OAK-WJR/mooon-whiteboard-robot/hardware/top_board_v2/BATTERY_SELECTION.md

# Battery selection and power redesign — 2026-09-07

> **Superseded since 2026-10-28:** the current board `top_board_v2_logic` (EasyEDA) charges the 2S battery over USB-C on the board with an IP2326, and on 2026-10-29 the CH343G was removed in favor of the C6's native USB; see [hardware/README.md](../README.md). The external charging and "the top board does not charge" below are records from 2026-09.

**Latest requirement: the user has agreed to external charging; the current basis is the [low-cost top board simplification plan](jlc_budget_6v/KISS_SCOPE.md) and the [external charging kit](jlc_budget_6v/external_charging/README.md). The new top board drops on-board charging, balancing and the on-robot charging port. The ready-made module, R3, on-board USB charging and 12V compatibility content below are all historical records and are no longer current requirements.**

The user has chosen the **GAONENG GNB8502S80A: 2S 7.4V, 850mAh, 80C, XT30**, and asked to solve charging, purchase cost, Amazon availability and fixing the battery to the PCB. The new circuit is designed around this battery; it has not passed whole-robot release, and has not been ordered.

Manufacturer specs: 60 × 30 × 16 mm, 56 ± 2 g, nominal energy 6.29 Wh, XT30 discharge connector. The manufacturer's current page is for a multi-pack, so its price must not be mistaken for a single-battery price. [Manufacturer product page](https://www.gaoneng.shop/products/gaoneng-gnb-2s-7.4v-850mah-80c-xt30-lipo-battery).

During this round's cost re-check, the manufacturer's page for the same model clearly lists a charge rate of **1C–5C**. This updates the earlier information where the rate was unconfirmed, but it is not the current this board can provide: the existing R3 only has a low-current USB input draft, the charge enable R503 is not fitted, and per-cell protection and interlocks are still not done. The charge setting was not raised and actual charging was not authorized on this basis; the temperature range, maximum per-cell voltage, low-voltage recovery and actual battery state still need to be confirmed separately.

The original candidate was the four separate 1S 3.7V, 2000mAh, 1C, PH2.0 protected batteries in the listing title the user provided. Using the title's 1C discharge marking, each is about 2A and nominally 7.4Wh. No manufacturer datasheet was obtained for this battery; the continuous/pulse definitions, protection cutoff current, wire gauge and polarity were not confirmed. Assuming 85% boost efficiency, one cell at 3.7V and 2A can only provide about 6.29W: about 1.05A at 6V and about 0.52A at 12V, before subtracting the logic supply; this is not a measured result. [C-rate definition](https://learn.sparkfun.com/tutorials/what-is-a-battery/all?print=1).

The 2S 850mAh has about 85% of the original candidate's energy; it does not have only 43% of the run time just because 850 is less than 2000. Motor load, conversion efficiency and cutoff voltage are not yet known, so no specific run time in minutes can be promised. 80C is the manufacturer's rating; the 68A it works out to must not be taken as a current the connector, protection or PCB can carry continuously.

Selection direction: a small 2S power battery with the standard 4.2V/cell, avoiding an overly long battery chosen only for capacity. The current selection is for three 6V GA12-N20 encoder motors; the earlier MECCANIXITY 12V model is kept only as a historical reference. For the exact links and the limits of reusing the base board, see [base board and motor review](bottom_board_review/README.md). The exact stall current and encoder harness definition are still to be confirmed; generic N20 current parameters are not borrowed.

Circuit changes that must be made:

- The new battery input and protection are designed for the 2S working voltage; use a matching XT30 connector and check the connector view and polarity. The current R2's BAT 1S, TP4056 and ME6217 power path **cannot be connected directly to this 2S battery**.
- A fixed 6V is produced by a ready-made buck module, and the battery voltage is not connected directly to the 6V motors; module choice, default shutdown, current limiting and regeneration handling still need to be finalized.
- USB charging must change to a 2S charging solution, with per-cell voltage sensing, balancing and protection; this power battery's built-in BMS/protection is not confirmed by the manufacturer's page, so the original candidate's "integrated protection" description cannot be reused.
- The main logic supply needs USB/battery power switching and power-off isolation; a separate USB recovery bridge has been integrated into the R3 schematic review draft, and its electrical margins and real-board timing have not been verified.
- The same USB-C port handles data and charging. Computer USB, enumeration not finished, suspend, and different Type-C current advertisements must each be handled; not all USB power is treated as 3A.
- The cost count includes the battery, on-board charging and protection, USB recovery, battery and balance connectors, wires, and straps/brackets; mark pack quantities, and separate component reference prices from whole-board assembly cost.
- The current top board's outline bounding box is 62.411 × 54.229 mm, and the shape is a truncated triangle. A 60 × 30 mm battery cannot be claimed to fit fully inside the board outline from the bounding box size alone; mounting position, thickness, wire bending space and antenna distance are to be verified.
- The fixing method should have an insulating support surface and controlled clamping force, so straps do not press on components, solder joints or the corners of the pouch battery; slots must be checked against copper layers, board edge margins, mating connectors and the antenna area.

Options not chosen: the Gens ace 2S 2200mAh 60C hard-case model is 92.8 mm long and about 107g, too long; the Tattu 3S 850mAh 75C is 60 × 30 × 23 mm and about 80g, thicker and heavier; the Tattu 2S 650mAh 75C is 57 × 31 × 12 mm and about 43g, and can serve as a thinner backup with less energy. The manufacturer pages are [Gens ace](https://www.genstattu.com/gens-ace-2200mah-2s-60c-7-4v-hardcase-g-tech-lipo-battery-pack-with-xt60-plug/), [Tattu 3S](https://genstattu.com/tattu-850mah-11-1v-75c-3s1p-lipo-battery-pack-with-xt30-plug.html), [Tattu 2S](https://www.tattuworld.com/products/tattu-classic-650mah-2s1p-7-4v-75c-fpv-lipo-battery.html).

This choice does not change the R2 files or their not-released-for-manufacturing status. The final battery/protection/power stage match will be made after the stall current and mounting space of the exact motor version above are confirmed.

Follow-up check results:

- [Procurement record](procurement/SOURCING.md): the GNB official site shows a four-pack at $34.40, or $8.60 each; Amazon stock of the exact model was not verified. A standard Tattu 2S Amazon catalog candidate is kept; the battery was not swapped without permission.
- [Cost update](procurement/R3_COST_UPDATE.md): the 16 priced core chips and two inductors total $37.92; adding the planned protection chip at $5.63 and one battery's share at $8.60 gives a reference subtotal of $52.15. The full parts list, motor power, PCB, assembly, fixings, shipping and tax are still missing; this is not a whole-board quote.
- [Mounting study](mounting/MOUNTING_REVIEW.md): a nominal 60×30 mm battery cannot fit fully inside the existing triangular board outline at any in-plane rotation angle. The chosen direction is a raised insulating bracket; in the current projection example the max overhang is about 9.62 mm; the actual enclosure space and height are to be confirmed.
- A separate [R3 mechanical layout draft](kicad/r3_mechanical/README.md) has been generated, with four bracket holes and four-layer keep-out areas, keeping the original board outline and 19 mating pins. It is not routed yet and is not a finished, modified circuit.
- The current charging implementation direction is BQ25798 + separate per-cell protection/balancing, and power and protection still need full integration; the [initial charging research](charging_research/CHARGING_DECISION.md) keeps the BQ25883 comparison and protection limits. Plugging in USB stops the motors by default, but an explicitly authorized, time-limited USB motor bench test is allowed; during the test, power comes from the protected battery, and charging is actively inhibited.
