OAK-WJR/mooon-whiteboard-robot/hardware/top_board_v2/jlc_budget_6v/controller_core/logic/ADC_POWER_OFF_REVIEW.md

# Power-off check of the top voltage sensing

The current two 120kΩ/10kΩ dividers and 100nF filters still connect directly to C6 GPIO4/5. **No power-off isolation has been added yet, and there is no actual injection current test.** This check quantifies the conditions still to be solved; the analog switch was not added directly to the board BOM.

Done later: [a specific candidate with 20kΩ on each side of the switch, and its simulation](adc_isolation_review/README.md): the nominal ratio stays 13, a bleed is added on the MCU side, and the 100nF stays before the switch. 32 analytic combinations and 6 ngspice condition models found gaps with a fast supply drop and with the filter capacitor position, so the candidate has not been added to the main drawing yet. These are generic models; the chip manufacturer's full transient model was not used, and no real-board power-off pass conclusion was obtained.

Under the calculation condition that the MCU pin does not load the divider, and counting the resistors' initial ±1%, an 8.4V input gives at most about 0.6582V at the sense point; at VMOT=6.2188V it is about 0.4873V. Losing the controller supply does not make these external inputs go away by itself.

If, only for sensitivity analysis, the pin is assumed to be clamped at 0.3V by some path, the dividers could still supply about 38.48µA and 20.12µA respectively. **0.3V is an assumption of this example; it is neither a measured clamp characteristic nor an injection current the manufacturer allows.** The 50nA input current and VDD+0.3V conditions in C6 table 5-4 are listed in the DC characteristics at 3.3V and 25°C, and cannot be extrapolated to an allowed injection current at VDD=0 or to absolute maximum ratings. The manual gives no power-off Ioff guarantee in these tables that could be used for this design. [Espressif C6 v1.5 §5.1, §5.4](https://www.espressif.com/sites/default/files/documentation/esp32-c6_datasheet_en.pdf).

As one specific solution direction, the TI TMUX1511 was checked; it has not been chosen for the design. It allows 0–3.6V on the signal pins when VDD<1.5V; with VDD=0, source 0–3.6V and drain 0V, the max absolute power-off leakage is 2µA. The max 4µs power-off time in the manual has explicit conditions of a 1µs supply drop, 200Ω load and 15pF capacitance, and cannot be applied directly to the top board's power-off waveform. [TI TMUX1511 Rev.B §5.3, §5.5, §5.7](https://www.ti.com/lit/ds/symlink/tmux1511.pdf).

The later circuit must solve all of these together: the bleed path on the MCU side after isolation and the change in divider load, the charge the 100nF capacitor keeps at the moment of power-off, the actual supply drop of the controller and the switch, and the cost of the new part. Only putting an analog switch in series in the current drawing is not enough to prove the whole power-off process passes. This part is not currently chosen, and no extended part fees were added. The [ADC read-only firmware](ADC_READOUT.md) is implemented, but it cannot confirm the power-off electrical behavior.

[The matching values, conditions and source file hashes](verification/adc_power_off_review.json). This check is circuit analysis, not a transient simulation of the switch chip, real fault injection, or a board stability pass result.

After the ADC comment update, the original numeric report is kept; the evidence that the electrical parameters did not change is in the [revision link](verification/adc_revision_evidence.json).
