OAK-WJR/mooon-whiteboard-robot/docs/design-history/v1-schematic.jpg

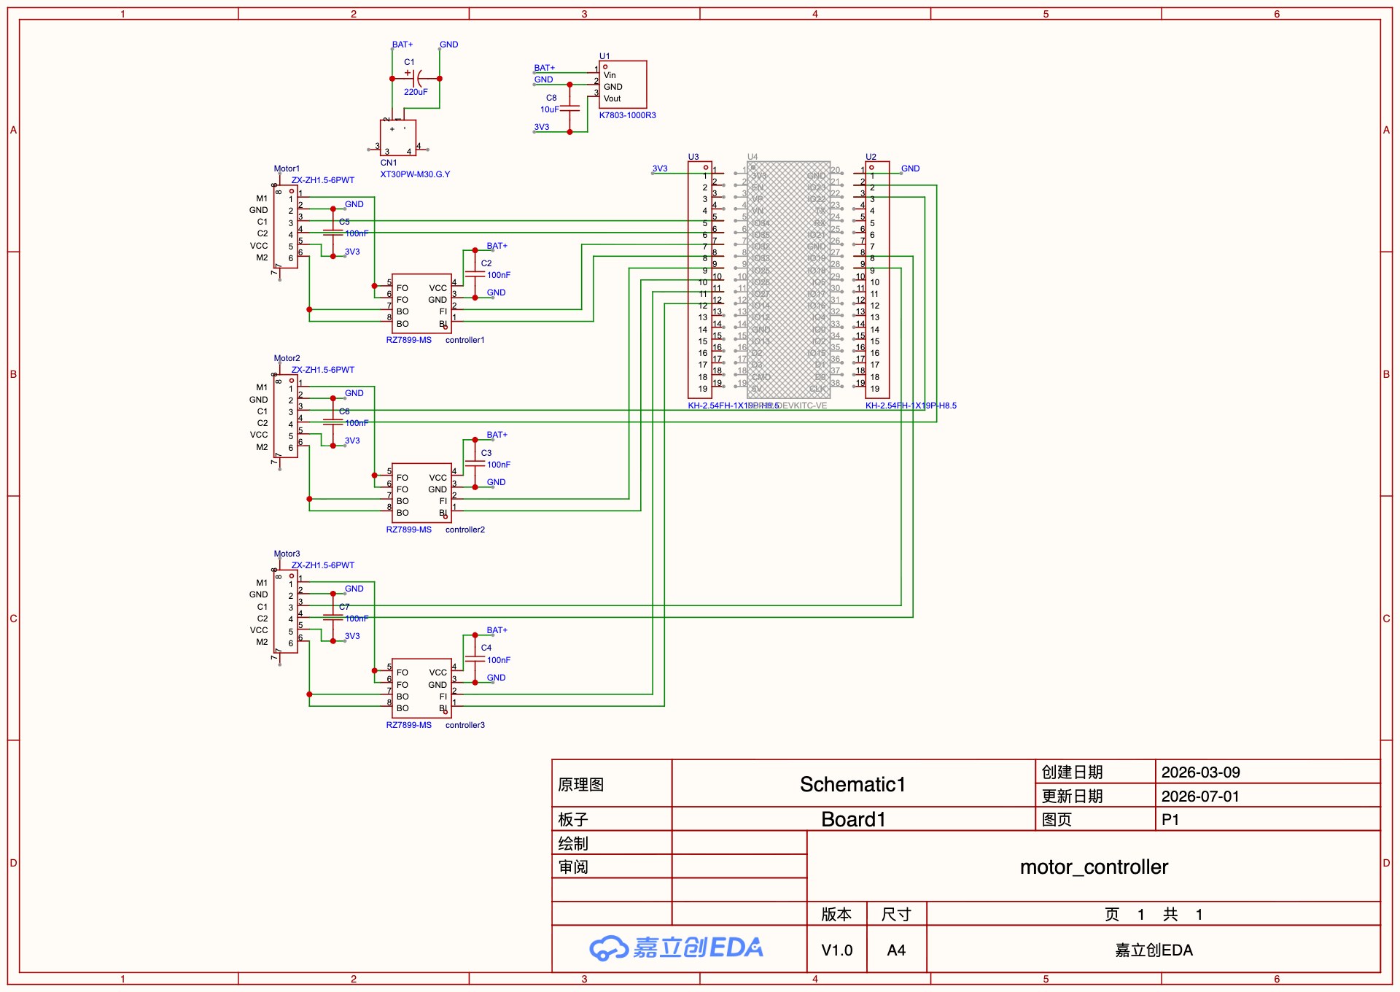
docs/design-history/v1-schematic.jpg
