OAK-WJR/mooon-whiteboard-robot/docs/media/coverage-run-final.jpg

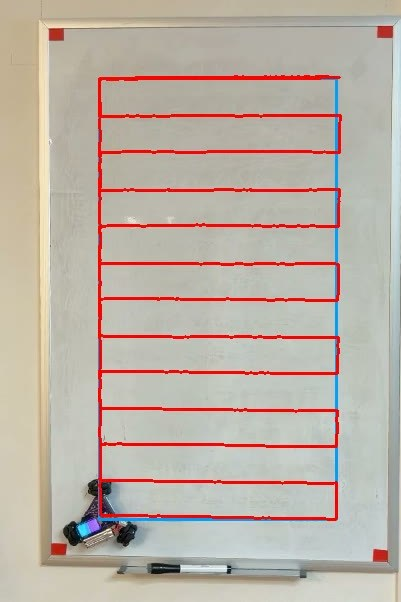
docs/media/coverage-run-final.jpg
