OAK-WJR/mooon-whiteboard-robot/hardware/top_board_v2/bottom_board_review/bottom_schematic.webp

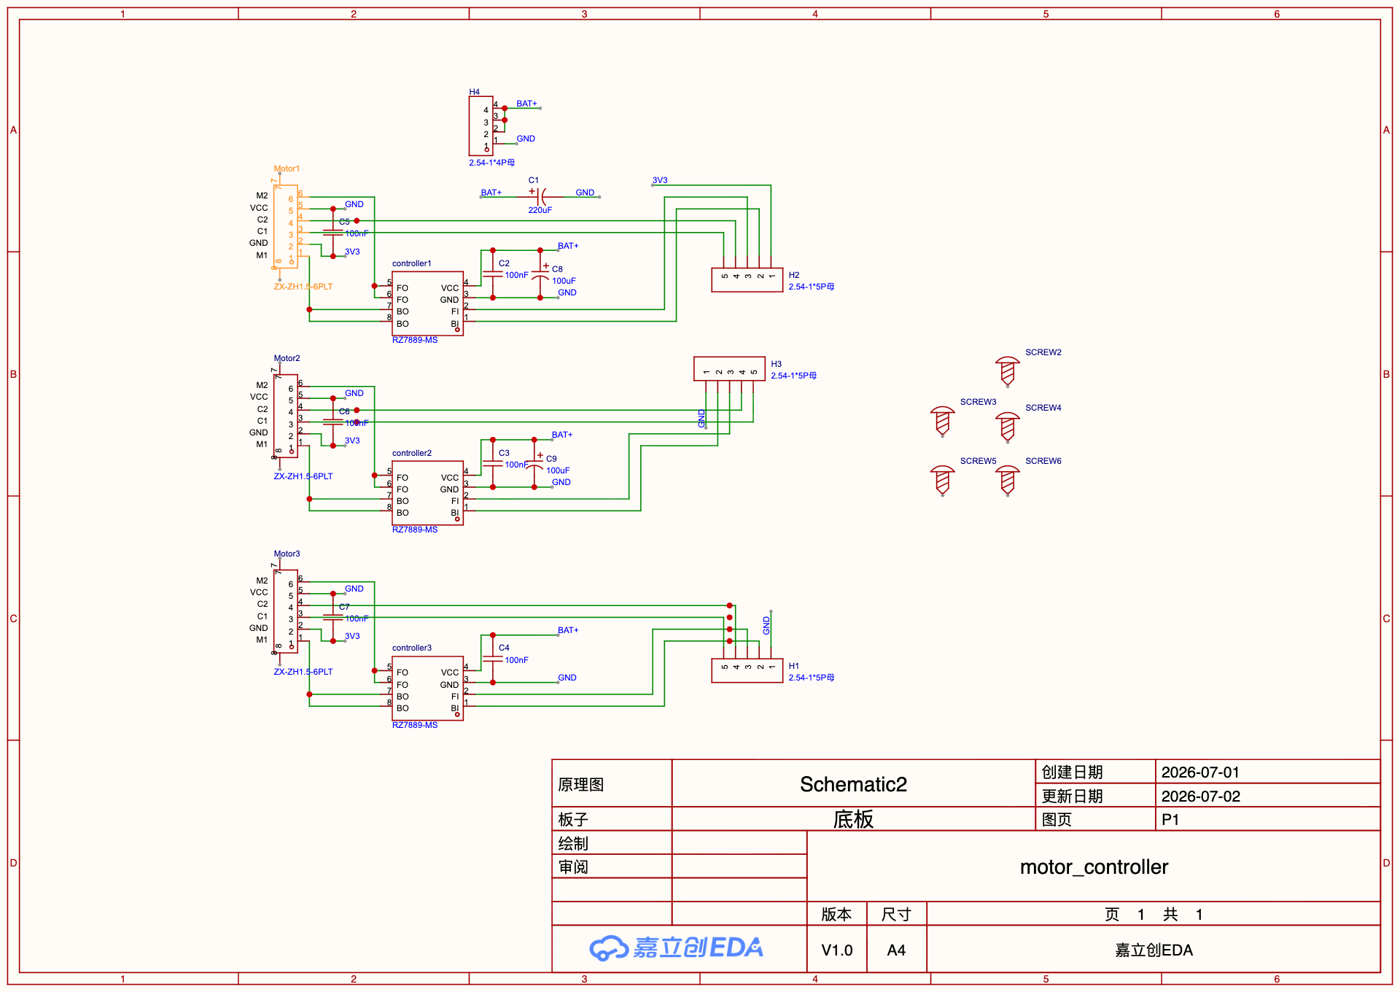
hardware/top_board_v2/bottom_board_review/bottom_schematic.webp
