OAK-WJR/mooon-whiteboard-robot/hardware/top_board_v2/jlc_budget_6v/controller_core/logic/preview/placement.png

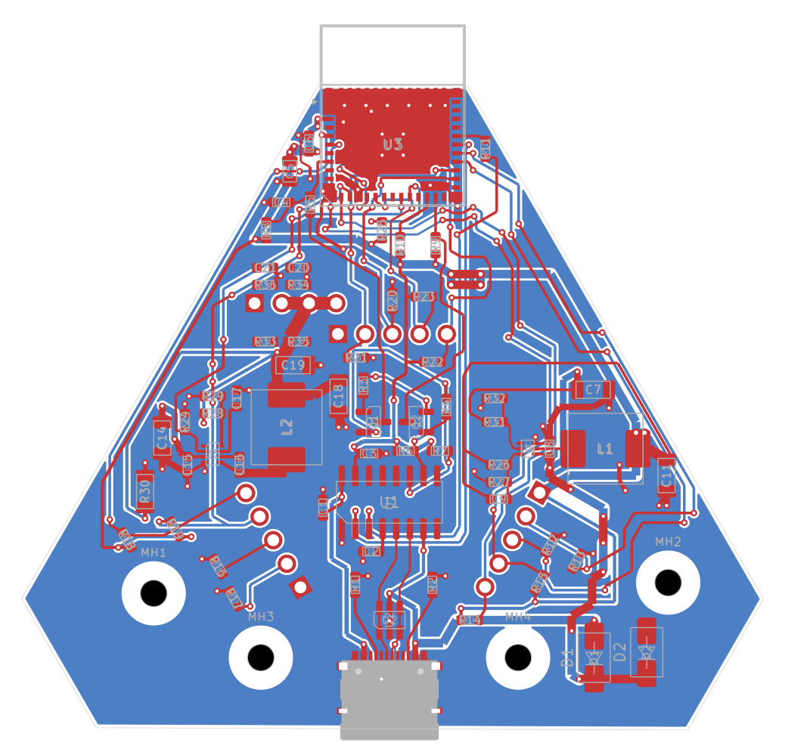
hardware/top_board_v2/jlc_budget_6v/controller_core/logic/preview/placement.png
