OAK-WJR/mooon-whiteboard-robot/hardware/top_board_v2/kiss_6v/electrical_layout/carrier_preview.png

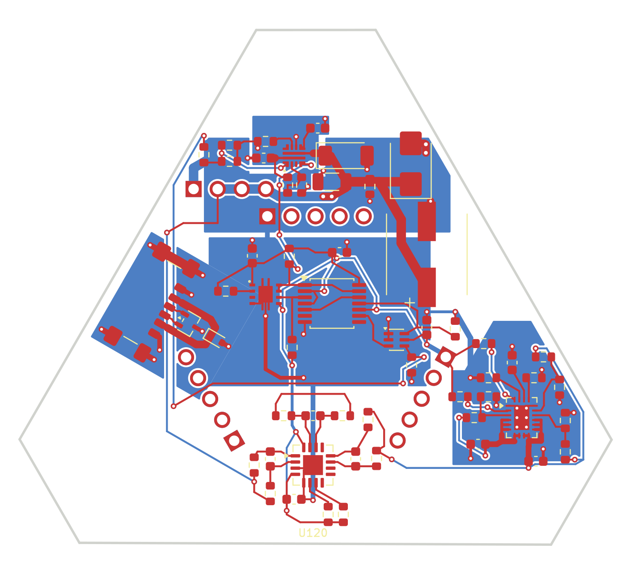
hardware/top_board_v2/kiss_6v/electrical_layout/carrier_preview.png
