OAK-WJR/mooon-whiteboard-robot/hardware/top_board_v2/kiss_6v/module_fit.png

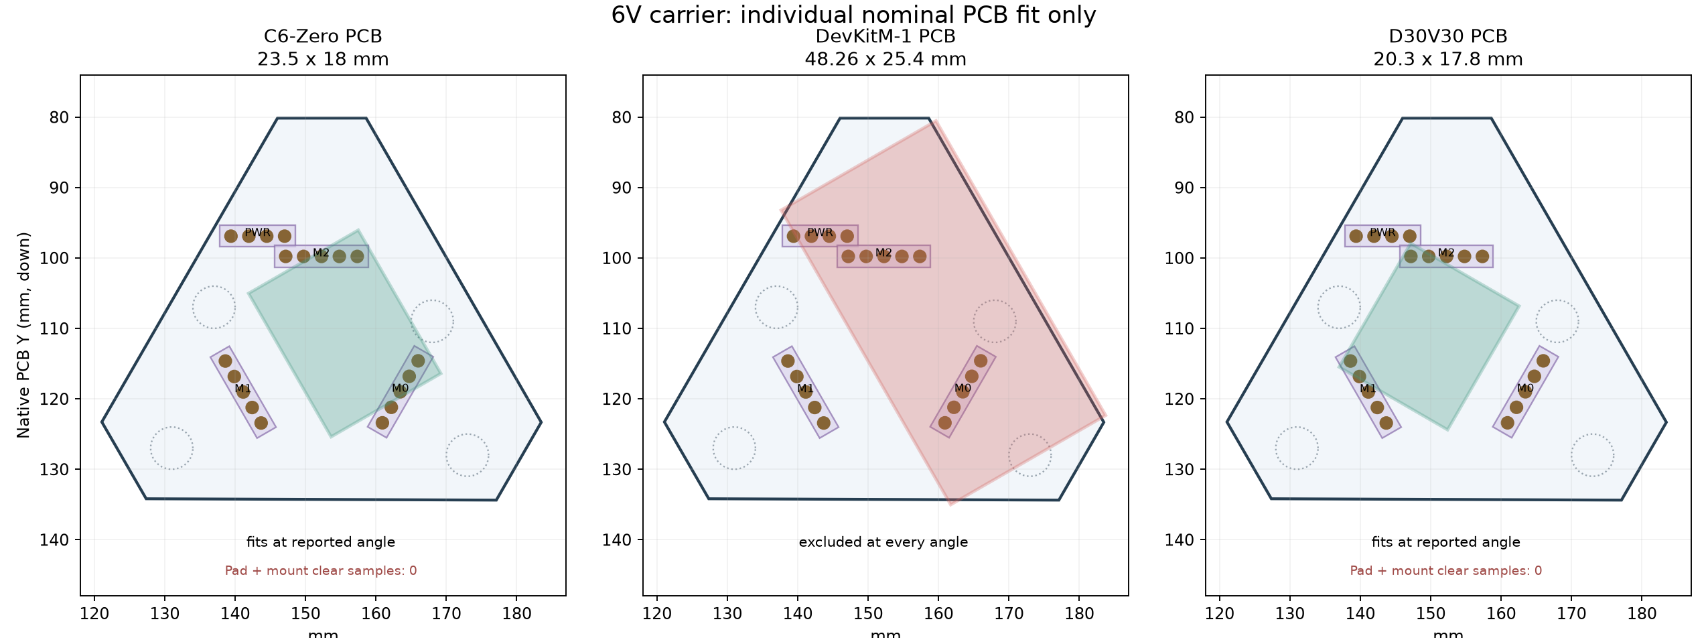
hardware/top_board_v2/kiss_6v/module_fit.png
