OAK-WJR/mooon-whiteboard-robot/hardware/top_board_v2/versions/20261027-curved-eda-canvas.png

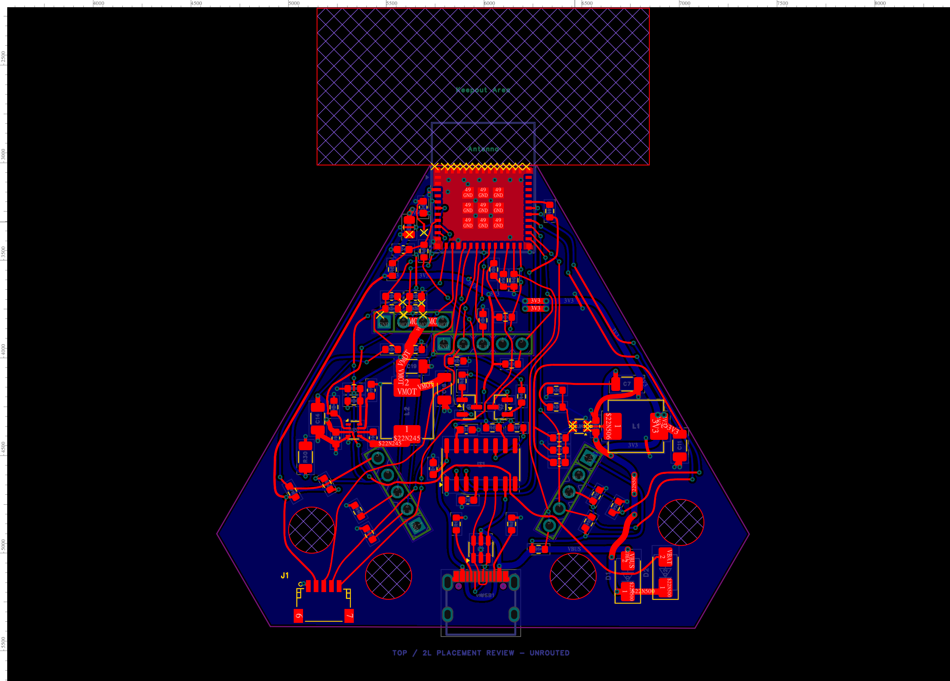
hardware/top_board_v2/versions/20261027-curved-eda-canvas.png
