OAK-WJR/mooon-whiteboard-robot/hardware/top_board_v2/versions/schematic_a3_v2.1.png

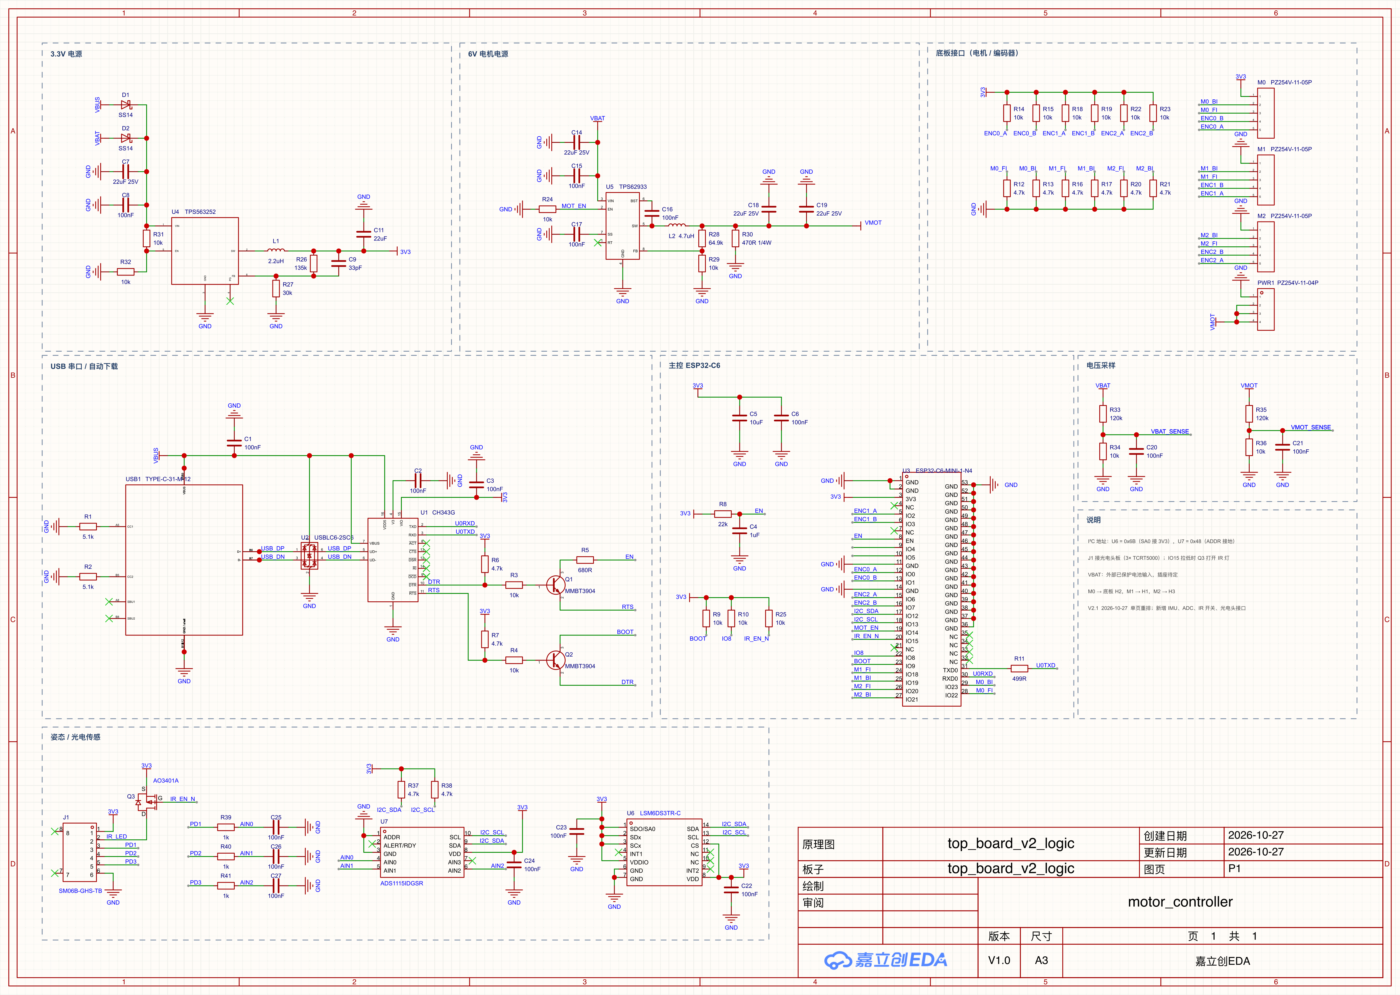
hardware/top_board_v2/versions/schematic_a3_v2.1.png
