OAK-WJR/mooon-whiteboard-robot/c6_wall/results/sysid-erase-1028-214624-erase.jpg

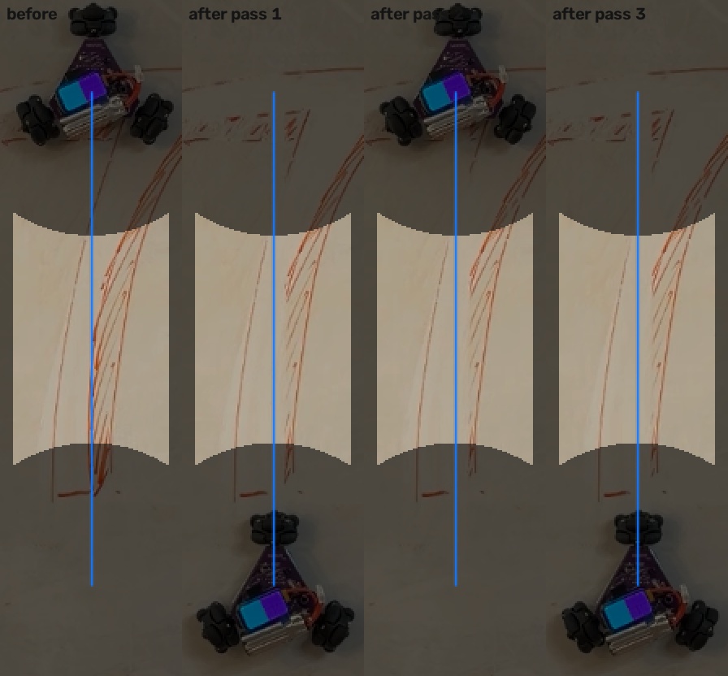
c6_wall/results/sysid-erase-1028-214624-erase.jpg
