OAK-WJR/mooon-whiteboard-robot/hardware/top_board_v2/validation/kicad_top.png

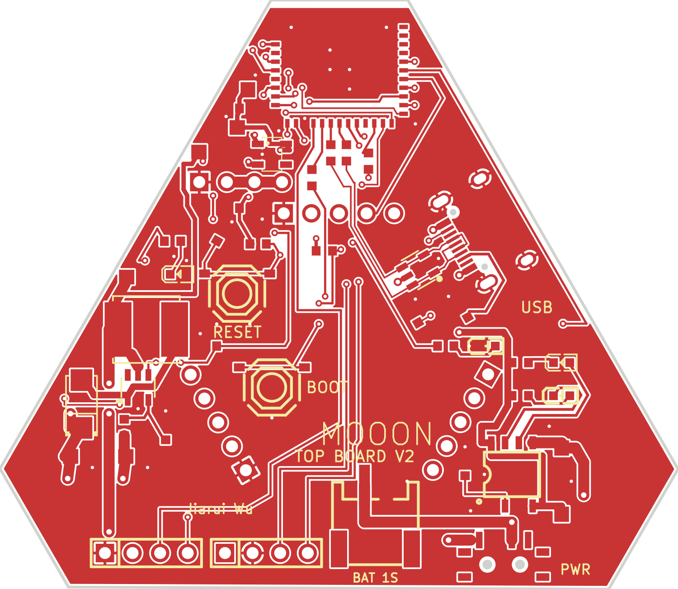
hardware/top_board_v2/validation/kicad_top.png
