OAK-WJR/mooon-whiteboard-robot/docs/design-history/README.md

# Design history

This page shows how the robot's mechanical design and circuit boards changed
over time, with evidence for each date.

## Where the images come from

- **EasyEDA previews.** EasyEDA Pro saves a preview of every schematic and PCB
  inside the project file each time the project is saved. Most images on this
  page are those previews, taken from
  [`hardware/top_board_v2/motor_controller.epro2`](../../hardware/top_board_v2/motor_controller.epro2).
  No image here was redrawn by hand.
- **Reproducible.** [`make_figures.py`](make_figures.py) rebuilds every figure
  directly from the git history of that file. It needs the full-history
  repository; this curated snapshot has only one version of the file:

  ```bash
  python3 docs/design-history/make_figures.py   # needs Pillow
  ```

- **Live capture.** `logic-pcb-live-2026-10-28.png` was captured from the
  running EasyEDA editor on 2026-10-28 through the EasyEDA API.

Dates come from three sources. Each caption says which one it uses:

1. **Schematic title blocks.** EasyEDA fills in the creation and update dates
   automatically.
2. **Commit timestamps** of the project file.
3. **The EasyEDA backup file names**, which carry the save time.

The October commits were added to git on 2026-10-28 from those timestamped
backups, in the full-history repository.

## Mechanical CAD (Onshape)

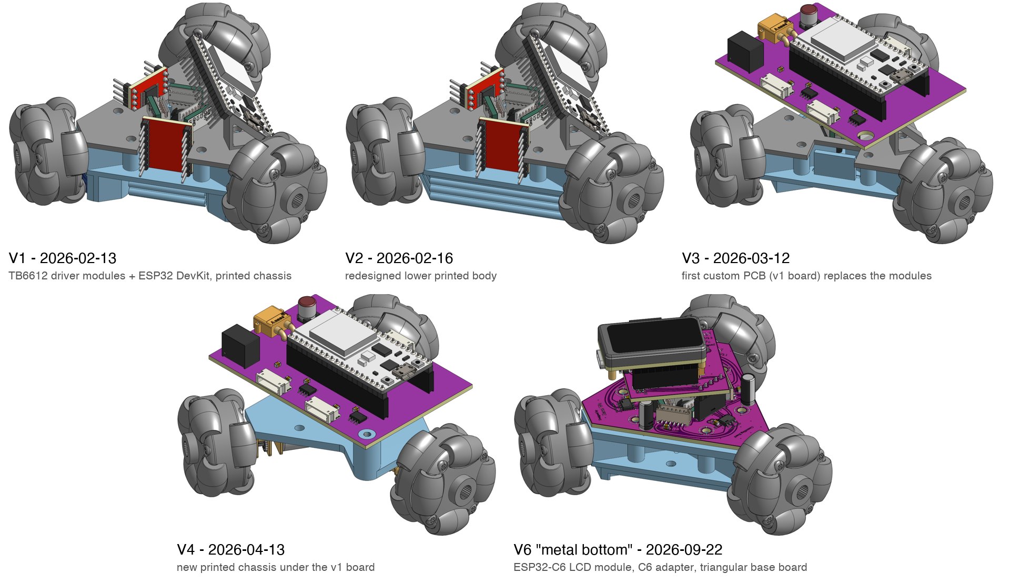
[picture p18: docs/design-history/cad-versions.jpg]
Onshape versions of the robot assembly


The robot is modelled in an Onshape document named "WhiteBoardBot", created on
2026-02-08. Onshape timestamps every named version on its own servers, so
these dates cannot be edited afterwards. Each render above is Onshape's shaded
view of the assembly "Assembly 1" at that version, fetched through the Onshape
API on 2026-10-28 with every part shown, including parts that were hidden
when the version was saved. Full-size renders are in [`cad/`](cad/).

| Version | Created (Onshape server time, UTC) | What changed |
|---|---|---|
| Start | 2026-02-08 19:05 | Empty document |
| V1 | 2026-02-13 21:26 | Off-the-shelf modules: two TB6612 driver boards and an ESP32 DevKit on a printed chassis, with 38 mm omni wheels and N20 motors |
| V2 | 2026-02-16 02:41 | Redesigned lower printed body |
| V3 | 2026-03-12 19:40 | The first custom PCB, imported as `3D_PCB1_2026-03-10.step` from EasyEDA, replaces the modules |
| V4 | 2026-04-13 19:39 | New printed chassis under the v1 board |
| V5 | 2026-07-03 21:44 | (same appearance as V4) |
| V6 "metal bottom" | 2026-09-22 03:08 | ESP32-C6 LCD module on the custom adapter board, on the triangular base board |
| V7 "fix the issue of gear stuck because of too tight top" | 2026-09-22 03:13 | Fixed the gears sticking because the top part was too tight |
| Workspace | last edit 2026-10-27 | Looks the same as V6 when every part is shown |

The CAD and the circuit-board dates agree:
- The first custom PCB was created in EasyEDA on 2026-03-09 (title block), and
  its 3D model is dated 2026-03-10.
- It appears in the CAD at V3, on 2026-03-12.

## Board generations

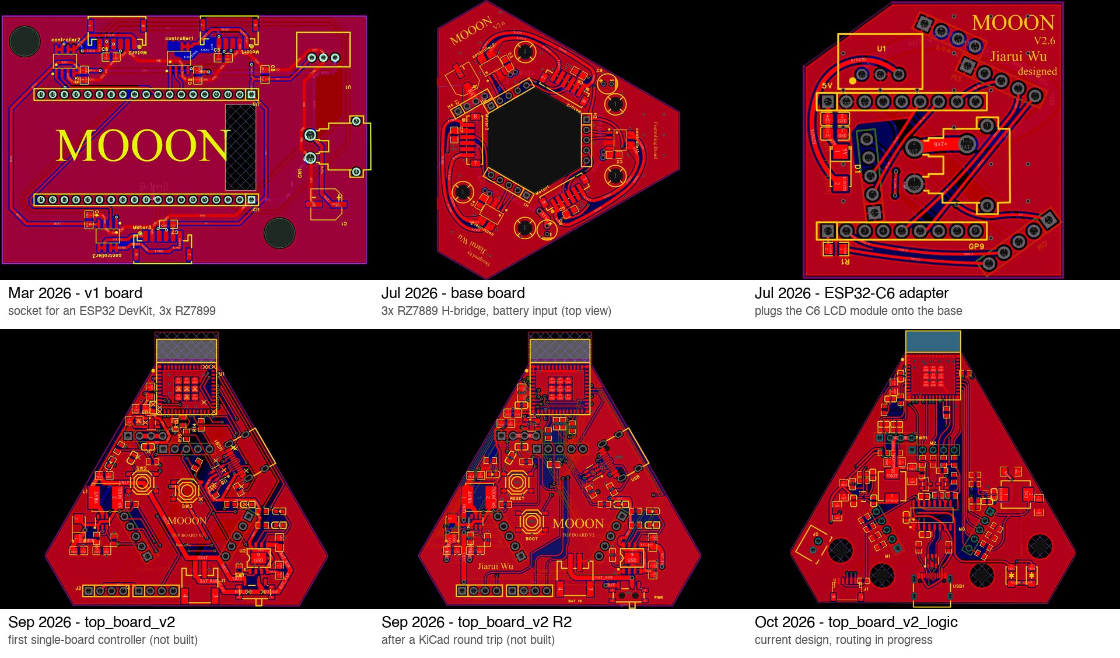
[picture p19: docs/design-history/board-generations.jpg]
Board generations


| Board | Dates (from the title block) | Notes |
|---|---|---|
| v1 board | created 2026-03-09 | Socket for a 38-pin ESP32 DevKit and three RZ7899 drivers. Its saved preview had inactive layers greyed out, so its contrast is stretched in the figure. Motor 1's encoder pins (GPIO36/39) picked up PWM noise, which led to the next generation. [Schematic](v1-schematic.jpg), [netlist](../../hardware/v1_base_board/). |
| base board (`bottom_board`) | created 2026-07-01 | Triangular base with three RZ7889 H-bridges and the battery input. Still in use. Its own preview is a bottom view, so the figure shows its top view from the fabrication panel (`combine`). |
| ESP32-C6 adapter (`top_board`) | created 2026-07-02, updated 2026-07-03 | Carries the Waveshare ESP32-C6-LCD module. The first fabricated adapter had the M1 header placed rotated 180°. The respin was brought up on 2026-09-17 and is in use now. |
| `top_board_v2`, R2 | September 2026 | First attempts at one integrated controller board. Never fabricated. |
| `top_board_v2_logic` | 2026-10-27 → | Current design: ESP32-C6-MINI-1 on native USB (CH343G removed 2026-10-29), 3.3 V and 6 V supplies, on-board 2S charging (IP2326) and INA180 motor-current sensing. |

The September directions that were explored in KiCad and dropped are covered
in [`hardware/README.md`](../../hardware/README.md#earlier-top-board-directions-not-fabricated):

| Direction | Image |
|---|---|
| R2, 4-layer | [image](../../hardware/top_board_v2/validation/kicad_top.png) |
| "KISS" 6V module carrier | [image](../../hardware/top_board_v2/kiss_6v/electrical_layout/carrier_preview.png) |
| Module-fit study | [image](../../hardware/top_board_v2/kiss_6v/module_fit.png) |
| Low-cost placement | [image](../../hardware/top_board_v2/jlc_budget_6v/controller_core/logic/preview/placement.png) |

## `top_board_v2_logic`, step by step (2026-10-27 → 2026-10-28)

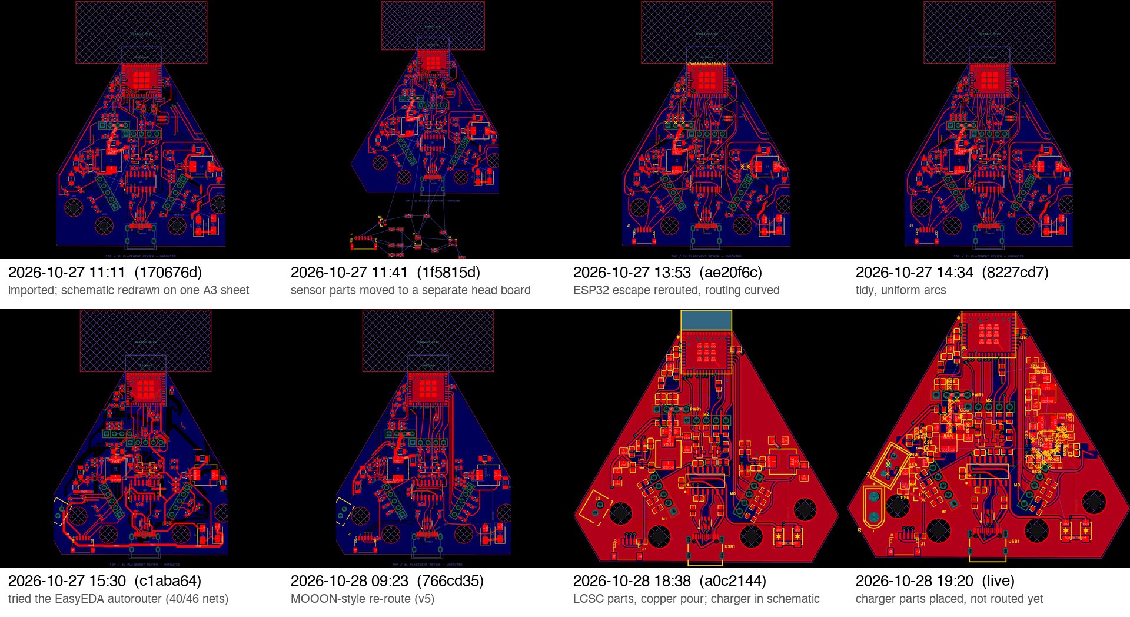
[picture p20: docs/design-history/logic-board-evolution.jpg]
Logic board evolution


Each frame is the PCB preview stored in the project file at that commit. The
last frame is the live editor. In the full-history repository, the full
message for any frame can be seen with:

```bash
git show <hash> --stat
```

Steps worth noting:

- **11:41, sensor head split off.** The IMU, ADC and IR emitter moved off the
  board, so their parts sit outside the outline, waiting for their own board.
- **13:53 → 14:34, curved routing.** All routing was converted to tangent
  arcs.
- **15:30, autorouter test.** EasyEDA's autorouter was tried; it completed 40
  of 46 nets and was not kept.
- **28 Oct, final steps.** A MOOON-style re-route, then a swap to LCSC-stocked
  parts with 3D models, then a copper pour. The 2S charger went into the
  schematic; it was placed and routed later (see
  [`hardware/README.md`](../../hardware/README.md)).

## Schematic: before and after

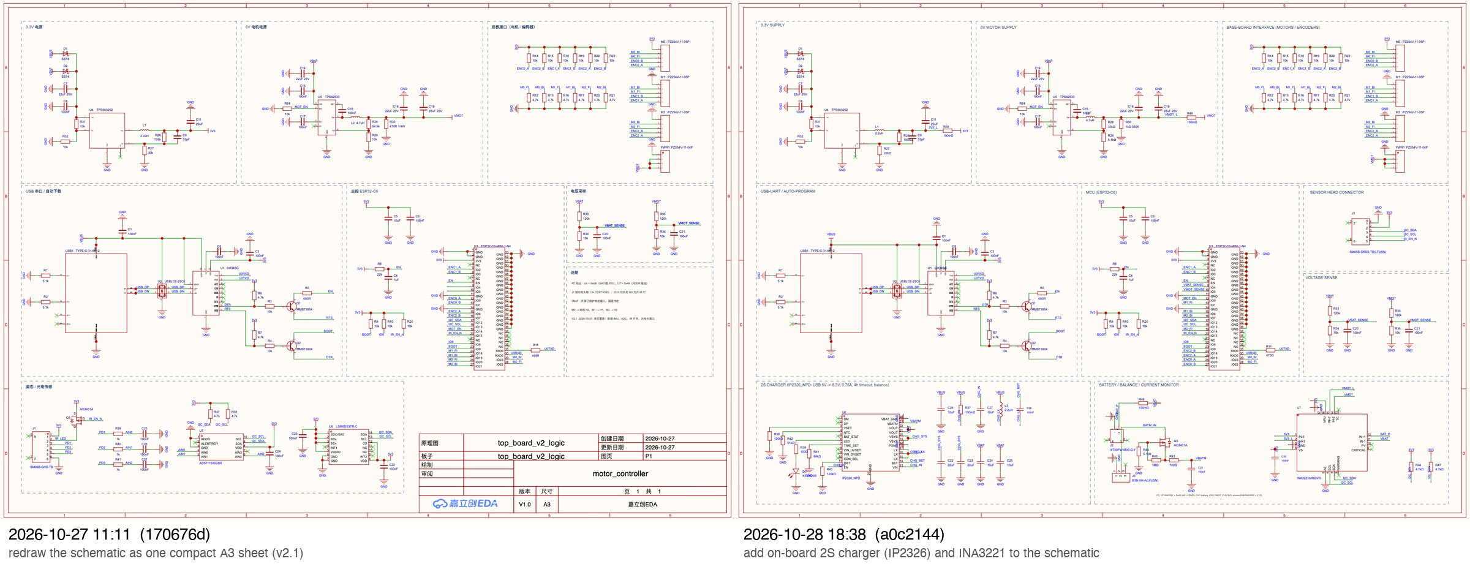
[picture p21: docs/design-history/logic-schematic-before-after.jpg]
Schematic before and after


**Left (2026-10-27):** the first compact A3 sheet. Notes are in Chinese and it
still includes the IMU/ADC sensor block.

**Right (2026-10-28):** notes translated to English. The sensor block is
replaced by:
- the 2S USB-C charger (IP2326_NPD, 8.3 V, 0.75 A, with balancing);
- the battery/balance tap;
- the INA3221 current monitor.
