OAK-WJR/mooon-whiteboard-robot/docs/design-history/cad/v1-2026-02-13.jpg

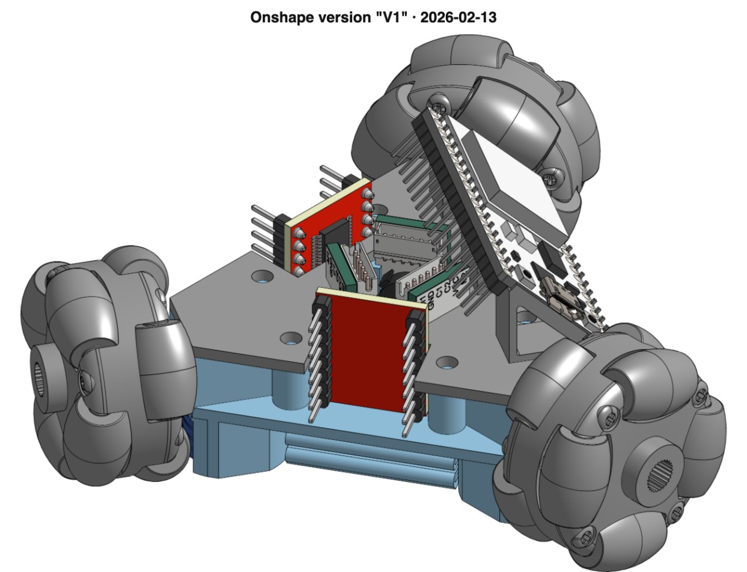
docs/design-history/cad/v1-2026-02-13.jpg
