OAK-WJR/mooon-whiteboard-robot/docs/design-history/cad/v3-2026-03-12.jpg

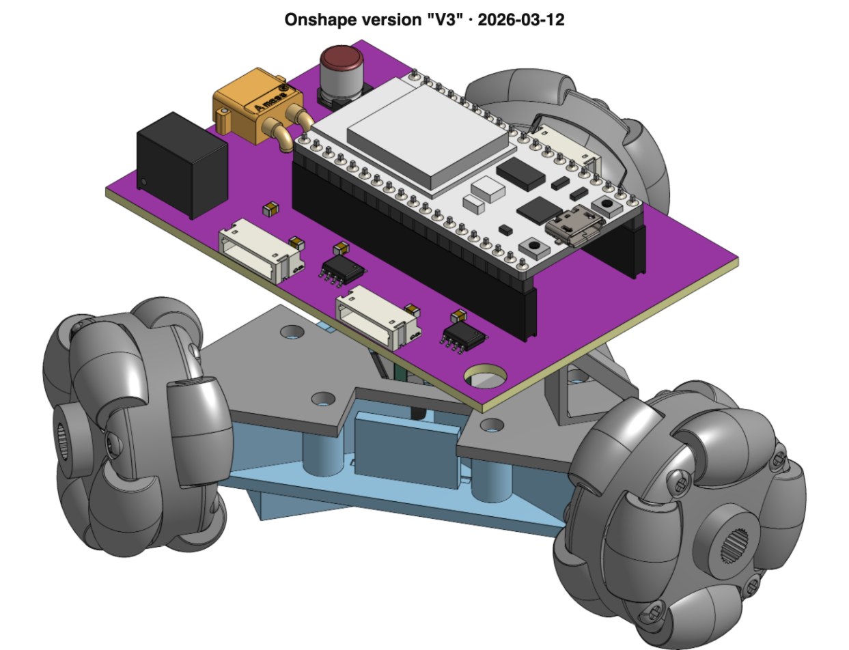
docs/design-history/cad/v3-2026-03-12.jpg
