OAK-WJR/mooon-whiteboard-robot/docs/design-history/cad/v4-2026-04-13.jpg

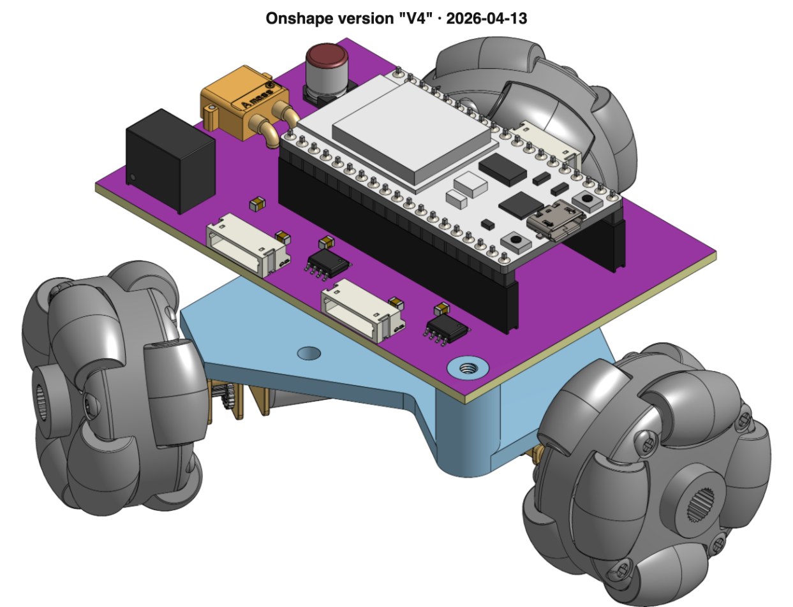
docs/design-history/cad/v4-2026-04-13.jpg
