OAK-WJR/mooon-whiteboard-robot/docs/design-history/cad/v6-2026-09-22.jpg

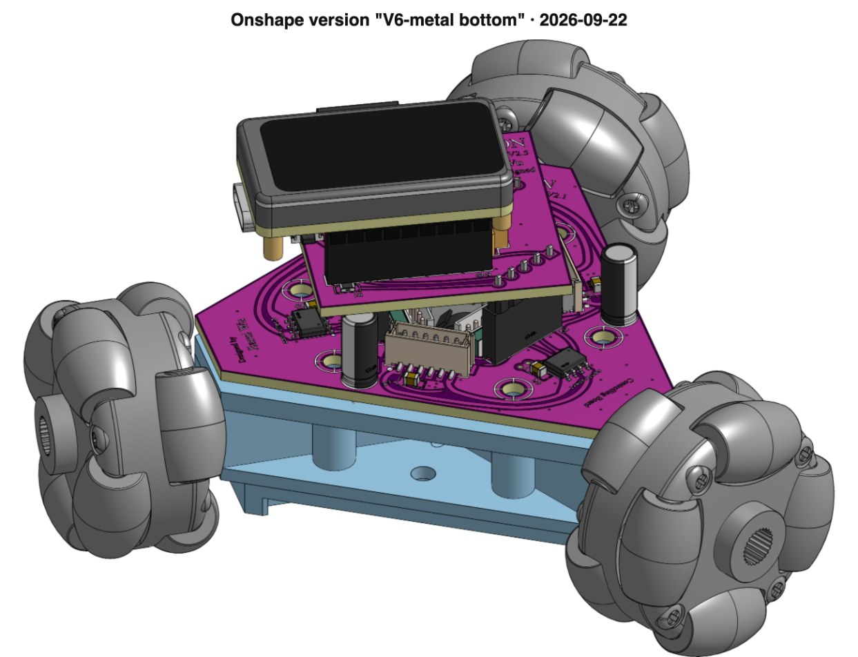
docs/design-history/cad/v6-2026-09-22.jpg
