OAK-WJR/mooon-whiteboard-robot/docs/design-history/logic-pcb-live-2026-10-28.png

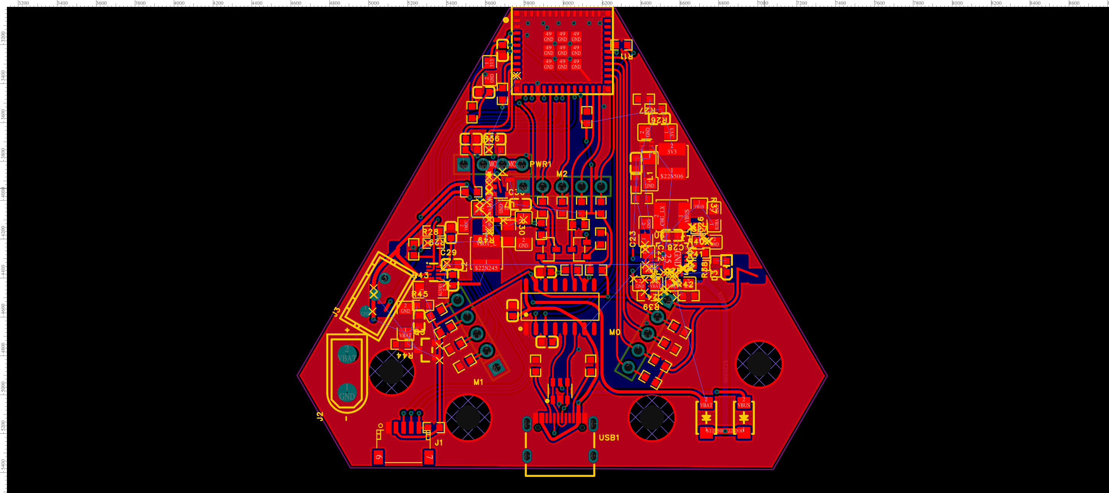
docs/design-history/logic-pcb-live-2026-10-28.png
