OAK-WJR/mooon-whiteboard-robot/(list of files, drawings)

Other design files:
hardware/top_board_v2/easyeda/logic_netlist.json
