OAK-WJR/mooon-whiteboard-robot/hardware/top_board_v2/jlc_budget_6v/controller_core/logic/top_board_v2_logic.kicad_pcb

## KiCad design hardware/top_board_v2/jlc_budget_6v/controller_core/logic/top_board_v2_logic.kicad_pcb (2026-11-02)

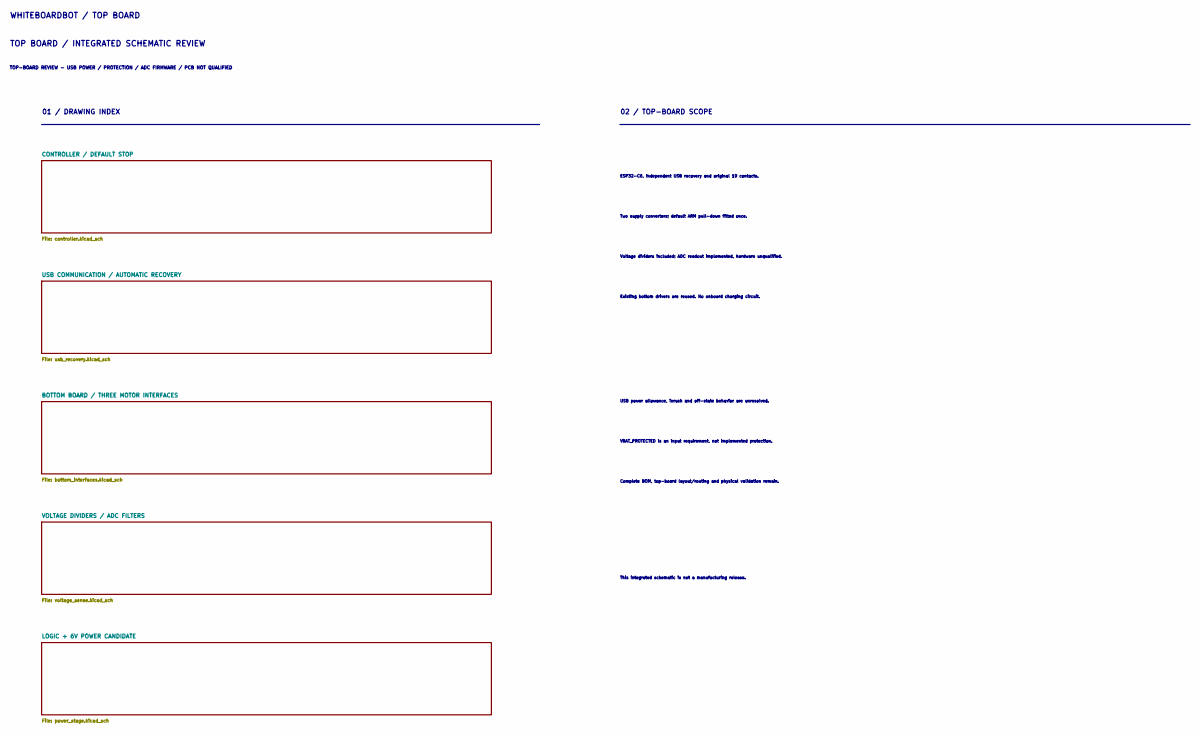
[picture p27: schematic top_board_v2_logic.kicad_sch, TOP BOARD / INTEGRATED SCHEMATIC REVIEW]

Notes on the sheet:
WHITEBOARDBOT / TOP BOARD
TOP BOARD / INTEGRATED SCHEMATIC REVIEW
TOP-BOARD REVIEW - USB POWER / PROTECTION / ADC FIRMWARE / PCB NOT QUALIFIED
01 / DRAWING INDEX
02 / TOP-BOARD SCOPE
ESP32-C6, independent USB recovery and original 19 contacts.
Two supply converters; default ARM pull-down fitted once.
Voltage dividers included; ADC readout implemented, hardware unqualified.
Existing bottom drivers are reused. No onboard charging circuit.
USB power allowance, inrush and off-state behavior are unresolved.
VBAT_PROTECTED is an input requirement, not implemented protection.
Complete BOM, top-board layout/routing and physical validation remain.
This integrated schematic is not a manufacturing release.

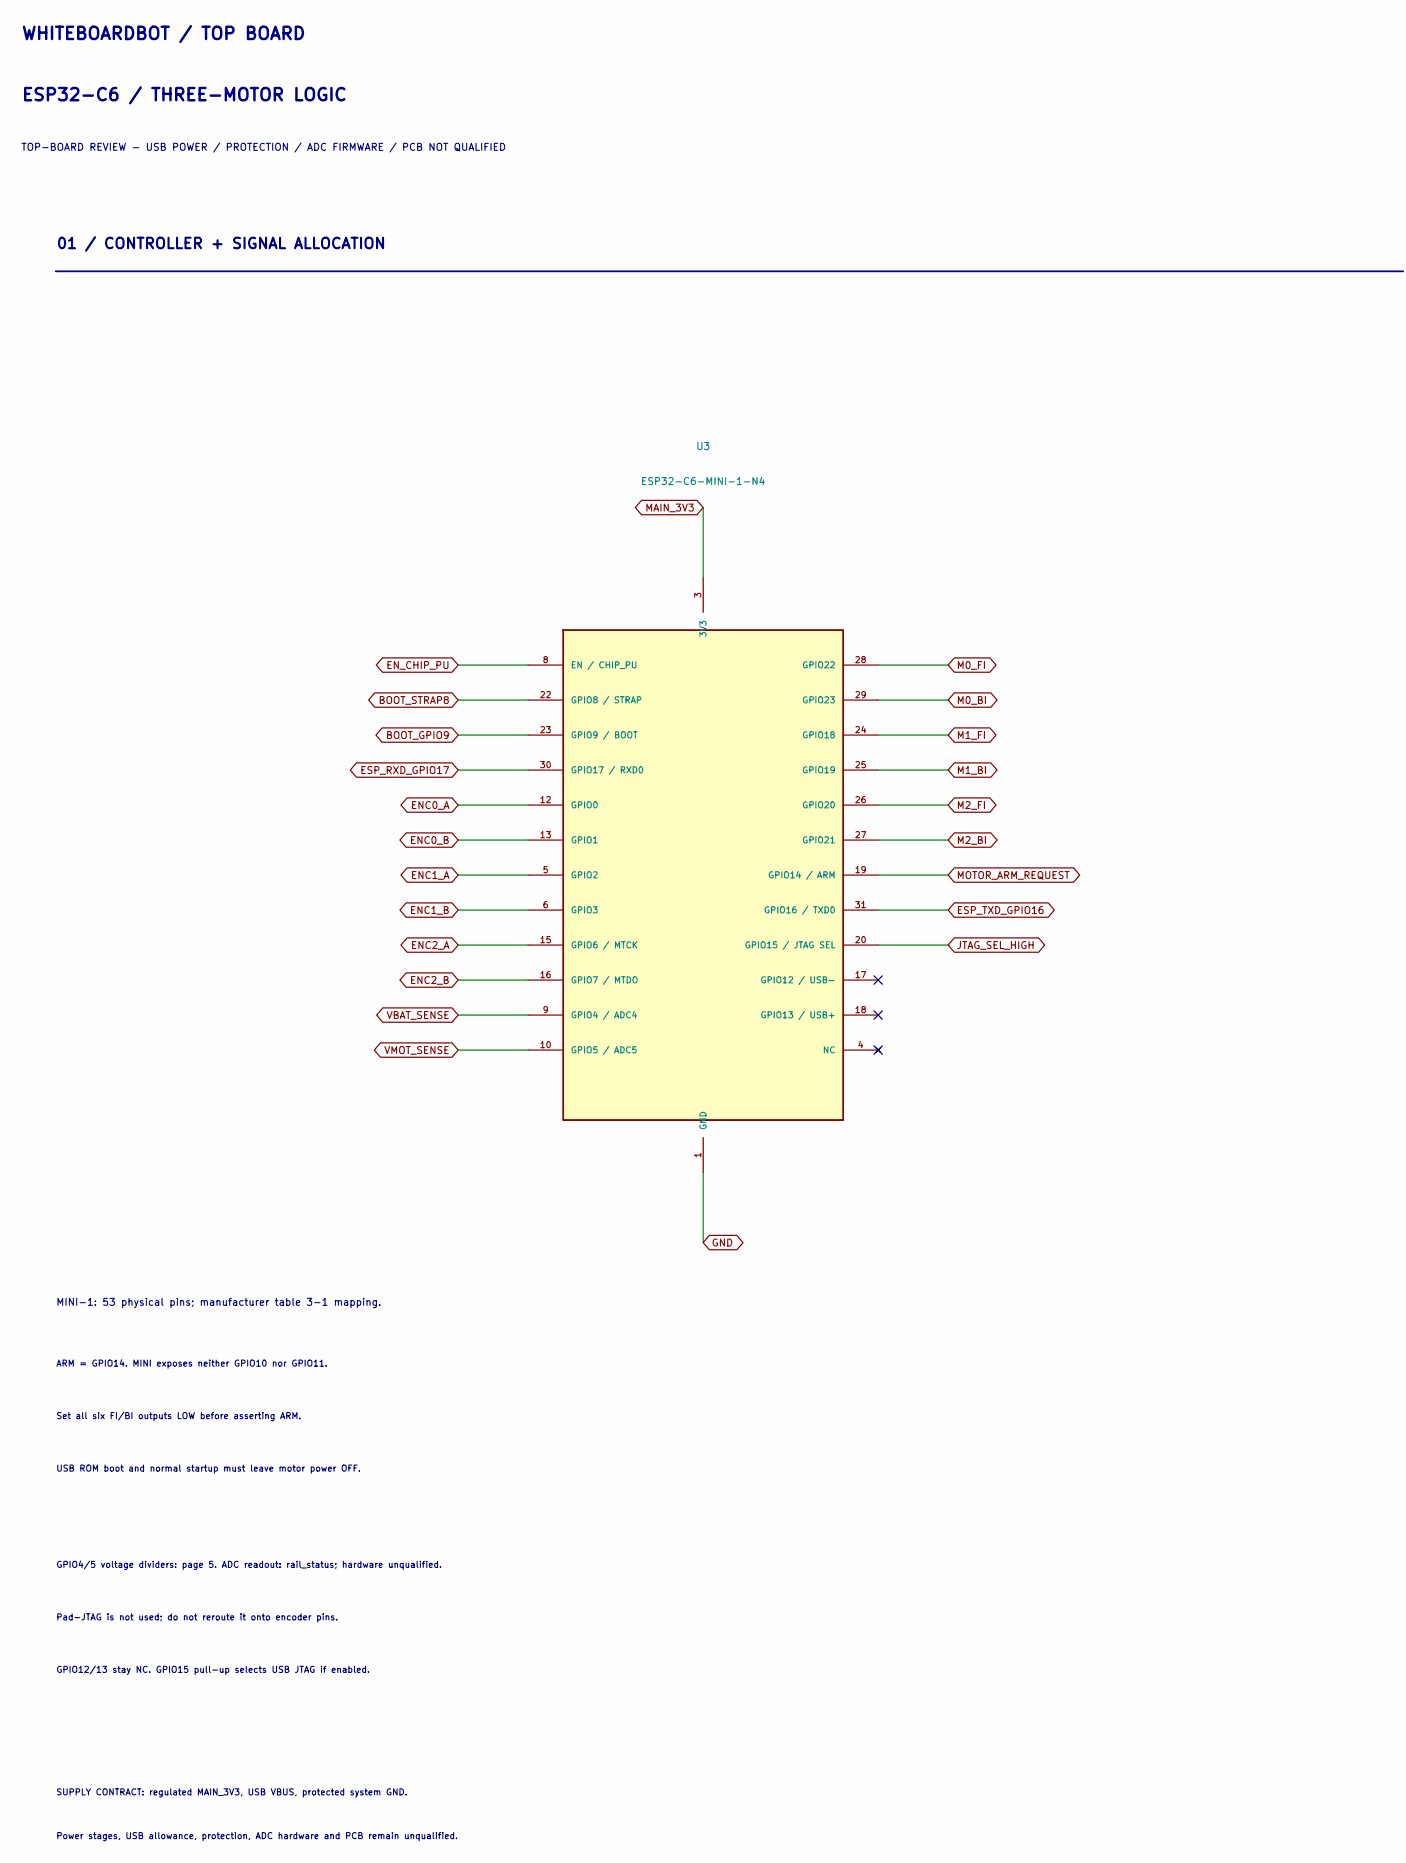
[picture p28: schematic controller.kicad_sch, ESP32-C6 / THREE-MOTOR LOGIC, part in row 1, column 1]

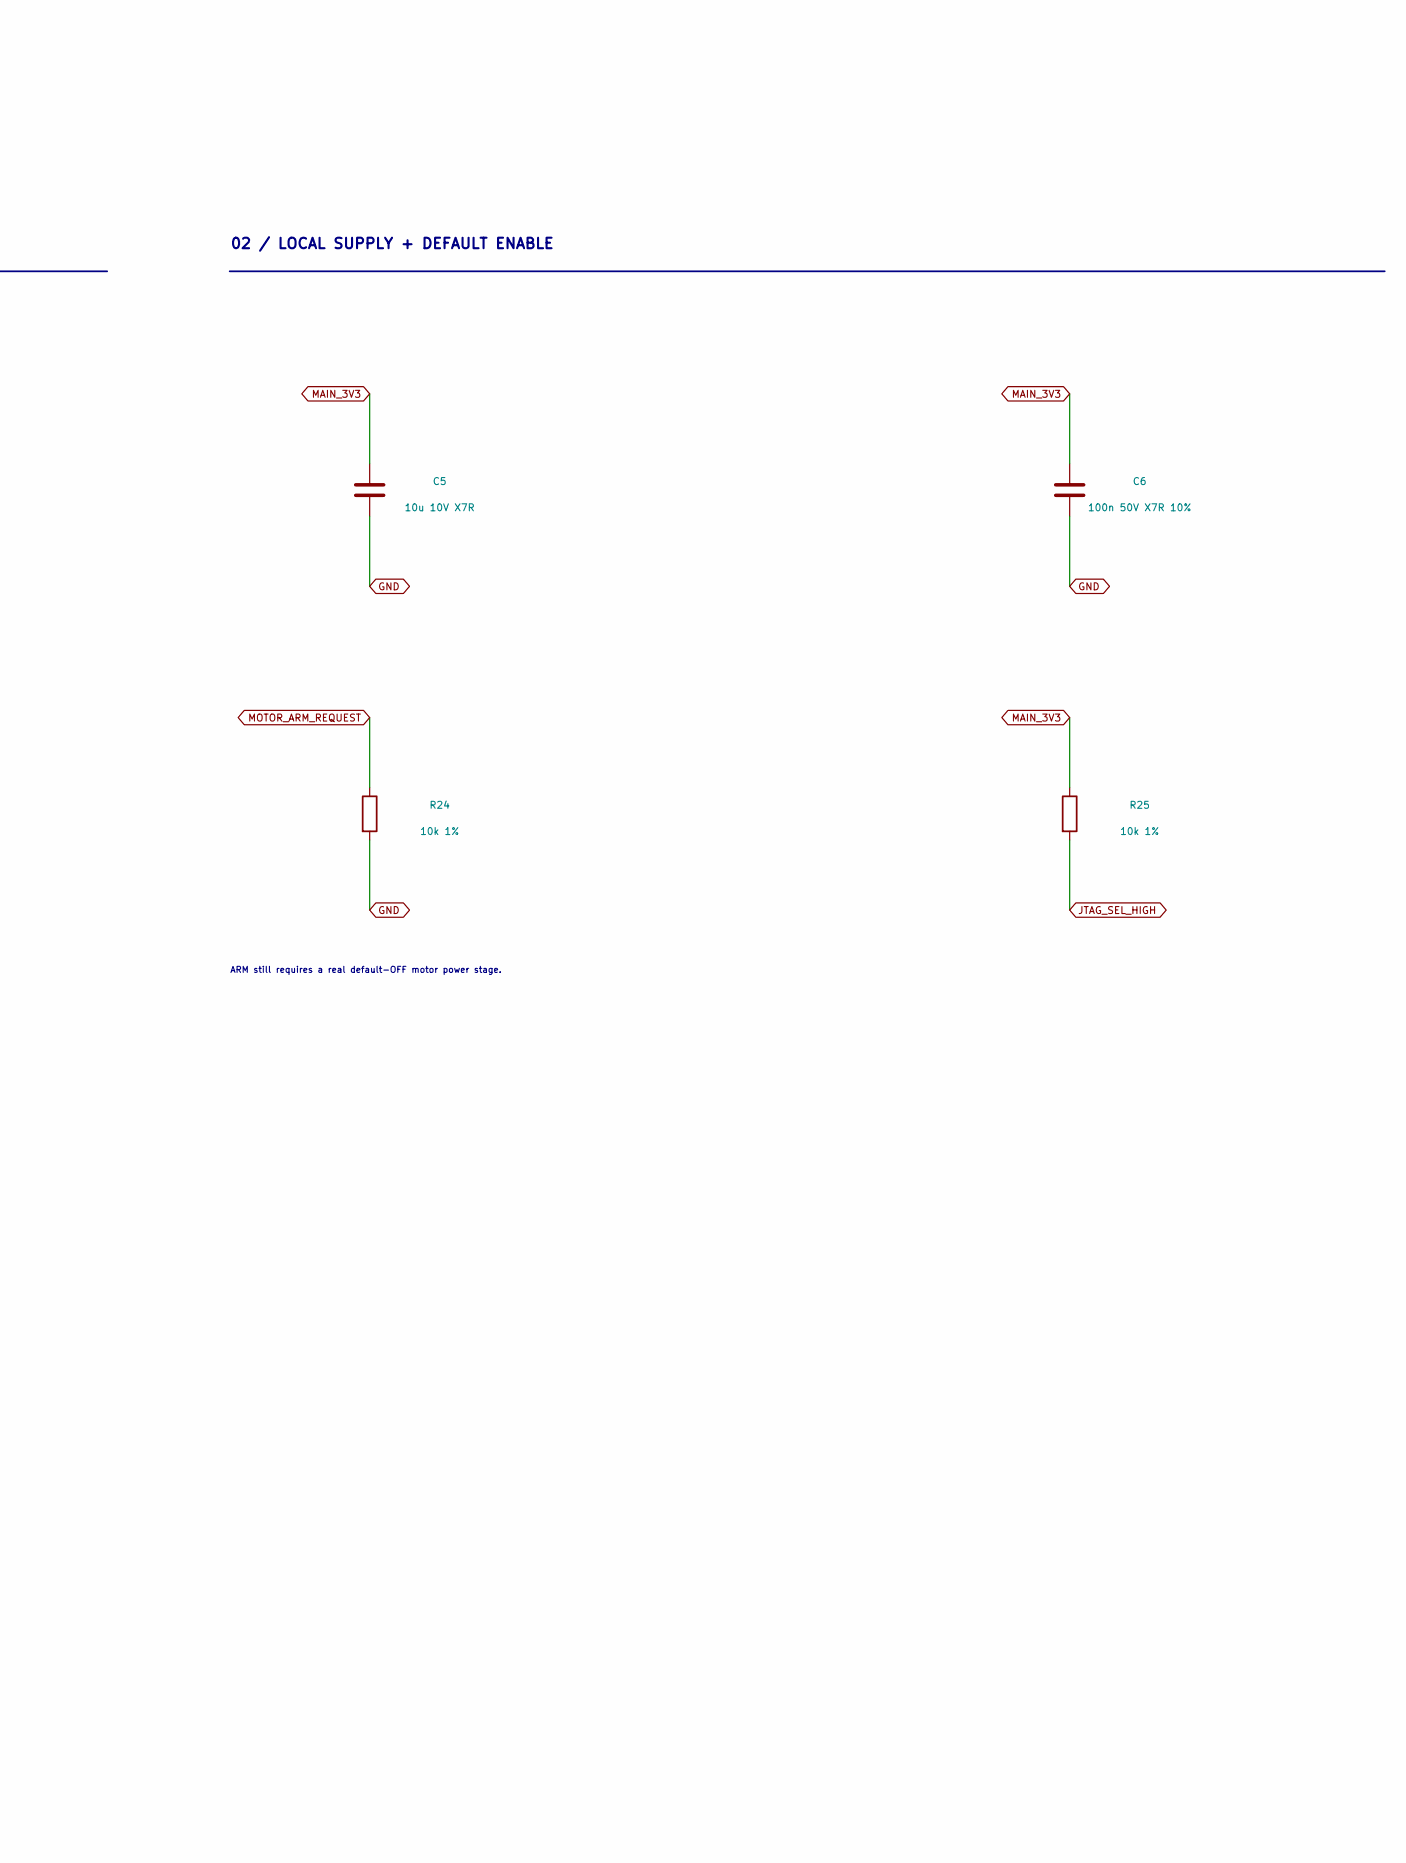
[picture p29: schematic controller.kicad_sch, ESP32-C6 / THREE-MOTOR LOGIC, part in row 1, column 2]

Parts:
C5: 10u 10V X7R; C_0805_2012Metric
C6: 100n 50V X7R 10%; C_0603_1608Metric; mpn CC0603KRX7R9BB104; LCSC C14663
R24, R25: 10k 1%; R_0603_1608Metric; mpn 0603WAF1002T5E; LCSC C25804
U3: ESP32-C6-MINI-1-N4; ESP32-C6-MINI-1; LCSC C5736265

Connections:
BOOT_GPIO9: U3.23 (GPIO9 / BOOT); also elsewhere on the board
BOOT_STRAP8: U3.22 (GPIO8 / STRAP); also elsewhere on the board
ENC0_A: U3.12 (GPIO0); also elsewhere on the board
ENC0_B: U3.13 (GPIO1); also elsewhere on the board
ENC1_A: U3.5 (GPIO2); also elsewhere on the board
ENC1_B: U3.6 (GPIO3); also elsewhere on the board
ENC2_A: U3.15 (GPIO6 / MTCK); also elsewhere on the board
ENC2_B: U3.16 (GPIO7 / MTDO); also elsewhere on the board
EN_CHIP_PU: U3.8 (EN / CHIP_PU); also elsewhere on the board
ESP_RXD_GPIO17: U3.30 (GPIO17 / RXD0); also elsewhere on the board
ESP_TXD_GPIO16: U3.31 (GPIO16 / TXD0); also elsewhere on the board
GND: C5.2, C6.2, R24.2, U3.1 (GND), U3.2 (GND), U3.11 (GND), U3.14 (GND), U3.36 (GND), U3.37 (GND), U3.38 (GND), U3.39 (GND), U3.40 (GND), U3.41 (GND), U3.42 (GND), U3.43 (GND), U3.44 (GND), U3.45 (GND), U3.46 (GND), U3.47 (GND), U3.48 (GND), U3.49 (GND), U3.50 (GND), U3.51 (GND), U3.52 (GND), U3.53 (GND); also elsewhere on the board
JTAG_SEL_HIGH: R25.2, U3.20 (GPIO15 / JTAG SEL)
M0_BI: U3.29 (GPIO23); also elsewhere on the board
M0_FI: U3.28 (GPIO22); also elsewhere on the board
M1_BI: U3.25 (GPIO19); also elsewhere on the board
M1_FI: U3.24 (GPIO18); also elsewhere on the board
M2_BI: U3.27 (GPIO21); also elsewhere on the board
M2_FI: U3.26 (GPIO20); also elsewhere on the board
MAIN_3V3: C5.1, C6.1, R25.1, U3.3 (3V3); also elsewhere on the board
MOTOR_ARM_REQUEST: R24.1, U3.19 (GPIO14 / ARM); also elsewhere on the board
VBAT_SENSE: U3.9 (GPIO4 / ADC4); also elsewhere on the board
VMOT_SENSE: U3.10 (GPIO5 / ADC5); also elsewhere on the board

Notes on the sheet:
WHITEBOARDBOT / TOP BOARD
ESP32-C6 / THREE-MOTOR LOGIC
TOP-BOARD REVIEW - USB POWER / PROTECTION / ADC FIRMWARE / PCB NOT QUALIFIED
01 / CONTROLLER + SIGNAL ALLOCATION
MINI-1: 53 physical pins; manufacturer table 3-1 mapping.
ARM = GPIO14. MINI exposes neither GPIO10 nor GPIO11.
Set all six FI/BI outputs LOW before asserting ARM.
USB ROM boot and normal startup must leave motor power OFF.
GPIO4/5 voltage dividers: page 5. ADC readout: rail_status; hardware unqualified.
Pad-JTAG is not used; do not reroute it onto encoder pins.
GPIO12/13 stay NC. GPIO15 pull-up selects USB JTAG if enabled.
02 / LOCAL SUPPLY + DEFAULT ENABLE
ARM still requires a real default-OFF motor power stage.
SUPPLY CONTRACT: regulated MAIN_3V3, USB VBUS, protected system GND.
Power stages, USB allowance, protection, ADC hardware and PCB remain unqualified.

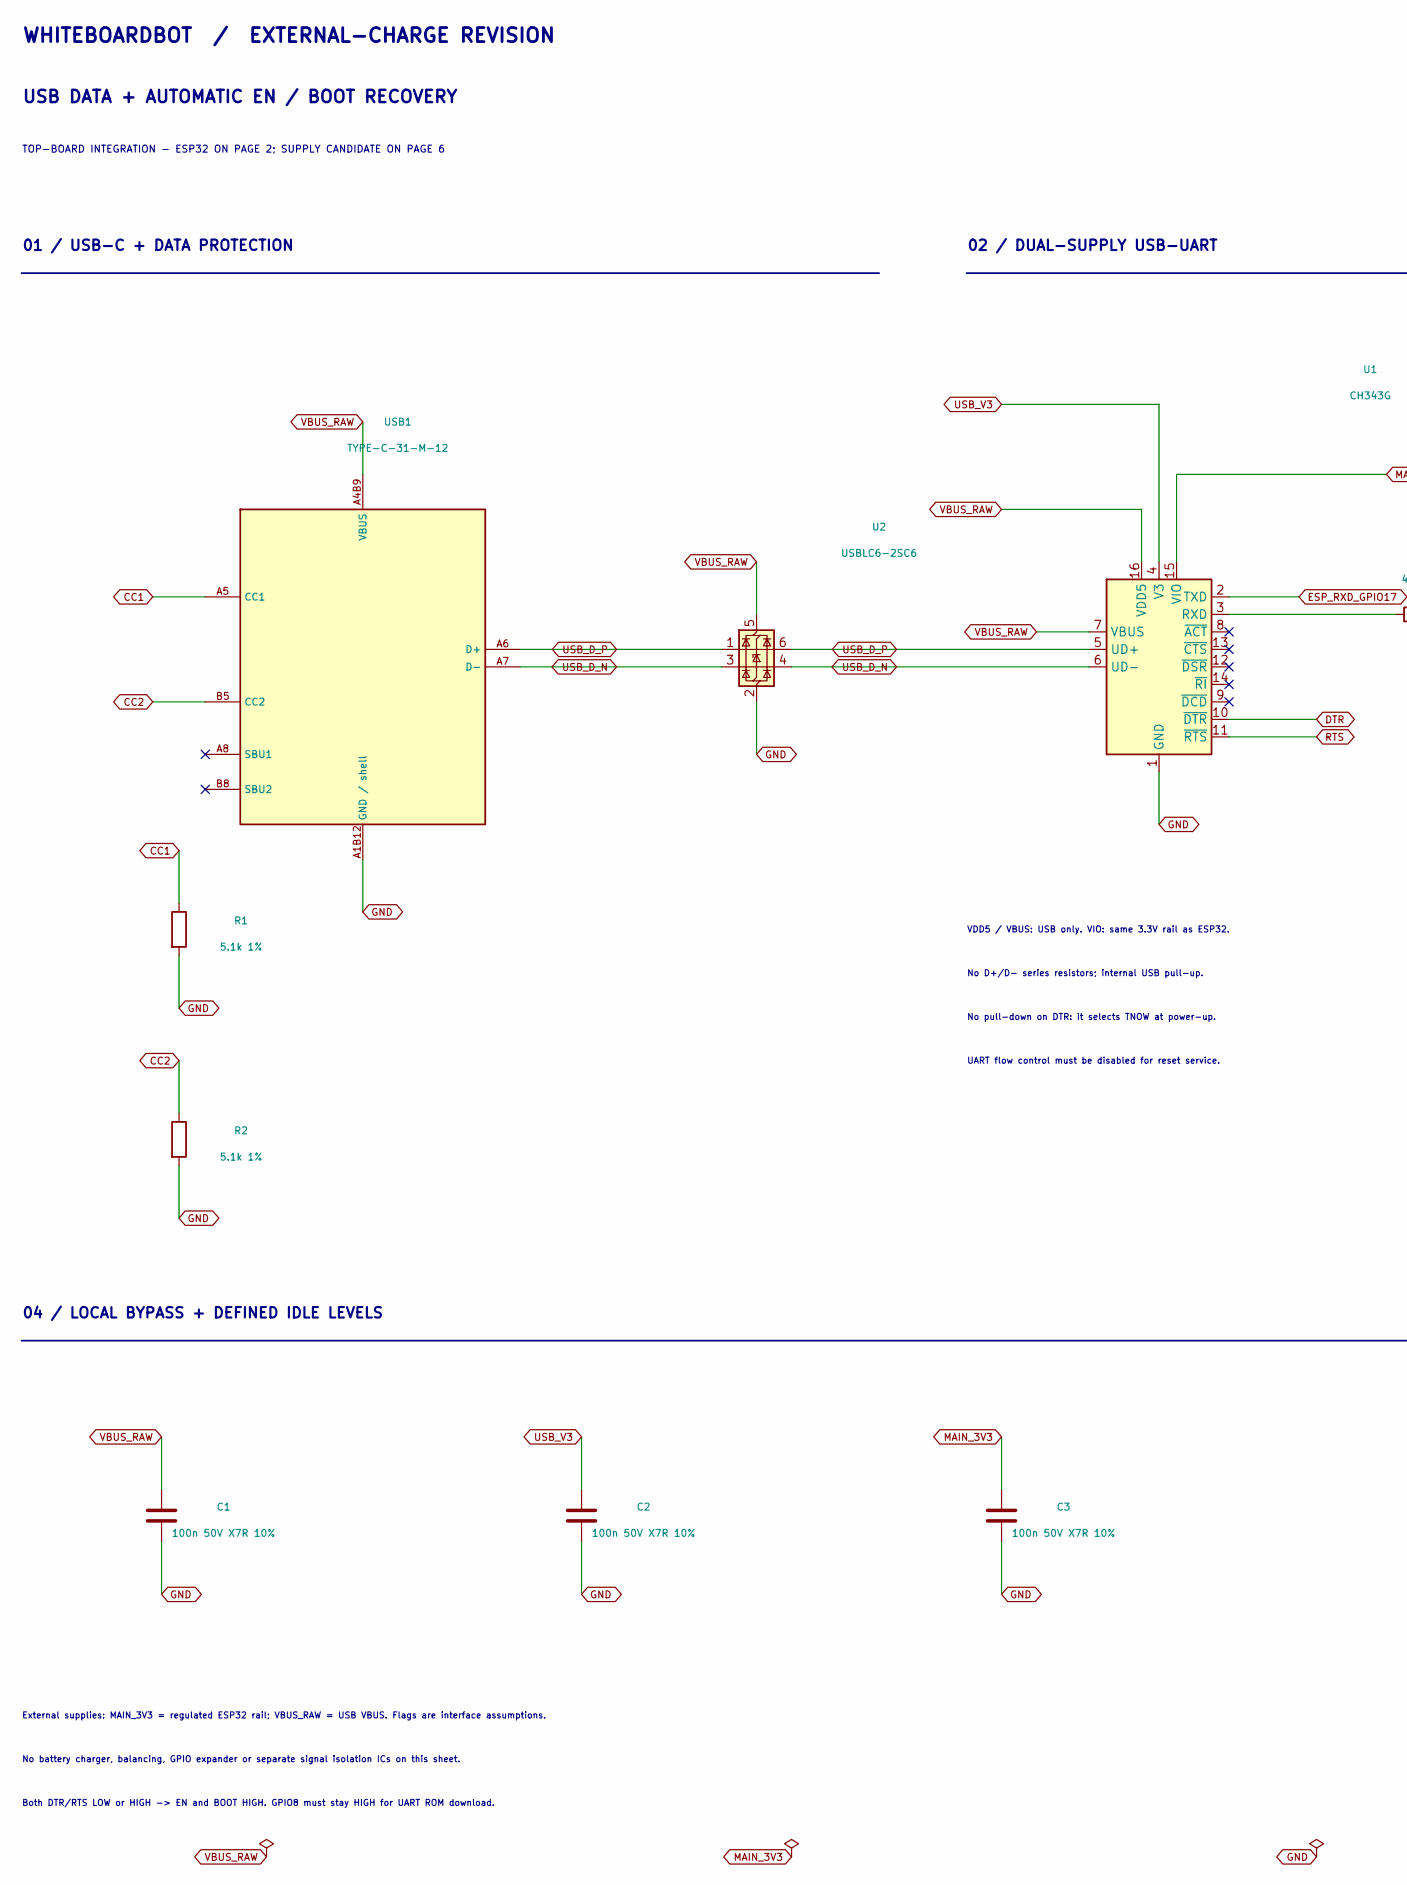
[picture p30: schematic usb_recovery.kicad_sch, External-charge top board: USB recovery circuit, part in row 1, column 1]

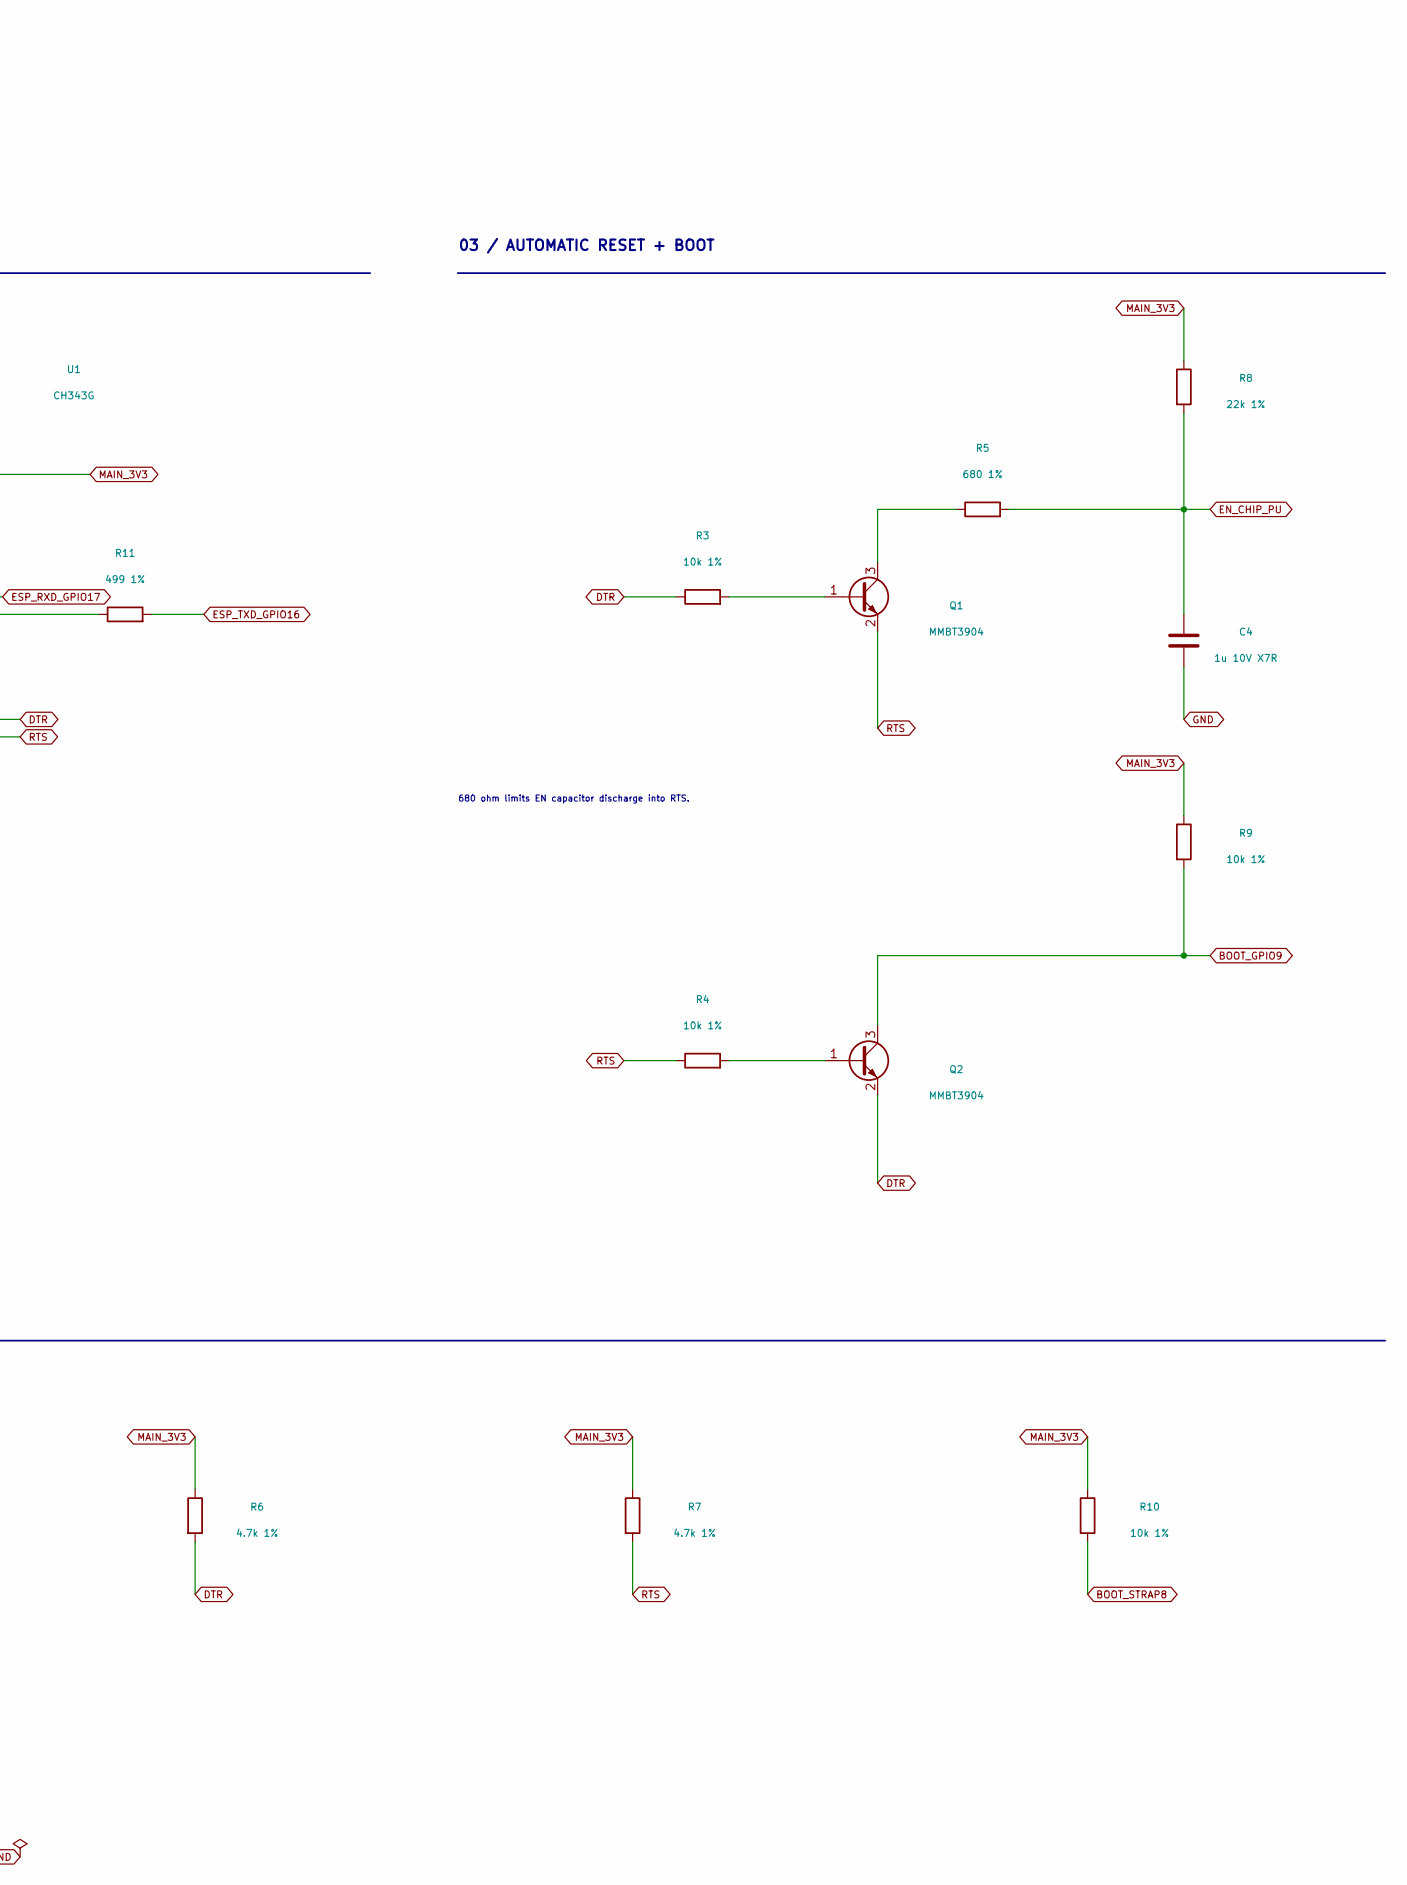
[picture p31: schematic usb_recovery.kicad_sch, External-charge top board: USB recovery circuit, part in row 1, column 2]

Parts:
C1, C2, C3: 100n 50V X7R 10%; C_0603_1608Metric; mpn CC0603KRX7R9BB104; LCSC C14663
C4: 1u 10V X7R; C_0603_1608Metric
Q1, Q2: MMBT3904; SOT-23
R1, R2: 5.1k 1%; R_0603_1608Metric; mpn 0603WAF5101T5E; LCSC C23186
R3, R4, R9, R10: 10k 1%; R_0603_1608Metric; mpn 0603WAF1002T5E; LCSC C25804
R5: 680 1%; R_0603_1608Metric; mpn 0603WAF6800T5E; LCSC C23228
R6, R7: 4.7k 1%; R_0603_1608Metric; mpn 0603WAF4701T5E; LCSC C23162
R8: 22k 1%; R_0603_1608Metric; mpn 0603WAF2202T5E; LCSC C31850
R11: 499 1%; R_0603_1608Metric
U1: CH343G; SOIC-16_3.9x9.9mm_P1.27mm; LCSC C2844153
U2: USBLC6-2SC6; SOT-23-6; mpn USBLC6-2SC6; LCSC C7519
USB1: TYPE-C-31-M-12; USB1_USB-C_SMD-TYPE-C-31-M-12_1; LCSC C165948

Connections:
BOOT_GPIO9: Q2.3 (C), R9.2; also elsewhere on the board
BOOT_STRAP8: R10.2; also elsewhere on the board
CC1: R1.1, USB1.A5 (CC1)
CC2: R2.1, USB1.B5 (CC2)
DTR: Q2.2 (E), R3.1, R6.2, U1.10 (~DTR)
EN_CHIP_PU: C4.1, R5.2, R8.2; also elsewhere on the board
ESP_RXD_GPIO17: U1.2 (TXD); also elsewhere on the board
ESP_TXD_GPIO16: R11.2; also elsewhere on the board
GND: C1.2, C2.2, C3.2, C4.2, R1.2, R2.2, U1.1 (GND), U2.2 (GND), USB1.1 (GND / shell), USB1.2 (GND / shell), USB1.3 (GND / shell), USB1.4 (GND / shell), USB1.A1B12 (GND / shell), USB1.B1A12 (GND / shell); also elsewhere on the board
MAIN_3V3: C3.1, R6.1, R7.1, R8.1, R9.1, R10.1, U1.15 (VIO); also elsewhere on the board
unnamed: Q1.1 (B), R3.2
unnamed: Q1.3 (C), R5.1
unnamed: Q2.1 (B), R4.2
unnamed: R11.1, U1.3 (RXD)
RTS: Q1.2 (E), R4.1, R7.2, U1.11 (~RTS)
USB_D_N: U1.6 (UD-), U2.3 (I/O2), U2.4 (I/O2), USB1.A7 (D-), USB1.B7 (D-)
USB_D_P: U1.5 (UD+), U2.1 (I/O1), U2.6 (I/O1), USB1.A6 (D+), USB1.B6 (D+)
USB_V3: C2.1, U1.4 (V3)
VBUS_RAW: C1.1, U1.7 (VBUS), U1.16 (VDD5), U2.5 (VBUS), USB1.A4B9 (VBUS), USB1.B4A9 (VBUS); also elsewhere on the board

Notes on the sheet:
WHITEBOARDBOT / EXTERNAL-CHARGE REVISION
USB DATA + AUTOMATIC EN / BOOT RECOVERY
TOP-BOARD INTEGRATION - ESP32 ON PAGE 2; SUPPLY CANDIDATE ON PAGE 6
01 / USB-C + DATA PROTECTION
02 / DUAL-SUPPLY USB-UART
03 / AUTOMATIC RESET + BOOT
VDD5 / VBUS: USB only. VIO: same 3.3V rail as ESP32.
No D+/D- series resistors; internal USB pull-up.
No pull-down on DTR: it selects TNOW at power-up.
UART flow control must be disabled for reset service.
680 ohm limits EN capacitor discharge into RTS.
04 / LOCAL BYPASS + DEFINED IDLE LEVELS
External supplies: MAIN_3V3 = regulated ESP32 rail; VBUS_RAW = USB VBUS. Flags are interface assumptions.
No battery charger, balancing, GPIO expander or separate signal isolation ICs on this sheet.
Both DTR/RTS LOW or HIGH -> EN and BOOT HIGH. GPIO8 must stay HIGH for UART ROM download.

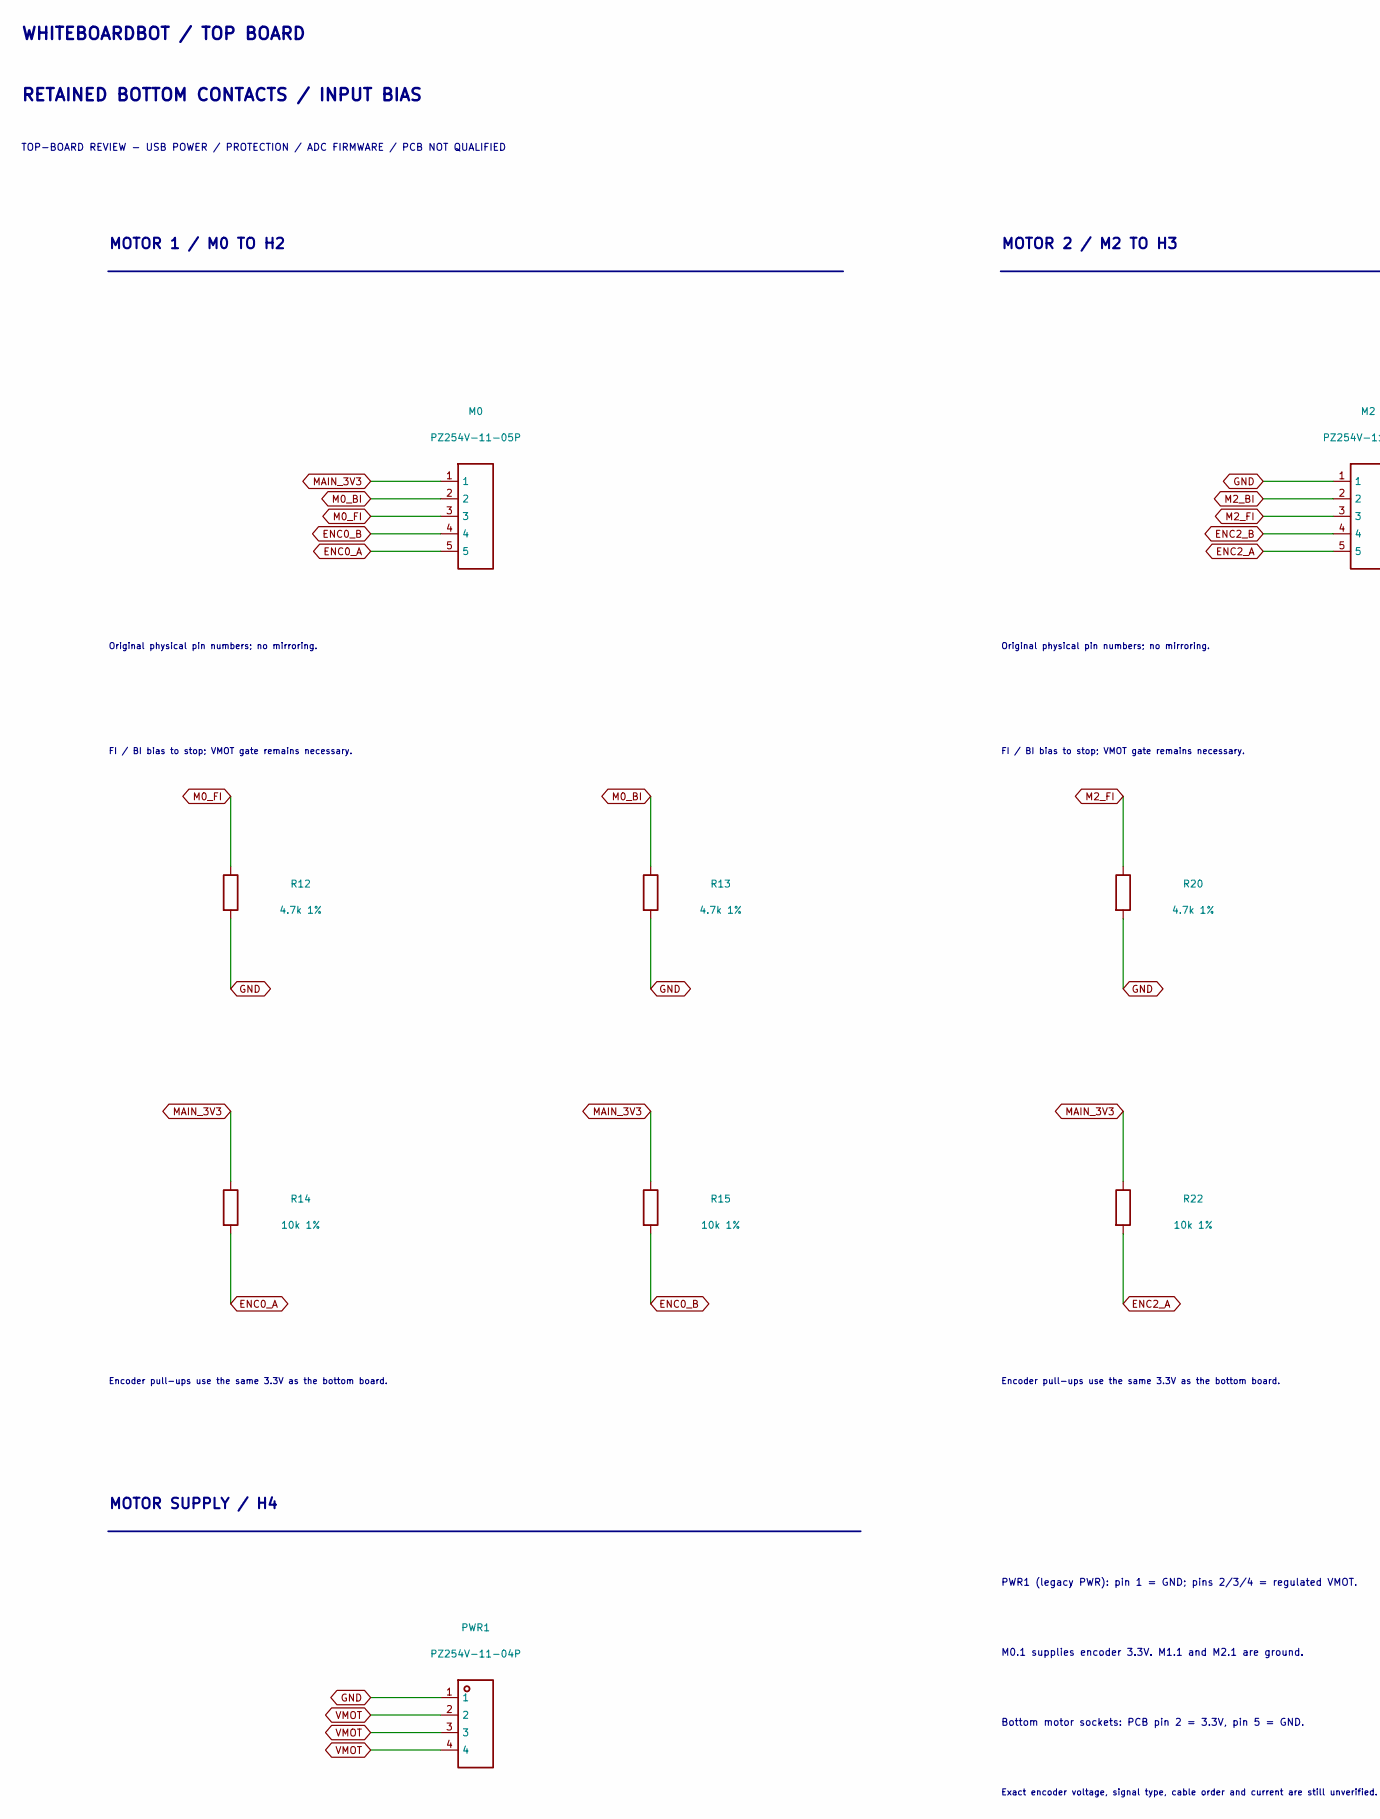
[picture p32: schematic bottom_interfaces.kicad_sch, RETAINED BOTTOM CONTACTS / INPUT BIAS, part in row 1, column 1]

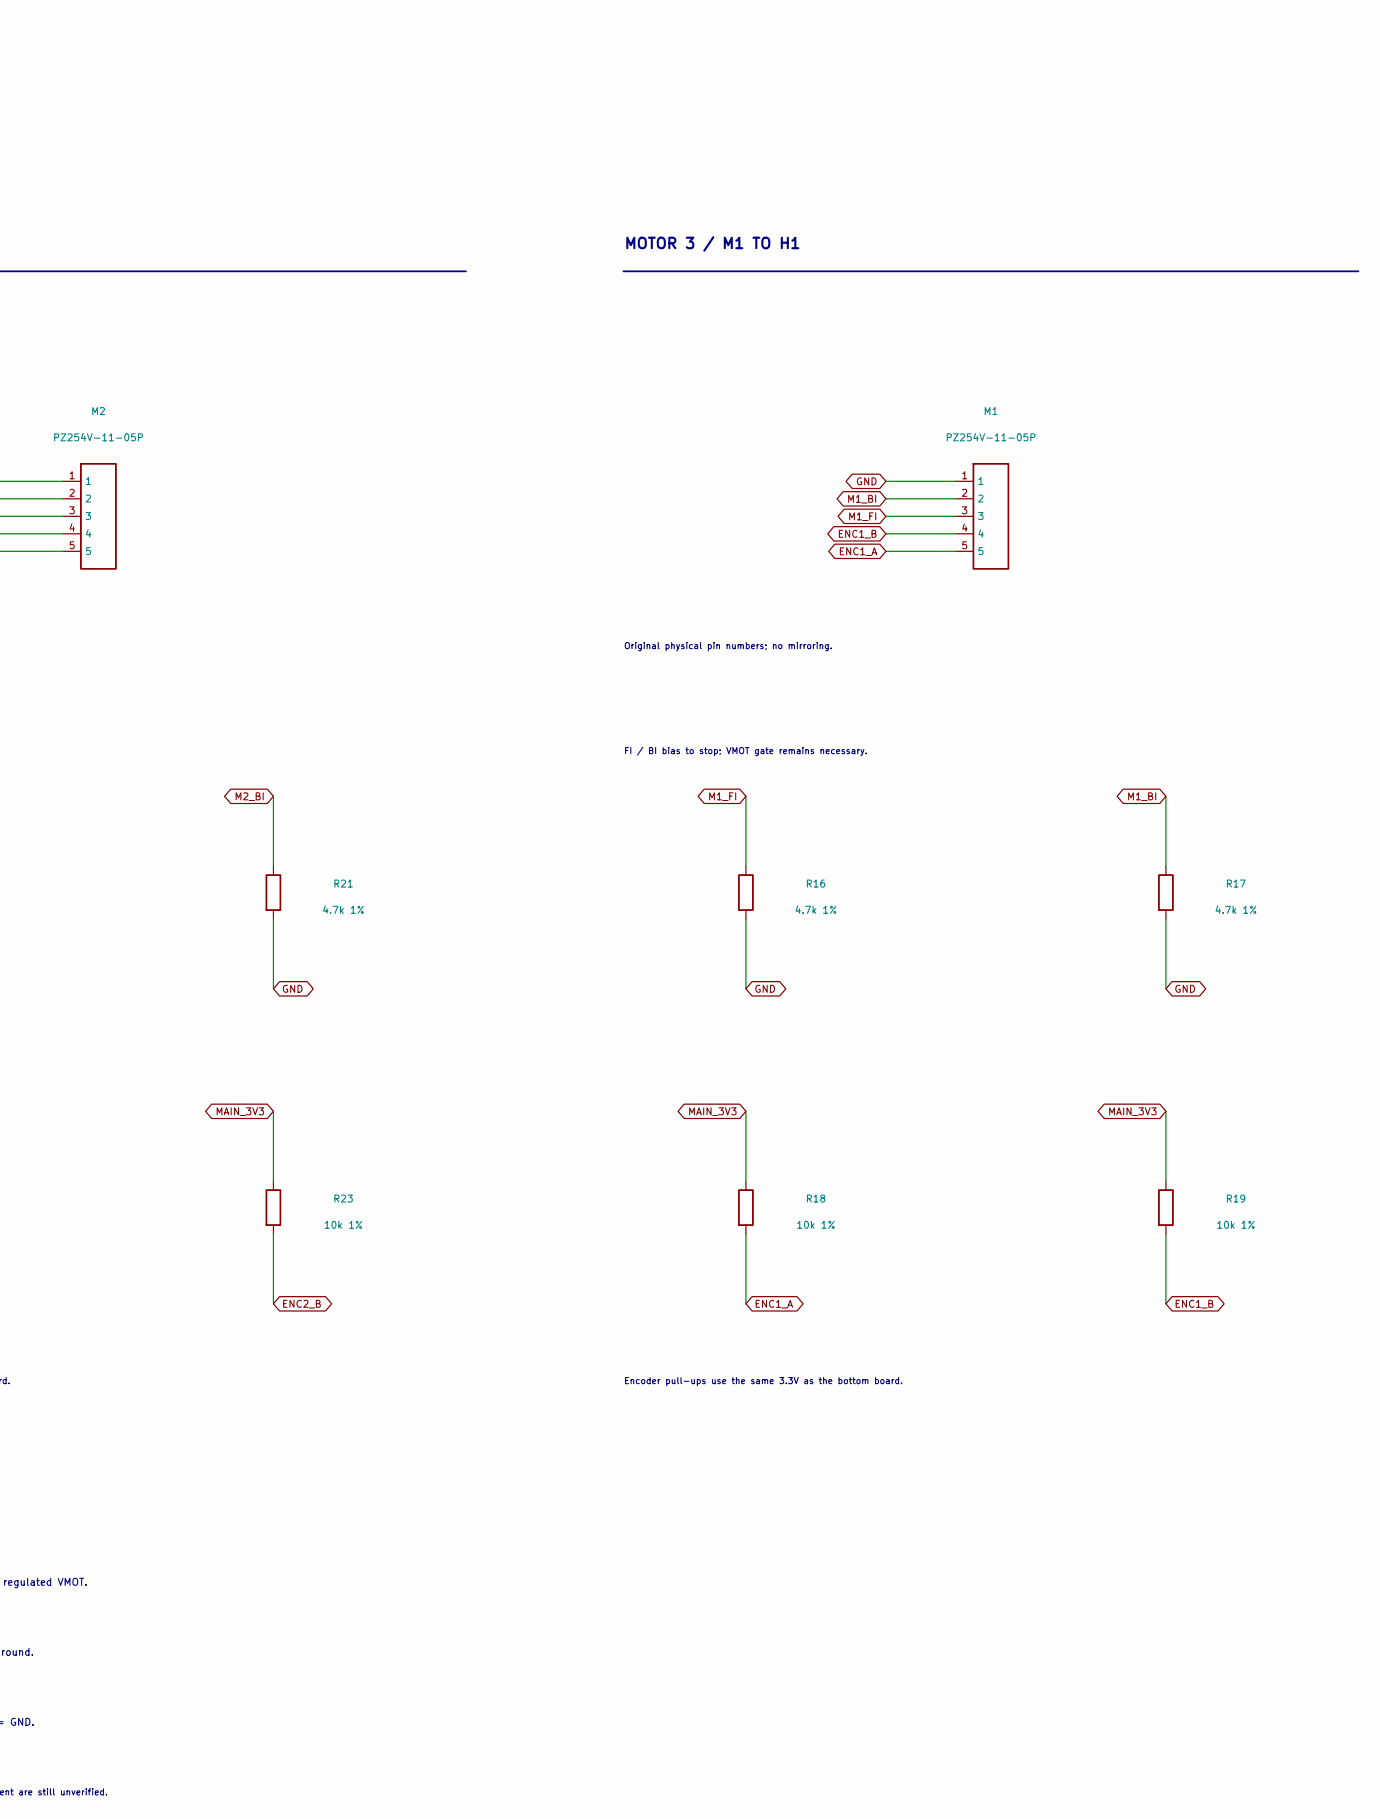
[picture p33: schematic bottom_interfaces.kicad_sch, RETAINED BOTTOM CONTACTS / INPUT BIAS, part in row 1, column 2]

Parts:
M0: PZ254V-11-05P; M0_HDR-TH_5P-P2.54-V-M; LCSC C492404
M1: PZ254V-11-05P; M1_HDR-TH_5P-P2.54-V-M; LCSC C492404
M2: PZ254V-11-05P; M2_HDR-TH_5P-P2.54-V-M; LCSC C492404
PWR1: PZ254V-11-04P; PWR_HDR-TH_4P-P2.54-V-M; LCSC C2691448
R12, R13, R16, R17, R20, R21: 4.7k 1%; R_0603_1608Metric; mpn 0603WAF4701T5E; LCSC C23162
R14, R15, R18, R19, R22, R23: 10k 1%; R_0603_1608Metric; mpn 0603WAF1002T5E; LCSC C25804

Connections:
ENC0_A: M0.5, R14.2; also elsewhere on the board
ENC0_B: M0.4, R15.2; also elsewhere on the board
ENC1_A: M1.5, R18.2; also elsewhere on the board
ENC1_B: M1.4, R19.2; also elsewhere on the board
ENC2_A: M2.5, R22.2; also elsewhere on the board
ENC2_B: M2.4, R23.2; also elsewhere on the board
GND: M1.1, M2.1, PWR1.1, R12.2, R13.2, R16.2, R17.2, R20.2, R21.2; also elsewhere on the board
M0_BI: M0.2, R13.1; also elsewhere on the board
M0_FI: M0.3, R12.1; also elsewhere on the board
M1_BI: M1.2, R17.1; also elsewhere on the board
M1_FI: M1.3, R16.1; also elsewhere on the board
M2_BI: M2.2, R21.1; also elsewhere on the board
M2_FI: M2.3, R20.1; also elsewhere on the board
MAIN_3V3: M0.1, R14.1, R15.1, R18.1, R19.1, R22.1, R23.1; also elsewhere on the board
VMOT: PWR1.2, PWR1.3, PWR1.4; also elsewhere on the board

Notes on the sheet:
WHITEBOARDBOT / TOP BOARD
RETAINED BOTTOM CONTACTS / INPUT BIAS
TOP-BOARD REVIEW - USB POWER / PROTECTION / ADC FIRMWARE / PCB NOT QUALIFIED
MOTOR 1 / M0 TO H2
Original physical pin numbers; no mirroring.
FI / BI bias to stop; VMOT gate remains necessary.
Encoder pull-ups use the same 3.3V as the bottom board.
MOTOR 2 / M2 TO H3
MOTOR 3 / M1 TO H1
MOTOR SUPPLY / H4
PWR1 (legacy PWR): pin 1 = GND; pins 2/3/4 = regulated VMOT.
M0.1 supplies encoder 3.3V. M1.1 and M2.1 are ground.
Bottom motor sockets: PCB pin 2 = 3.3V, pin 5 = GND.
Exact encoder voltage, signal type, cable order and current are still unverified.
