OAK-WJR/mooon-whiteboard-robot/hardware/top_board_v2/jlc_budget_6v/controller_core/logic/top_board_v2_logic.kicad_pcb

## KiCad design hardware/top_board_v2/jlc_budget_6v/controller_core/logic/top_board_v2_logic.kicad_pcb (continued)

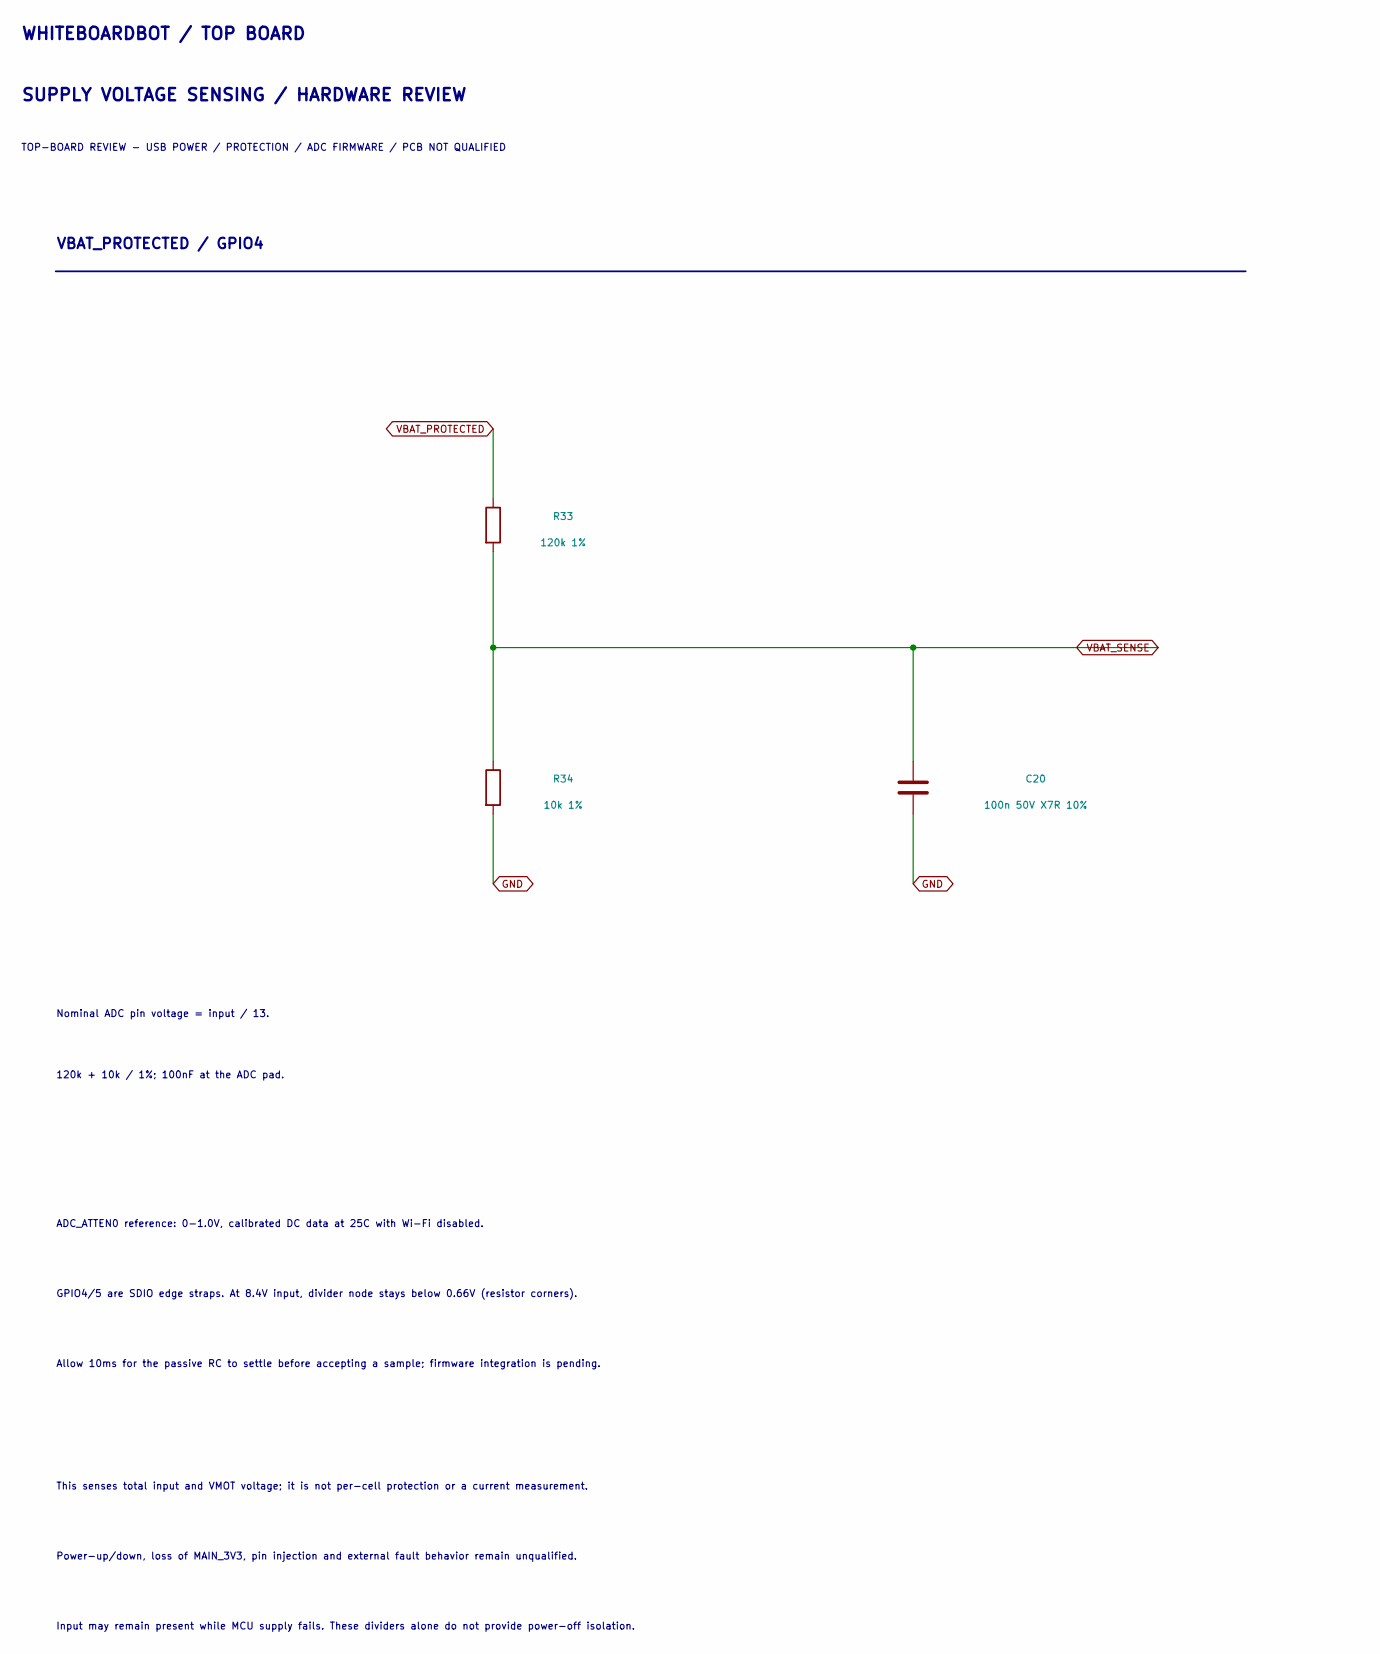
[picture p34: schematic voltage_sense.kicad_sch, SUPPLY VOLTAGE SENSING / HARDWARE REVIEW, part in row 1, column 1]

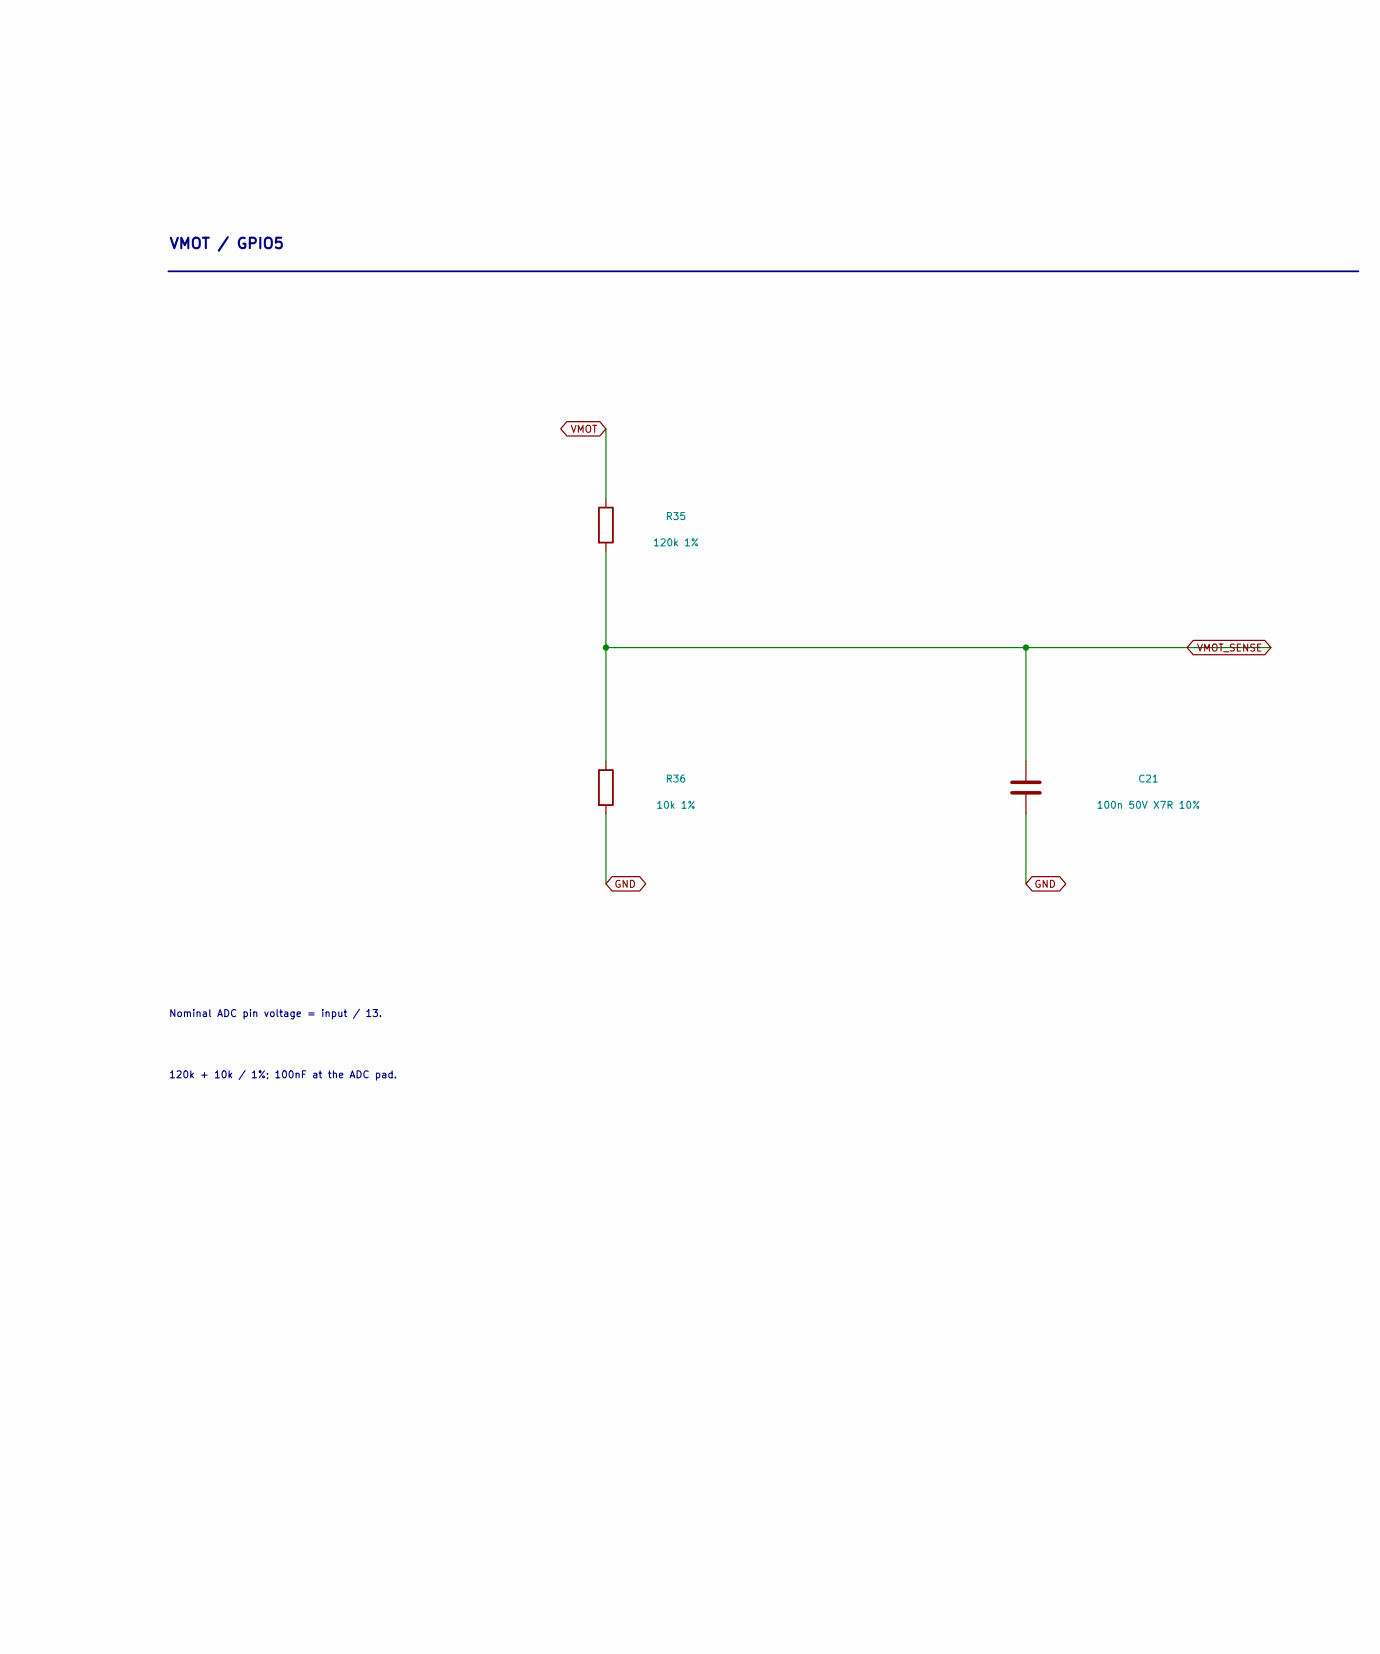
[picture p35: schematic voltage_sense.kicad_sch, SUPPLY VOLTAGE SENSING / HARDWARE REVIEW, part in row 1, column 2]

Parts:
C20, C21: 100n 50V X7R 10%; C_0603_1608Metric; mpn CC0603KRX7R9BB104; LCSC C14663
R33, R35: 120k 1%; R_0603_1608Metric; mpn 0603WAF1203T5E; LCSC C25808
R34, R36: 10k 1%; R_0603_1608Metric; mpn 0603WAF1002T5E; LCSC C25804

Connections:
GND: C20.2, C21.2, R34.2, R36.2; also elsewhere on the board
VBAT_PROTECTED: R33.1; also elsewhere on the board
VBAT_SENSE: C20.1, R33.2, R34.1; also elsewhere on the board
VMOT: R35.1; also elsewhere on the board
VMOT_SENSE: C21.1, R35.2, R36.1; also elsewhere on the board

Notes on the sheet:
WHITEBOARDBOT / TOP BOARD
SUPPLY VOLTAGE SENSING / HARDWARE REVIEW
TOP-BOARD REVIEW - USB POWER / PROTECTION / ADC FIRMWARE / PCB NOT QUALIFIED
VBAT_PROTECTED / GPIO4
Nominal ADC pin voltage = input / 13.
120k + 10k / 1%; 100nF at the ADC pad.
VMOT / GPIO5
ADC_ATTEN0 reference: 0-1.0V, calibrated DC data at 25C with Wi-Fi disabled.
GPIO4/5 are SDIO edge straps. At 8.4V input, divider node stays below 0.66V (resistor corners).
Allow 10ms for the passive RC to settle before accepting a sample; firmware integration is pending.
This senses total input and VMOT voltage; it is not per-cell protection or a current measurement.
Power-up/down, loss of MAIN_3V3, pin injection and external fault behavior remain unqualified.
Input may remain present while MCU supply fails. These dividers alone do not provide power-off isolation.

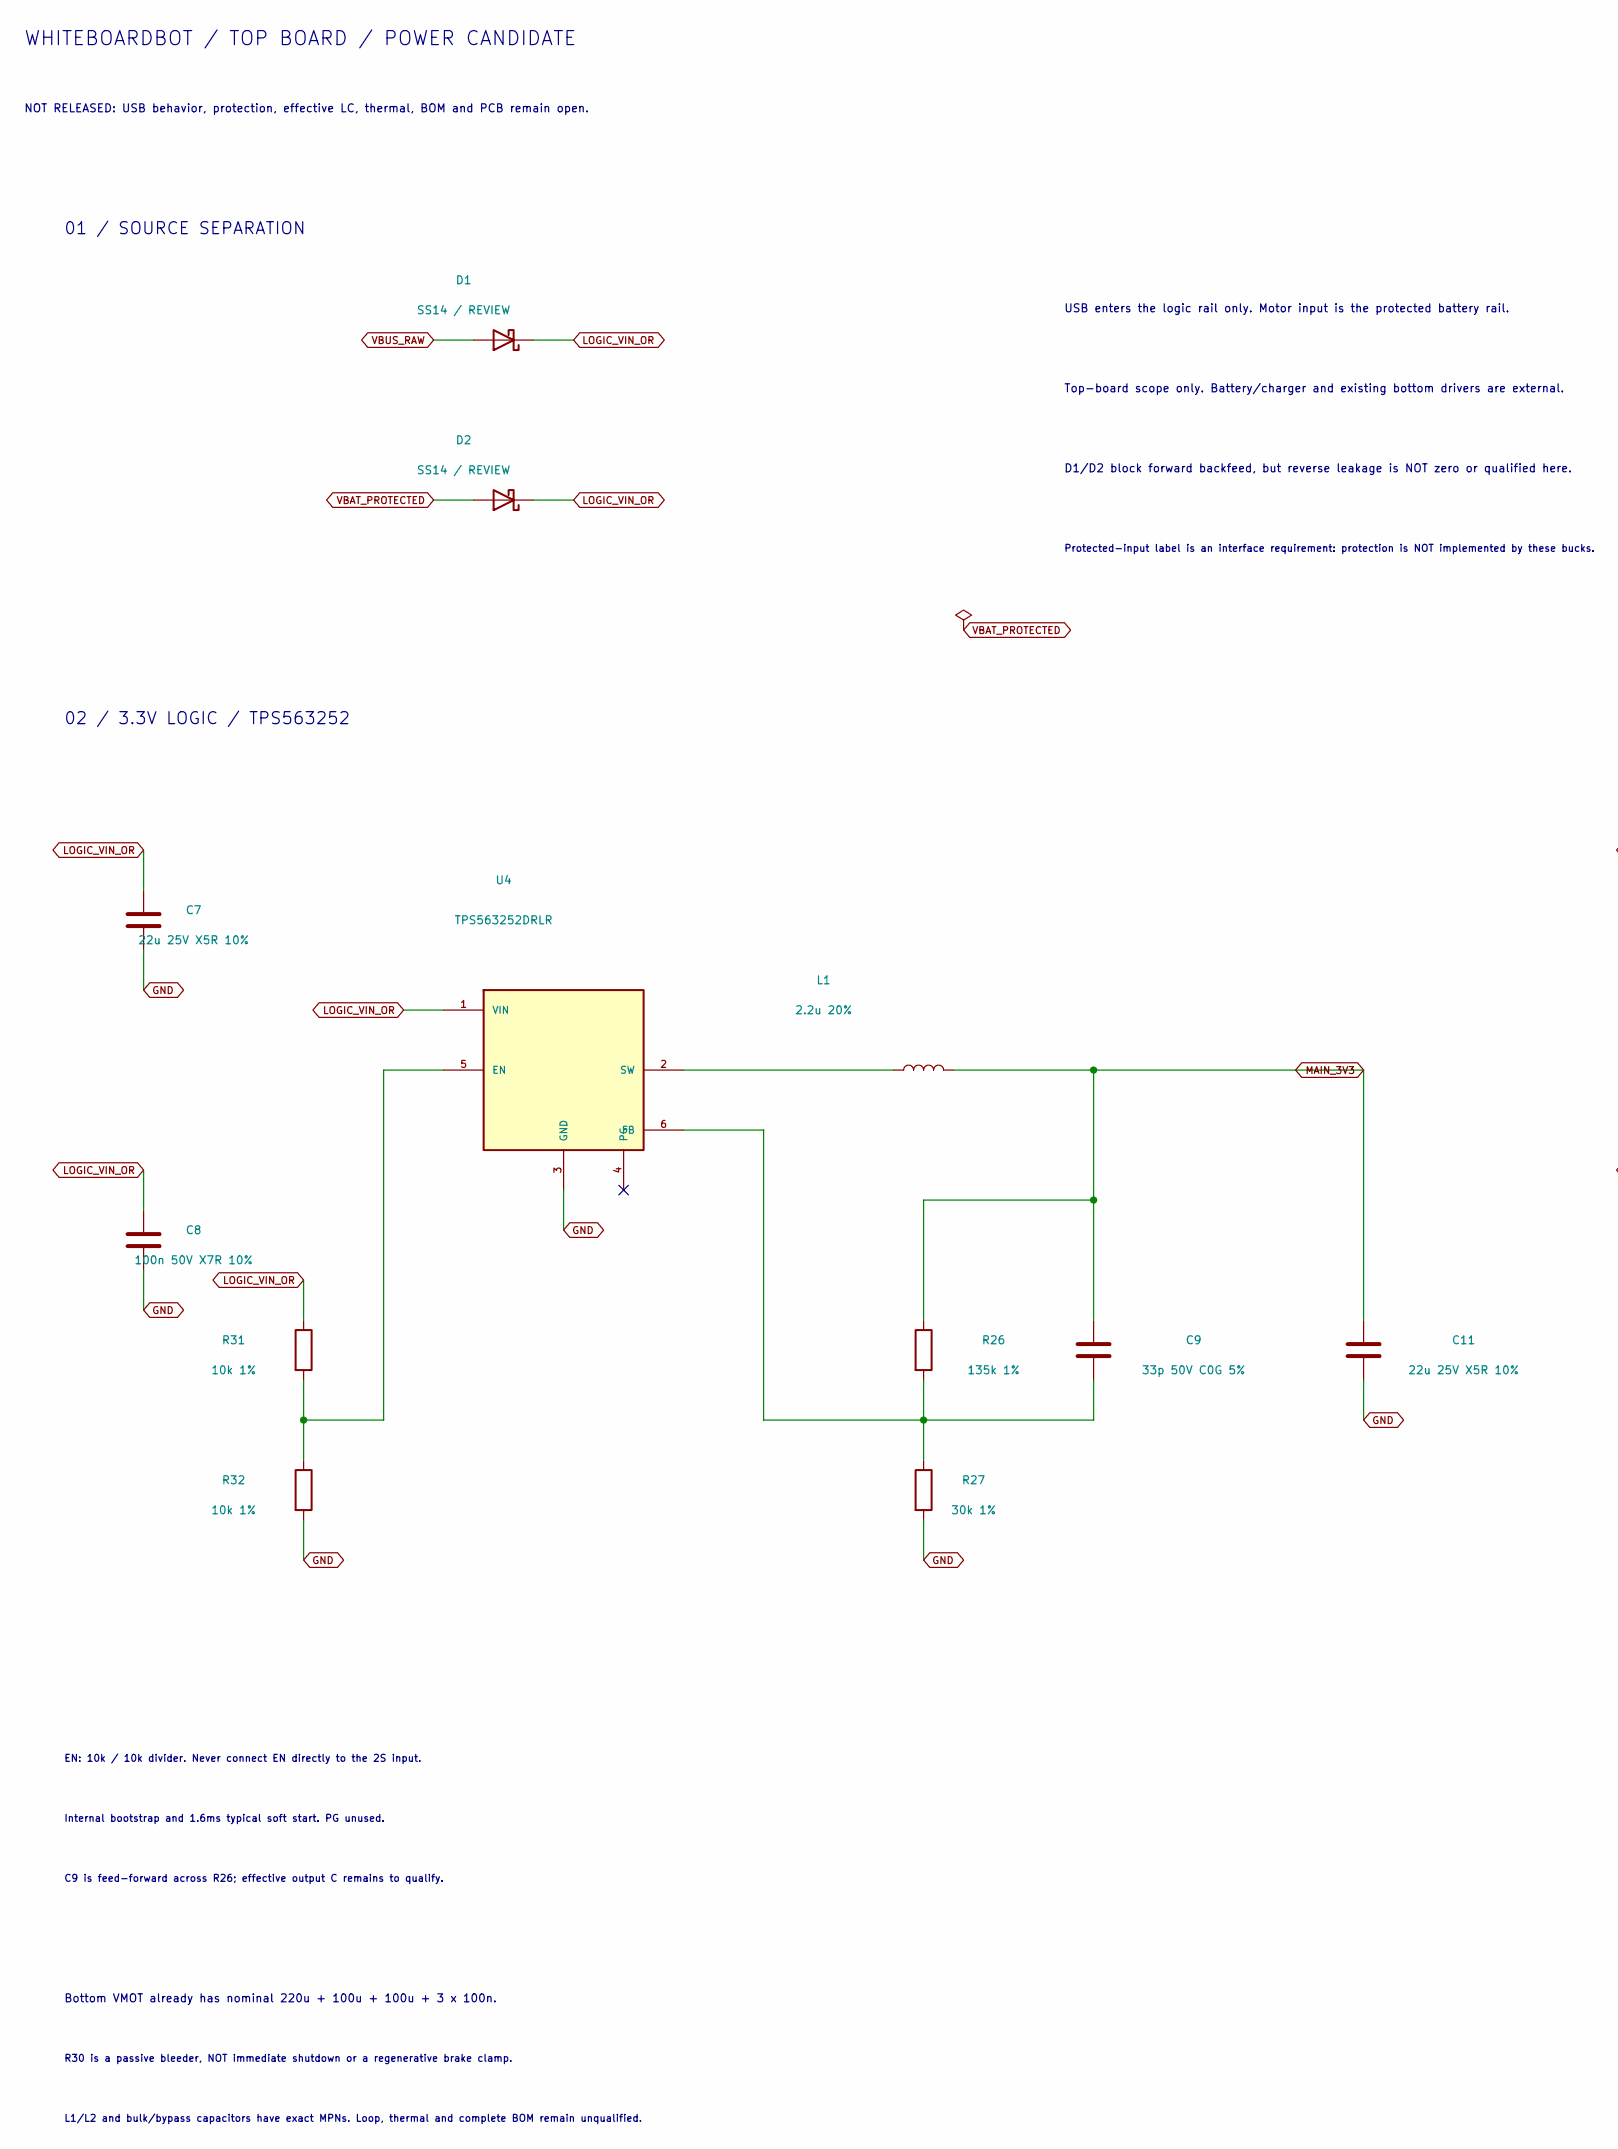
[picture p36: schematic power_stage.kicad_sch, Top-board power candidate / not released, part in row 1, column 1]

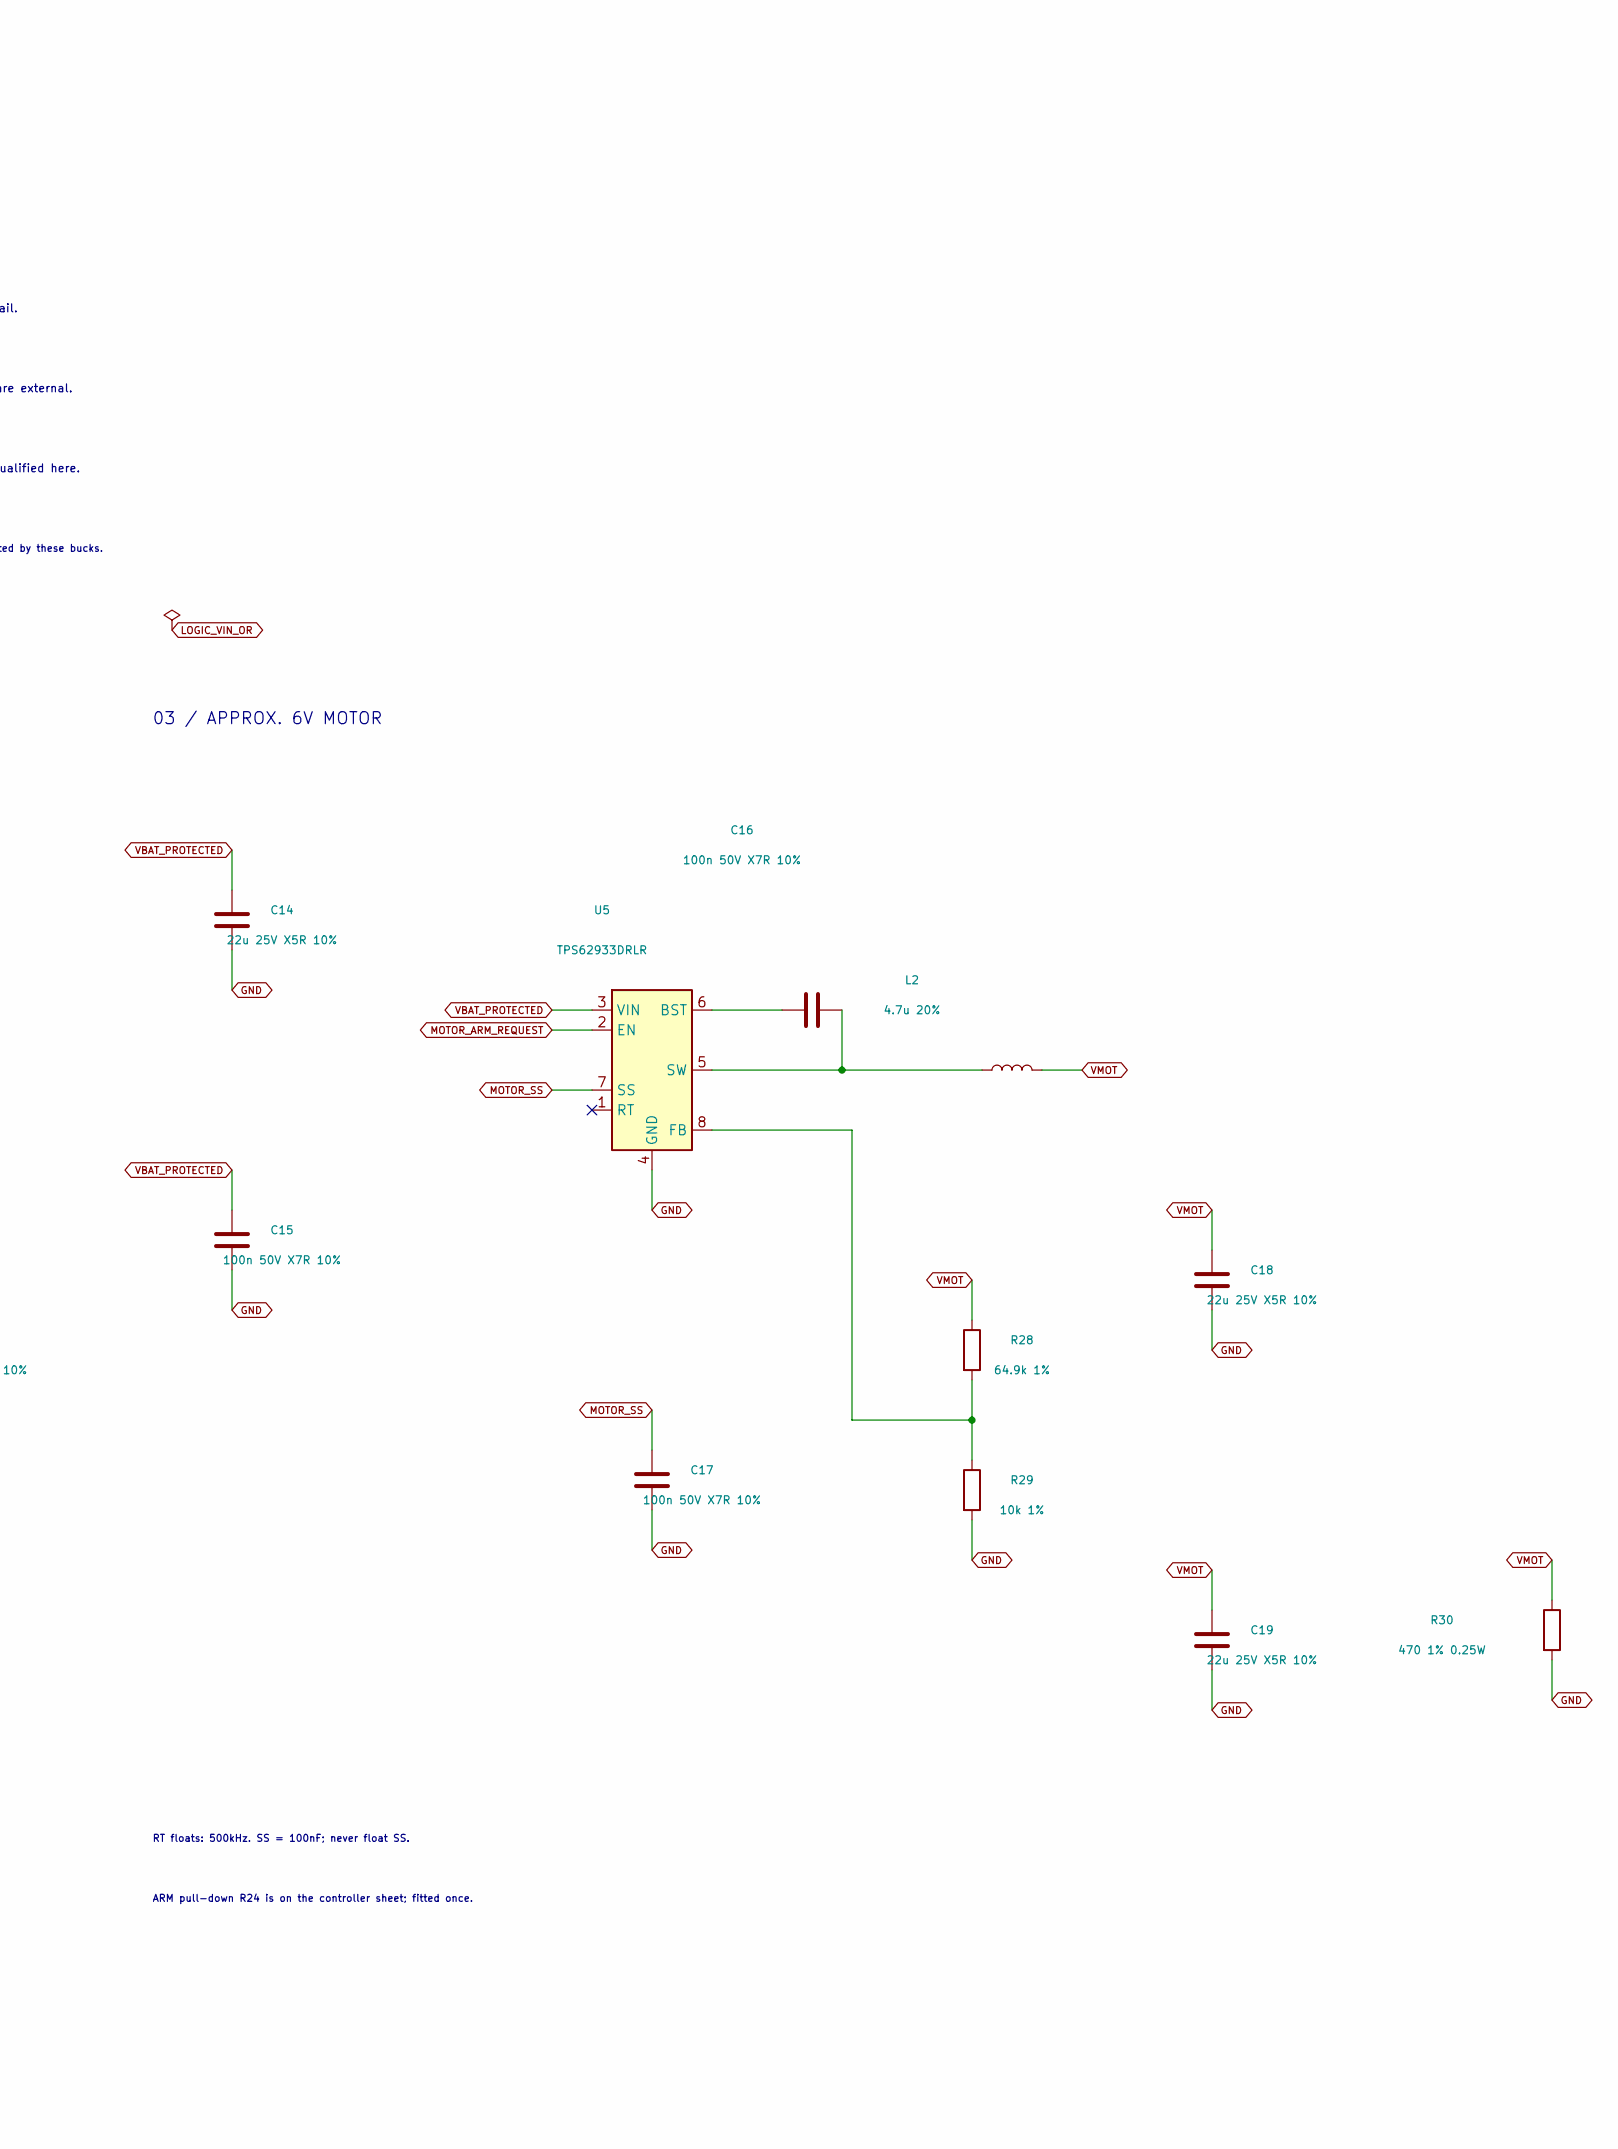
[picture p37: schematic power_stage.kicad_sch, Top-board power candidate / not released, part in row 1, column 2]

Parts:
C7, C11, C14, C18, C19: 22u 25V X5R 10%; C_1206_3216Metric; mpn CL31A226KAHNNNE; LCSC C12891
C8, C15, C16, C17: 100n 50V X7R 10%; C_0603_1608Metric; mpn CC0603KRX7R9BB104; LCSC C14663
C9: 33p 50V C0G 5%; C_0603_1608Metric; mpn CL10C330JB8NNNC; LCSC C1663
D1, D2: SS14 / REVIEW; D_SMA; LCSC C2480
L1: 2.2u 20%; L_Sunlord_MWSA0603S; mpn MWSA0603S-2R2MT; LCSC C408445
L2: 4.7u 20%; L_Sunlord_MWSA0603S; mpn MWSA0603S-4R7MT; LCSC C408447
R26: 135k 1%; R_0603_1608Metric
R27: 30k 1%; R_0603_1608Metric; mpn 0603WAF3002T5E; LCSC C22984
R28: 64.9k 1%; R_0603_1608Metric; mpn 0603WAF6492T5E; LCSC C14891
R29, R31, R32: 10k 1%; R_0603_1608Metric; mpn 0603WAF1002T5E; LCSC C25804
R30: 470 1% 0.25W; R_1206_3216Metric
U4: TPS563252DRLR; SOT-563; LCSC C19188399
U5: TPS62933DRLR; SOT-583-8; LCSC C3200405

Connections:
GND: C7.2, C8.2, C11.2, C14.2, C15.2, C17.2, C18.2, C19.2, R27.2, R29.2, R30.2, R32.2, U4.3 (GND), U5.4 (GND); also elsewhere on the board
LOGIC_VIN_OR: C7.1, C8.1, D1.1 (K), D2.1 (K), R31.1, U4.1 (VIN)
MAIN_3V3: C9.1, C11.1, L1.2, R26.1; also elsewhere on the board
MOTOR_ARM_REQUEST: U5.2 (EN); also elsewhere on the board
MOTOR_SS: C17.1, U5.7 (SS)
unnamed: R31.2, R32.1, U4.5 (EN)
unnamed: C9.2, R26.2, R27.1, U4.6 (FB)
unnamed: L1.1, U4.2 (SW)
unnamed: C16.1, U5.6 (BST)
unnamed: R28.2, R29.1, U5.8 (FB)
unnamed: C16.2, L2.1, U5.5 (SW)
VBAT_PROTECTED: C14.1, C15.1, D2.2 (A), U5.3 (VIN); also elsewhere on the board
VBUS_RAW: D1.2 (A); also elsewhere on the board
VMOT: C18.1, C19.1, L2.2, R28.1, R30.1; also elsewhere on the board

Notes on the sheet:
WHITEBOARDBOT / TOP BOARD / POWER CANDIDATE
NOT RELEASED: USB behavior, protection, effective LC, thermal, BOM and PCB remain open.
01 / SOURCE SEPARATION
USB enters the logic rail only. Motor input is the protected battery rail.
Top-board scope only. Battery/charger and existing bottom drivers are external.
D1/D2 block forward backfeed, but reverse leakage is NOT zero or qualified here.
Protected-input label is an interface requirement: protection is NOT implemented by these bucks.
02 / 3.3V LOGIC / TPS563252
EN: 10k / 10k divider. Never connect EN directly to the 2S input.
Internal bootstrap and 1.6ms typical soft start. PG unused.
C9 is feed-forward across R26; effective output C remains to qualify.
03 / APPROX. 6V MOTOR
RT floats: 500kHz. SS = 100nF; never float SS.
ARM pull-down R24 is on the controller sheet; fitted once.
Bottom VMOT already has nominal 220u + 100u + 100u + 3 x 100n.
R30 is a passive bleeder, NOT immediate shutdown or a regenerative brake clamp.
L1/L2 and bulk/bypass capacitors have exact MPNs. Loop, thermal and complete BOM remain unqualified.

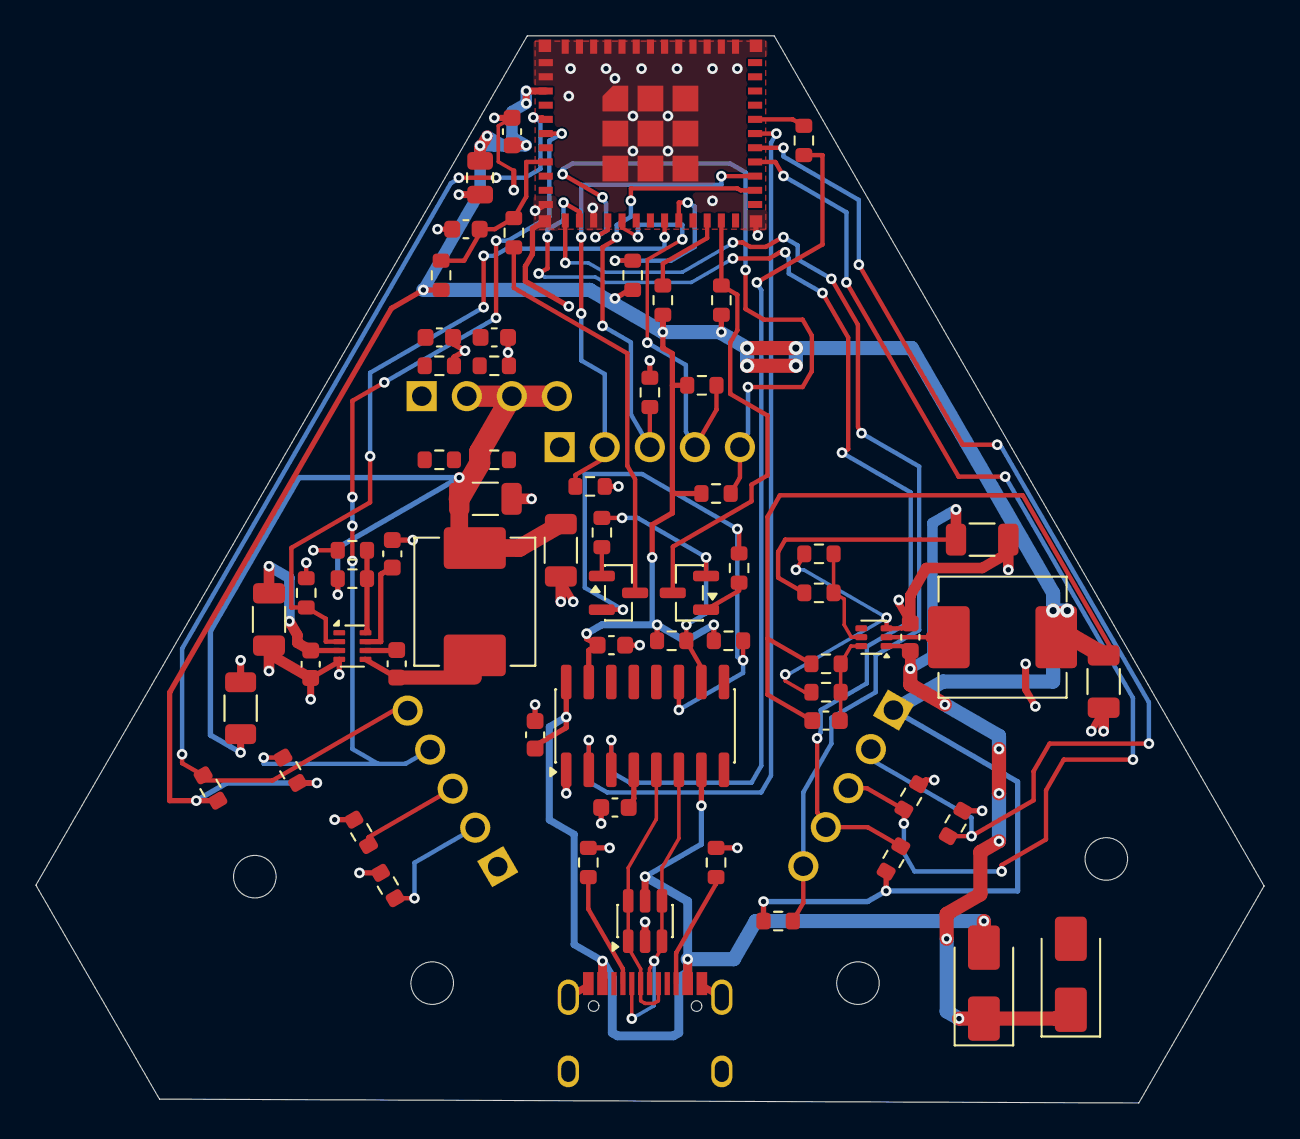
[picture p38: board top_board_v2_logic.kicad_pcb from above]

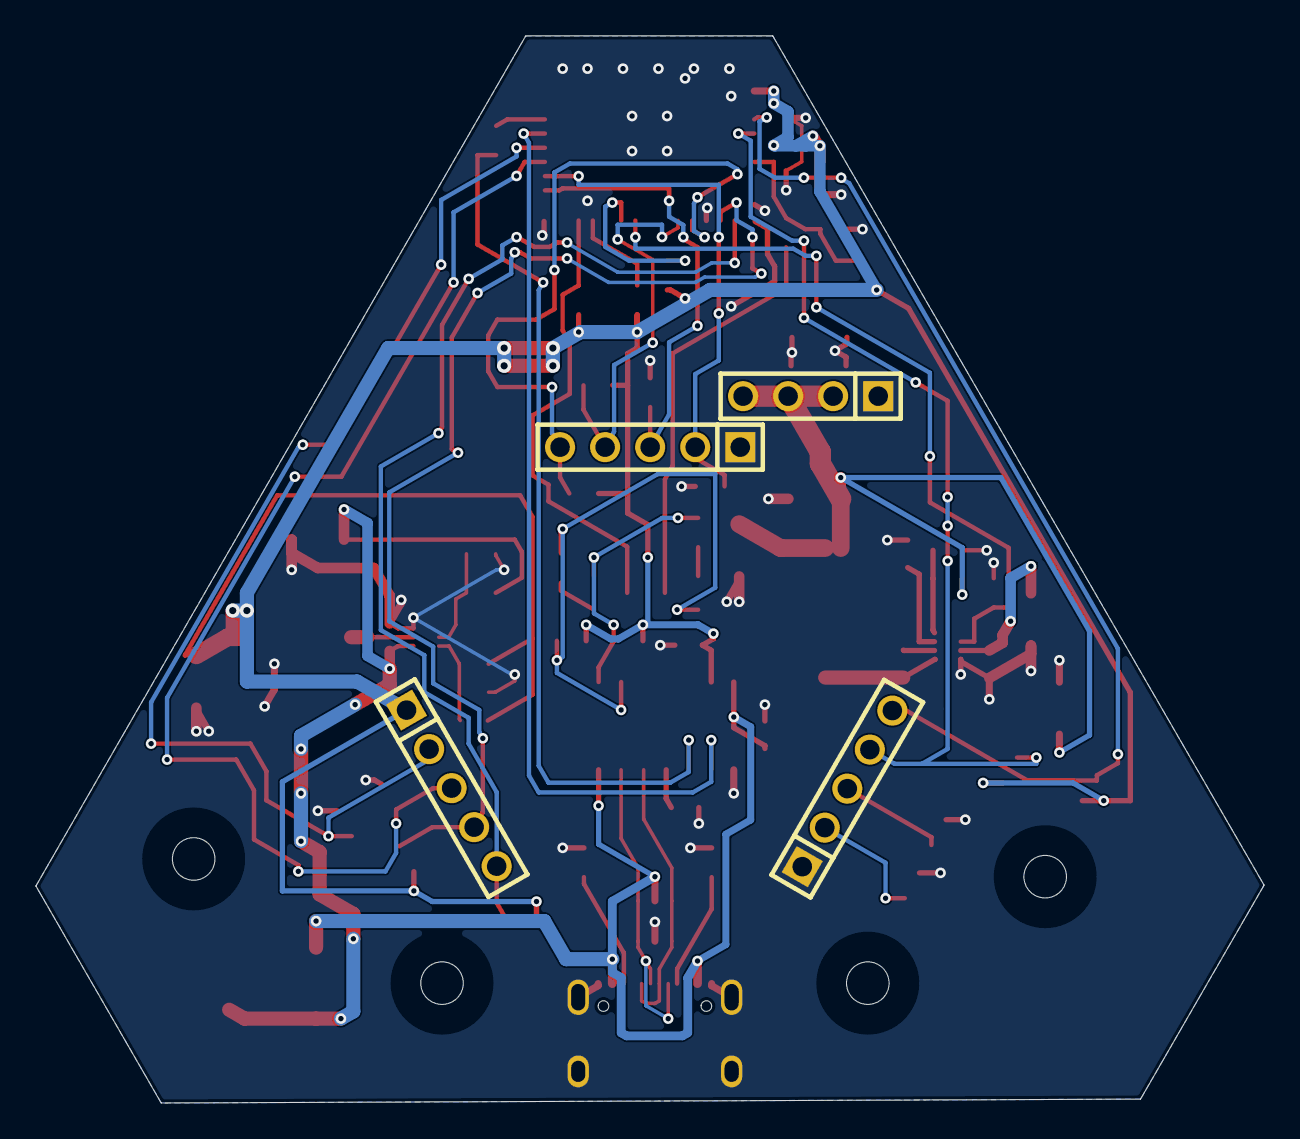
[picture p39: board top_board_v2_logic.kicad_pcb from below]

Board: 2 copper layers, 69.2 x 60.2 mm, 74 parts (4 on the bottom side), 45 nets.

Other parts of the board:
MH1, MH2, MH3, MH4: M2 carrier reserve: NPTH 2.4 / boss 6.0; Carrier_M2_NPTH_2.4mm_Reserve_6mm
