OAK-WJR/mooon-whiteboard-robot/c6_selftest/src/main.cpp

// WhiteBoardBot interactive hardware diagnostics (ESP32-C6 + adapter board + driver base board)
// Check point by point with serial commands, without reflashing again and again.
//
// Pins (pairing measured 2026-07):
//   M0 header -> base H2 -> physical motor 1 | M1 header -> base H1 -> physical motor 3 | M2 header -> base H3 -> physical motor 2
#include <Arduino.h>
#include "soc/gpio_reg.h"

#ifdef WBB_TOP_BOARD_R3
#include <esp_system.h>
#include "board_profile_r3.h"
#include "r3_gpio_safe.h"
static r3::MotorArmSafeLow motorArmLow;
static r3::DiagnosticMotorSafeLow motorOutputsLow;

// R3 is a read-only diagnostic, not the legacy motor bench below. No LEDC,
// charger/I2C, motor supply selection, or encoder-output test is initialized.
static char input[64];
static size_t inputLength = 0;
static bool discardLine = false, rebootPending = false;
static uint32_t rebootAt = 0, session = 0, txDropped = 0;
static const char* lastError = "";
static bool encodersInitialized = false;

static const char* gpioFault() {
    if (motorArmLow.error() != ESP_OK) return "GPIO21_SAFE_LOW_FAILED";
    if (motorOutputsLow.error() != ESP_OK) return "MOTOR_GPIO_SAFE_LOW_FAILED";
    return nullptr;
}

static bool allLow() {
    if (!motorArmLow.holdLow()) { lastError = "GPIO21_SAFE_LOW_FAILED"; return false; }
    if (!motorOutputsLow.holdLow()) { lastError = "MOTOR_GPIO_SAFE_LOW_FAILED"; return false; }
    return true;
}
static void status() {
    const char* fault = gpioFault();
    const bool encoderAvailable = encodersInitialized && !fault;
    char out[1400];
    int n = snprintf(out, sizeof(out),
        "{\"firmware\":\"wbb-r3-review-diag\",\"profile\":\"%s\","
        "\"session\":%lu,\"uptime_ms\":%lu,\"reset_reason\":%d,"
        "\"reason\":\"%s\",\"last_error\":\"%s\","
        "\"gpio_fault_latched\":%s,\"arm_gpio_error\":%d,\"arm_gpio_release_error\":%d,"
        "\"motor_gpio_error\":%d,\"motor_gpio_release_error\":%d,\"encoder_inputs_available\":%s,"
        "\"motion_enabled\":false,\"charge_enabled\":false,\"power_disconnect\":false,"
        "\"motor_voltage_mv\":null,\"motor_current_ma\":null,\"rail_3v3_mv\":null,"
        "\"serial_link\":\"cp2102n_uart0\",\"usb_disconnect_detect\":false,"
        "\"reboot_pending\":%s,\"tx_dropped\":%lu,\"motors\":[",
        r3::profile, (unsigned long)session, (unsigned long)millis(), int(esp_reset_reason()),
        fault ? fault : "BOARD_POWER_UNREVIEWED", lastError, fault ? "true" : "false",
        int(motorArmLow.error()), int(motorArmLow.releaseError()),
        int(motorOutputsLow.error()), int(motorOutputsLow.releaseError()), encoderAvailable ? "true" : "false",
        rebootPending ? "true" : "false", (unsigned long)txDropped);
    for (unsigned i = 0; i < 3 && n > 0 && n < int(sizeof(out)); ++i) {
        const auto& p = r3::headers[i];
        n += snprintf(out + n, sizeof(out) - n,
            "%s{\"header\":\"%s\",\"physical\":%u,\"fi\":%u,\"bi\":%u,"
            "\"enc_a\":%u,\"enc_b\":%u,\"a\":%s,\"b\":%s}",
            i ? "," : "", p.header, p.physical, p.fi, p.bi, p.encA, p.encB,
            encoderAvailable ? (digitalRead(p.encA) ? "1" : "0") : "null",
            encoderAvailable ? (digitalRead(p.encB) ? "1" : "0") : "null");
    }
    if (n <= 0 || n + 4 > int(sizeof(out))) { ++txDropped; return; }
    memcpy(out + n, "]}\n", 4); n += 3;
    // UART writes have no CDC timeout. Do not wait for a host or flush().
    if (!Serial || Serial.availableForWrite() < n ||
        Serial.write(reinterpret_cast<const uint8_t*>(out), n) != size_t(n)) ++txDropped;
}
static void command(const char* op) {
    allLow();
    lastError = gpioFault() ? gpioFault() : "";
    if (!strcmp(op, "hello") || !strcmp(op, "status") || !strcmp(op, "p") ||
        !strcmp(op, "s") || !strcmp(op, "stop") || !strcmp(op, "x") ||
        !strcmp(op, "h") || !strcmp(op, "?")) {
        status(); return;
    }
    if (rebootPending) lastError = "REBOOT_PENDING";
    else if (!strcmp(op, "reboot")) { rebootAt = millis(); rebootPending = true; }
    else lastError = gpioFault() ? gpioFault() : "BOARD_POWER_UNREVIEWED"; // Includes all legacy motor commands.
    status();
}
void setup() {
    // Default-low precedes serial initialization and any possible allocation.
    if (motorArmLow.begin() && motorOutputsLow.begin()) {
        for (const auto& p : r3::headers) {
            pinMode(p.encA, INPUT_PULLUP); pinMode(p.encB, INPUT_PULLUP);
        }
        encodersInitialized = true;
    }
    Serial.setTxBufferSize(4096); Serial.setRxBufferSize(512);
    Serial.begin(115200, SERIAL_8N1, r3::uartRx, r3::uartTx);
    session = esp_random(); inputLength = 0; discardLine = rebootPending = false;
    lastError = gpioFault() ? gpioFault() : ""; status();
}
void loop() {
    allLow(); // Failure remains latched; UART status/reboot stays available.
    if (rebootPending && uint32_t(millis() - rebootAt) >= 100) { esp_restart(); return; }
    for (int budget = 0; budget < 64 && Serial.available(); ++budget) {
        int c = Serial.read();
        if (c == '\n' || c == '\r') {
            if (discardLine) { lastError = "RX_OVERFLOW"; status(); }
            else if (inputLength) { input[inputLength] = 0; command(input); }
            inputLength = 0; discardLine = false;
        } else if (c < 32 || c > 126 || inputLength >= sizeof(input) - 1) {
            discardLine = true;
        } else if (!discardLine) input[inputLength++] = char(c);
    }
    delay(1);
}

#else // Preserve the adapter self-test and its existing bench commands.

struct MotorPins { const char* label; uint8_t fi, bi, encA, encB; };
static const MotorPins MOT[3] = {
    {"M0 -> base H2 -> physical motor 1", 0, 1, 16, 17},
    {"M1 -> base H1 -> physical motor 3", 2, 3, 18, 19},
    {"M2 -> base H3 -> physical motor 2", 4, 5, 20, 23},
};

static const int PWM_FREQ = 20000, PWM_RES = 8;
volatile long encCount[3] = {0, 0, 0};          // A/B quadrature x4 count with direction
volatile unsigned long encEdges[3] = {0, 0, 0}; // all edges
volatile unsigned long encBad[3] = {0, 0, 0};   // invalid transitions (A and B change together)
volatile uint8_t encPrev[3] = {0, 0, 0};
static bool pwmMode = true;          // true=LEDC PWM, false=pure DC digitalWrite
static int  duty = 64;               // start at a low duty cycle and test step by step with a current-limited supply

// Index = (prev<<2)|now, bit order A<<1|B.
static const int8_t QT[16] = {0, 1, -1, 0,  -1, 0, 0, 1,  1, 0, 0, -1,  0, -1, 1, 0};
static inline __attribute__((always_inline)) uint8_t readAB(int i) {
    uint32_t v = REG_READ(GPIO_IN_REG);
    return (uint8_t)((((v >> MOT[i].encA) & 1u) << 1) | ((v >> MOT[i].encB) & 1u));
}
static void IRAM_ATTR encIsr(void* arg) {
    int i = (int)(intptr_t)arg;
    uint8_t now = readAB(i), pv = encPrev[i];
    if (now == pv) return;
    int8_t d = QT[(pv << 2) | now];
    if (d) encCount[i] += d; else encBad[i]++;
    encEdges[i]++; encPrev[i] = now;
}
static void encZero() { for (int i = 0; i < 3; i++) { encCount[i] = 0; encEdges[i] = 0; encBad[i] = 0; } }
static void stopAll();

// Floating check: only switches internal pull-up/pull-down and reads back; the pin always stays an input.
//   pull-down reads 0 and pull-up reads 1 -> floating (encoder not powered or not connected)
//   both 1 -> driven high externally      both 0 -> pulled low externally
static void floatTest() {
    stopAll();
    Serial.println("\n--- Encoder wire floating check (input only, switching internal pull-up/down) ---");
    for (int i = 0; i < 3; i++) {
        Serial.printf("  %s\n", MOT[i].label);
        const uint8_t pins[2] = {MOT[i].encA, MOT[i].encB};
        for (int k = 0; k < 2; k++) {
            pinMode(pins[k], INPUT_PULLDOWN); delay(3); int rd = digitalRead(pins[k]);
            pinMode(pins[k], INPUT_PULLUP);   delay(3); int ru = digitalRead(pins[k]);
            const char* v = (rd == 0 && ru == 1) ? "floating (no power/not connected)" : (rd == 1 && ru == 1) ? "driven high externally" : (rd == 0 && ru == 0) ? "pulled low externally" : "?";
            Serial.printf("     ENC_%c=GPIO%-2d  pull-down->%d pull-up->%d  %s\n", k ? 'B' : 'A', pins[k], rd, ru, v);
        }
        encPrev[i] = readAB(i);
    }
}

static void useLedc(int i) {
    ledcAttach(MOT[i].fi, PWM_FREQ, PWM_RES);
    ledcAttach(MOT[i].bi, PWM_FREQ, PWM_RES);
}
static void useGpio(int i) {
    ledcDetach(MOT[i].fi); ledcDetach(MOT[i].bi);
    pinMode(MOT[i].fi, OUTPUT); pinMode(MOT[i].bi, OUTPUT);
    digitalWrite(MOT[i].fi, LOW); digitalWrite(MOT[i].bi, LOW);
}

static void drive(int i, int dir) {          // dir: +1 forward / -1 reverse / 0 stop
    if (pwmMode) {
        ledcWrite(MOT[i].fi, dir > 0 ? duty : 0);
        ledcWrite(MOT[i].bi, dir < 0 ? duty : 0);
    } else {
        digitalWrite(MOT[i].fi, dir > 0 ? HIGH : LOW);
        digitalWrite(MOT[i].bi, dir < 0 ? HIGH : LOW);
    }
}
static void stopAll() { for (int i = 0; i < 3; i++) drive(i, 0); }

static void printPins() {
    Serial.println("\n--- Live pin levels ---");
    Serial.printf("Mode: %s   Duty: %d/255\n", pwmMode ? "PWM 20kHz" : "pure DC (digitalWrite)", duty);
    for (int i = 0; i < 3; i++) {
        Serial.printf("  %s\n", MOT[i].label);
        Serial.printf("     FI=GPIO%-2d  BI=GPIO%-2d  |  ENC_A=GPIO%-2d(%d)  ENC_B=GPIO%-2d(%d)  count=%ld edges=%lu invalid=%lu\n",
                      MOT[i].fi, MOT[i].bi, MOT[i].encA, digitalRead(MOT[i].encA),
                      MOT[i].encB, digitalRead(MOT[i].encB), encCount[i], encEdges[i], encBad[i]);
    }
    Serial.println("(Encoder pins have internal pull-up on: floating/no power=1, pulled low by Hall=0)");
}

// Read-only sampling: a still Hall output being low is normal and does not mean a short.
// Never switch a GPIO connected to an encoder output to push-pull output.
static void shortTest() {
    stopAll();
    Serial.println("\n--- Encoder read-only check (cannot decide a short by itself) ---");
    printPins();
    Serial.println("With the motors stopped, turn each wheel by hand and watch the A/B levels and counts change.");
    Serial.println("If nothing ever changes, power off and test continuity, and tell apart power, harness, sensor and GPIO faults.");
}

static void help() {
    Serial.println("\n======== Commands ========");
    Serial.println("  0f 0r 0s   motor 0 (physical 1) forward/reverse/stop     1f 1r 1s / 2f 2r 2s likewise");
    Serial.println("  x          stop all");
    Serial.println("  a          auto test the 3 motors in turn (2 s each direction)");
    Serial.println("  p          print pin levels + encoder counts");
    Serial.println("  e          zero encoder counts");
    Serial.println("  w          switch PWM / pure DC drive mode");
    Serial.println("  d <0-255>  set duty cycle (e.g. d 200)");
    Serial.println("  s          encoder read-only check (low level does not mean a short)");
    Serial.println("  f          encoder wire floating check (switch internal pull-up/down, input only)");
    Serial.println("  h          help");
    Serial.println("======================");
}

static void autoTest() {
    Serial.printf("\n### Auto test: each motor forward 2 s -> stop -> reverse 2 s (duty=%d) ###\n", duty);
    for (int i = 0; i < 3; i++) {
        Serial.printf("\n[%d] %s  (FI=GPIO%d BI=GPIO%d)\n", i, MOT[i].label, MOT[i].fi, MOT[i].bi);
        for (int dir = 1; dir >= -1; dir -= 2) {
            encCount[i] = 0; encEdges[i] = 0; encBad[i] = 0;
            drive(i, dir);
            Serial.printf("    %s driving", dir > 0 ? "forward" : "reverse");
            for (int t = 0; t < 4; t++) { delay(500); Serial.print("."); }
            drive(i, 0);
            delay(300);
            Serial.printf(" count=%ld edges=%lu invalid=%lu %s\n", encCount[i], encEdges[i], encBad[i],
                          encEdges[i] > 10 ? "<-- turned!" : "<-- did not move");
        }
    }
    Serial.println("\n### Done ###");
    printPins();
}

void setup() {
    Serial.begin(115200);
    delay(2000);
    Serial.println("\n\n==========================================");
    Serial.println("  WhiteBoardBot interactive diagnostics (ESP32-C6)");
    Serial.println("==========================================");
    Serial.printf("Chip %s / Flash %luMB\n", ESP.getChipModel(),
                  (unsigned long)(ESP.getFlashChipSize() / 1048576));

    for (int i = 0; i < 3; i++) {
        useLedc(i); drive(i, 0);
        pinMode(MOT[i].encA, INPUT_PULLUP);
        pinMode(MOT[i].encB, INPUT_PULLUP);
    }
    delay(5);
    for (int i = 0; i < 3; i++) {
        encPrev[i] = readAB(i);
        attachInterruptArg(digitalPinToInterrupt(MOT[i].encA), encIsr, (void*)(intptr_t)i, CHANGE);
        attachInterruptArg(digitalPinToInterrupt(MOT[i].encB), encIsr, (void*)(intptr_t)i, CHANGE);
    }

    printPins();
    help();
    Serial.println("\nTip: if none of the three motors move, first check that the XT30 battery is plugged in and charged -");
    Serial.println("      encoders run on 3V3 (powered by USB), motors run on BAT+ (battery required).");
    Serial.print("\n> ");
}

void loop() {
    static char buf[32]; static int len = 0;
    while (Serial.available()) {
        char c = Serial.read();
        if (c == '\n' || c == '\r') {
            if (len == 0) { Serial.print("> "); continue; }
            buf[len] = 0;
            String cmd = String(buf); cmd.trim(); len = 0;

            if (cmd == "x") { stopAll(); Serial.println("All stopped"); }
            else if (cmd == "p") printPins();
            else if (cmd == "h" || cmd == "?") help();
            else if (cmd == "a") autoTest();
            else if (cmd == "s") shortTest();
            else if (cmd == "f") floatTest();
            else if (cmd == "e") { encZero(); Serial.println("Encoders zeroed"); }
            else if (cmd == "w") {
                stopAll(); pwmMode = !pwmMode;
                for (int i = 0; i < 3; i++) pwmMode ? useLedc(i) : useGpio(i);
                Serial.printf("Drive mode -> %s\n", pwmMode ? "PWM 20kHz" : "pure DC");
            }
            else if (cmd.startsWith("d")) {
                int v = cmd.substring(1).toInt();
                if (v >= 0 && v <= 255) { duty = v; Serial.printf("Duty = %d/255\n", duty); }
            }
            else if (cmd.length() == 2 && cmd[0] >= '0' && cmd[0] <= '2') {
                int i = cmd[0] - '0';
                char d = cmd[1];
                encCount[i] = 0; encEdges[i] = 0; encBad[i] = 0;
                drive(i, d == 'f' ? 1 : (d == 'r' ? -1 : 0));
                Serial.printf("Motor %d %s (FI=GPIO%d BI=GPIO%d, %s duty=%d)\n", i,
                              d == 'f' ? "forward" : (d == 'r' ? "reverse" : "stop"),
                              MOT[i].fi, MOT[i].bi, pwmMode ? "PWM" : "DC", duty);
            }
            else Serial.printf("Unknown command '%s' (h=help)\n", cmd.c_str());
            Serial.print("> ");
        } else if (len < 30) buf[len++] = c;
    }
}
#endif
