OAK-WJR/mooon-whiteboard-robot/test/test_all.cpp

/**
 * WhiteBoardBot full simulation test suite
 *
 * Runs on the desktop (native), no ESP32 hardware needed:
 *   pio test -e native
 *
 * Test modules:
 *   1. Kinematics — forward/inverse consistency / symmetry / extreme values / direction sweep
 *   2. PID    — step / limits / anti-windup / direction change / disturbance / different motor models
 *   3. Odometry — straight / strafe / rotation / arc / long-run drift / reverse
 *   4. Full chain — closed-loop tracking / accel-decel / emergency stop / circular motion / saturation recovery / three-phase motion
 */

#include <cstdio>
#include <cmath>
#include <cstdlib>
#include <cfloat>

// ---- Project modules (pure math, no Arduino dependency) ----
#include "config.h"
#include "kinematics.h"
#include "pid_controller.h"

// Include the implementation files directly (avoids link problems; these are pure math with no Arduino dependency)
#include "kinematics.cpp"
#include "pid_controller.cpp"

// Pose2D is defined in odometry.h, but that header depends on Arduino
struct Pose2D {
    float x     = 0.0f;
    float y     = 0.0f;
    float theta = 0.0f;
};

// ============================================================
// Simple test framework
// ============================================================
static int tests_run    = 0;
static int tests_passed = 0;
static int tests_failed = 0;
static int section_run  = 0;
static int section_fail = 0;

#define ASSERT_NEAR(actual, expected, tol, msg) do { \
    tests_run++; section_run++; \
    float _a = (actual), _e = (expected), _t = (tol); \
    if (fabsf(_a - _e) <= _t) { tests_passed++; } \
    else { tests_failed++; section_fail++; \
        printf("  FAIL: %s\n    actual=%.6f  expected=%.6f  tol=%.6f\n", \
               msg, (double)_a, (double)_e, (double)_t); } \
} while(0)

#define ASSERT_TRUE(cond, msg) do { \
    tests_run++; section_run++; \
    if (cond) { tests_passed++; } \
    else { tests_failed++; section_fail++; printf("  FAIL: %s\n", msg); } \
} while(0)

#define SECTION_BEGIN(name) do { \
    section_run = 0; section_fail = 0; \
    printf("\n=== %s ===\n", name); \
} while(0)

#define SECTION_END(name) do { \
    printf("  [%s] %d/%d passed\n", name, section_run - section_fail, section_run); \
} while(0)

// ============================================================
// Simulated odometry (does not use Arduino encoder interrupts)
// ============================================================
class SimOdometry {
public:
    SimOdometry(const Kinematics& kin, int encoder_cpr)
        : kin_(kin), encoder_cpr_(encoder_cpr) {}

    void reset() {
        pose_ = {0, 0, 0};
        velocity_ = {0, 0, 0};
        for (int i = 0; i < 3; i++) {
            simulated_counts_[i] = 0;
            prev_counts_[i] = 0;
            fractional_counts_[i] = 0;
        }
    }

    void simulateWheelVelocities(const float wheel_v[3], float dt) {
        float cpr4 = (float)(encoder_cpr_ * 4);
        float wheel_circumference = 2.0f * M_PI * kin_.getWheelRadius();
        for (int i = 0; i < 3; i++) {
            float revolutions = wheel_v[i] * dt / wheel_circumference;
            fractional_counts_[i] += revolutions * cpr4;
            simulated_counts_[i] = (long)fractional_counts_[i];
        }
    }

    void update(float dt) {
        if (dt <= 0.0f) return;
        float cpr4 = (float)(encoder_cpr_ * 4);
        float wheel_circumference = 2.0f * M_PI * kin_.getWheelRadius();
        WheelVelocity wv;
        for (int i = 0; i < 3; i++) {
            long delta = simulated_counts_[i] - prev_counts_[i];
            prev_counts_[i] = simulated_counts_[i];
            float revolutions = (float)delta / cpr4;
            wv.v[i] = (revolutions * wheel_circumference) / dt;
        }
        velocity_ = kin_.forward(wv);
        float half_dtheta = velocity_.omega * dt * 0.5f;
        float cos_th = cosf(pose_.theta + half_dtheta);
        float sin_th = sinf(pose_.theta + half_dtheta);
        pose_.x     += (velocity_.vx * cos_th - velocity_.vy * sin_th) * dt;
        pose_.y     += (velocity_.vx * sin_th + velocity_.vy * cos_th) * dt;
        pose_.theta += velocity_.omega * dt;
        while (pose_.theta >  M_PI) pose_.theta -= 2.0f * M_PI;
        while (pose_.theta < -M_PI) pose_.theta += 2.0f * M_PI;
    }

    const Pose2D& getPose() const { return pose_; }
    const BodyVelocity& getVelocity() const { return velocity_; }

private:
    const Kinematics& kin_;
    int encoder_cpr_;
    Pose2D pose_;
    BodyVelocity velocity_;
    long simulated_counts_[3] = {0, 0, 0};
    long prev_counts_[3] = {0, 0, 0};
    double fractional_counts_[3] = {0, 0, 0};
};
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
