OAK-WJR/mooon-whiteboard-robot/control_tests/test_r3_motor_gpio.cpp

// Actual driver with Arduino 3.3.9 GPIO/peripheral ownership semantics.
// Shared mocks stay untouched; only this translation unit replaces their APIs.
#ifndef WBB_TOP_BOARD_R3
#error Build this regression with the R3 defines and public config defaults.
#endif
#define digitalWrite permissiveDigitalWrite
#define pinMode permissivePinMode
#define ledcAttach permissiveLedcAttach
#define ledcWrite permissiveLedcWrite
#define ledcDetach permissiveLedcDetach
#include "mock/Arduino.h"
#undef digitalWrite
#undef pinMode
#undef ledcAttach
#undef ledcWrite
#undef ledcDetach
#include "mock/driver/gpio.h"
#include <iostream>
#include <stdexcept>

namespace boundary {
enum Owner { None, GPIO, LEDC, Other };
inline std::array<Owner, 64> owner{};
inline std::array<int, 64> retainedDuty{};
inline int failClearPin = -1, failRegisterPin = -1;
inline unsigned attachCalls = 0;
inline void event(const char* op, int pin) {
    gpio_mock::events.push_back({op, pin, levels.at(pin), 0,
                                levels[21], gpio_mock::outputEnabled[21]});
}
}

inline bool ledcDetach(unsigned pin) {
    pinOperations.push_back({"detach", int(pin), 0});
    if (boundary::owner.at(pin) != boundary::LEDC || int(pin) == failDetachPin) return false;
    // Pinned ledcDetachBus reconnects SIG_GPIO_OUT_IDX without zeroing its latch.
    boundary::event(gpio_mock::outputEnabled[pin] ? "detach_driven" : "detach_disabled", pin);
    boundary::retainedDuty[pin] = duties[pin];
    attached[pin] = false; duties[pin] = 0; boundary::owner[pin] = boundary::None;
    return true;
}
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
