OAK-WJR/mooon-whiteboard-robot/(commit log)

2026-06-17 Initial commit: WhiteBoardBot 三轮全向轮机器人
    - ESP32 固件: 三电机 FF+PID 控制、里程计、轨迹跟踪、WiFi/UDP 通信
    - ROS2 工作区: 轨迹控制、视觉节点、仿真里程计
    - Docker 可视化环境、调试脚本、PCB 网表与项目报告
    - WiFi 凭证经 include/config.h（git 忽略）隔离，提供 config.example.h 模板
2026-06-17 refactor: drop ROS2, switch to ESP32-autonomous firmware
    - Remove ros2_ws/, docker/, micro-ROS main.cpp and esp32dev/esp32wifi envs
    - Promote standalone auto firmware to main.cpp; default_envs=esp32
    - Add in-firmware serial live-tuning console (PID/speed/lookahead/telemetry, no reflash)
    - Make TrajectoryFollower lookahead/goal-tol/linear-gain runtime-tunable
    - Restore $-frame telemetry so pid_tuner.py plots work
    - Prune scripts to control panel + PID tuner; drop micro-ROS config macros
    - Rewrite README + PROJECT_REPORT for the no-ROS architecture
2026-06-17 chore: project-local PlatformIO core_dir for isolated, disposable env
    core_dir=.platformio keeps toolchain/framework inside the project (1.5G) instead of ~/.platformio, so 'rm -rf' the project fully cleans up. Verified: esp32 build SUCCESS, ~/.platformio untouched.
2026-06-17 tune: auto-tuned per-motor PID (sim), native 151->172/175
    tools/autotune.cpp: coordinate-descent over the real PIDController against a
    per-motor first-order plant (kf_true, tau) + encoder quantization + EMA feedback.
    Each motor gets distinct gains (M0/M1/M2 differ by kf_true/tau). Kd->0 removes the
    50Hz limit-cycle; Kf set to each motor's DC gain; Ki cleans steady-state.
    Remaining 3 failures are the anti-windup saturation test (expects integral to peg
    its clamp; good tuning converges instead). Real per-motor calibration: measure each
    motor's kf_true/tau via motor_test and regenerate.
    [autotune.cpp, config.example.h]
2026-06-17 feat: USB-serial navigation path (no WiFi needed)
    - wifi_comm: non-blocking connect (8s timeout) so the console runs over USB without WiFi
    - main.cpp: 'j' toggles a pose-JSON serial stream (10Hz) for visualization
    - serial_bridge.py: serial<->UDP bridge so whiteboard_app.py runs unchanged over USB
    - sim_robot.py: local no-hardware simulator (optional)
2026-06-17 tune: real per-motor PID from hardware-measured kf_true (M0=504 M1=636 M2=515)
    Measured each motor's DC gain on the bench (open-loop PWM=200) and fed it into
    tools/autotune.cpp. Each motor now has distinct gains (Kf = its own kf_true).
    M1 needed higher PWM to overcome stiction; encoders on all three verified good.
2026-06-17 tune: M0 PID from manual bench tuning (Kp500 Ki10 Kd50 Kf470)
    M0 hand-tuned in the PID Tuner GUI on real hardware; M1/M2 keep measured-kf values.
2026-06-17 tune: M1 PID from manual bench tuning (Kp500 Ki400 Kd70 Kf410)
    M1 motor runs stiff; large Ki pushes through the deadband. M0/M2 unchanged.
    [config.example.h]
2026-06-17 feat: point-to-point navigation + 2D click-to-go display
    Firmware: PathPlanner.generateGoto (current->target line) + 'goto {x,y}' command
    (UDP + serial) that plans from current pose and drives immediately.
    GUI (whiteboard_app.py): left-click the 2D map to set a target and go; live robot
    pose marker + heading line, target star, and straight-line plan preview.
2026-06-17 fix: stiction feedforward so low-speed nav overcomes static friction
    Bench finding: motors spin fine at PWM=200 (M0/M1/M2 = 0.38/0.31/0.29 m/s) but the
    nav PID at 0.15 m/s only commanded ~100-116 PWM — below the ~150-200 breakaway — so
    wheels stuck (actual=0) and the integral slowly wound up (jerky/banana motion).
    Add MOTOR_STICTION_PWM (80) to the control output when commanding motion. Verified:
    wheels now turn at nav speed and goto reaches the goal.
    [config.example.h, robot_controller.cpp]
2026-06-17 fix: per-motor measured stiction, applied only while wheel is stalled
    Measured breakaway PWM open-loop: M0=100, M1=140, M2=140 (global 80 was below M1/M2
    breakaway, above M0 -> asymmetric -> spurious rotation). Now per-motor, applied only when
    |actual|<MOTOR_BREAKAWAY_VEL (kick, not persistent offset) to avoid free-spin overshoot.
    [config.example.h, robot_controller.cpp]
2026-06-17 fix: power off WiFi radio in USB mode to cut ENC1 RF noise
    When WiFi times out (USB testing), WiFi.mode(WIFI_OFF) removes RF noise on the
    GPIO36/39 (ENC1) input-only pins. Idle M1 now reads clean 0. (Residual phantom while
    M1's motor drives is PWM->encoder crosstalk on M1's wiring, needs HW fix: pull-ups on
    36/39 + route encoder lines away from motor PWM.)
    [wifi_comm.cpp]
2026-06-17 fix: velocity sanity gate + gentle M1 gains to suppress ENC1 PWM crosstalk
    - odometry: reject any wheel velocity > MAX_WHEEL_VEL (0.45) as encoder noise — kills
    the constant ~0.58 m/s phantom from M1 motor-PWM crosstalk into ENC1 (GPIO36/39).
    - M1 gains back to gentle measured-kf autotune (Kp63/Ki4/Kd0/Kf636); the big Ki=400 was
    amplifying residual crosstalk. Stiction FF now handles breakaway, so Ki no longer needed.
    Verified: M1 PWM -2..-35 (was pinned -255), actual 0.02..0.05 (was ghost 0.58).
    [config.example.h, odometry.cpp]
2026-06-17 feat: terminal deceleration so goto settles at the target (no orbit)
    Slow to MIN_APPROACH_SPEED within END_DECEL_DIST of the goal so the robot creeps in
    and stops (state=done) instead of overshooting and orbiting. GOAL_TOLERANCE=2cm — the
    bench sweet spot; 8mm can't settle on a flipped no-load chassis (overshoot > tol -> never
    done). Verified: straight path (len=direct), done at ~1.8cm.
    [config.example.h, trajectory_follower.cpp]
2026-06-17 feat: optional heading-hold for straight-line goto (off by default)
    TrajectoryFollower can hold theta=0 via omega control to straighten the path. Gated by
    KP_ANGULAR, default 0 (omega=0). On a flipped/no-load chassis odom theta is garbage, so
    enabling it makes the robot spin (measured: theta hit 179deg, deviation 11cm). Enable
    (KP_ANGULAR~3) only once theta is trustworthy: robot on ground + clean M1 encoder.
    [config.example.h, trajectory_follower.cpp]
2026-06-17 fix: smoother motor output (ramped stiction + M1 heavy filter + per-wheel PWM slew)
    Objectively M1 is the jerky wheel (PWM jerk 56 vs M0/M2 6/12) from ENC1 crosstalk.
    - ramped (continuous) stiction instead of on/off kick — removes a jerk source for all wheels
    - heavier velocity low-pass on M1 (alpha 0.15 vs 0.3)
    - per-wheel PWM slew-rate limit, tighter on M1 (12 vs 45 PWM/cycle)
    Reduces M1 jerk 56->44; residual is HW-limited (M1 encoder needs pull-ups + routing away
    from motor PWM). Software ceiling reached.
    [odometry.cpp, robot_controller.cpp]
2026-06-17 fix: run M1 open-loop (feedforward-only) to escape its noisy encoder
    M1's ENC1 (GPIO36/39) crosstalk is sustained, not impulsive — EMA/heavy-LP/median all
    failed (median made it worse: jerk 69). The fix is to NOT close the loop on a broken sensor:
    M1 -> pure feedforward (Kp=Ki=Kd=0, Kf=636). PWM = Kf*target is inherently smooth.
    Result: M1 PWM jerk 44-69 -> 16 (matches M0/M2 at 19/22); straightness 1.9cm avg.
    [config.example.h]
2026-06-17 revert: M1 back to closed-loop (open-loop ran uncontrolled/too fast)
    Open-loop M1 was smooth but unregulated -> ran too fast. Closed-loop regulates speed but
    is jerky from ENC1 crosstalk. Neither is good: M1 cannot be both smooth and accurate in SW
    because its encoder is broken. Hardware fix required (pull-ups on GPIO36/39 + route away
    from M1 motor PWM).
    [config.example.h]
2026-08-12 feat: 移植固件到 ESP32-C6 + 加堵转保护
    硬件已换成 Waveshare ESP32-C6-LCD-1.47 插转接板方案, 固件跟进。
    C6 移植 (与 ESP32 版共用一份源码, config.h 条件编译区分):
    - 引脚按物理电机顺序绑定。转接板排针与底板座子实测配对是错位的
    (M0头→底板H2=电机1, M1头→底板H1=电机3, M2头→底板H3=电机2),
    故 [1] 取 M2 头的脚、[2] 取 M1 头的脚, 运动学矩阵无需改动。
    - 编码器 ENC0=16/17 ENC1=20/23 ENC2=18/19; 避开 GPIO12/13(USB烧录)、
    GPIO9(BOOT)、6/7/8/14/15/21/22(屏幕板占用)。
    - LEDC 接口抹平 core 2.x/3.x 差异 (3.x 按引脚操作, 内核自动分配通道)。
    - 删除 adc_powe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
2026-09-07 feat: USB diagnostics firmware with host-tested safety interlock
    usb_diagnostics/ drives one wheel at a time over USB serial with a dead-man
    stop; scripts/pcb_diagnostics.py is the host side.
    Snapshot reconstructed on 2026-10-28 from file modification times.
2026-09-08 docs: base-board review, charging research, mounting and sourcing notes
    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
2026-09-08 hardware: R2 4-layer re-verification and EasyEDA round trip
    Corner refinement, D3/D5 polarity fix, LED repair and a verified
    KiCad -> EasyEDA -> KiCad round trip (19 board-to-board pins matched).
    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
2026-09-08 feat: board profiles and safe GPIO init for the top_board_v2 variants
    R3 / KISS C6 / Pico board profiles, GPIO-safe boot state, BQ76905 and
    INA3221 monitor interfaces, control session over USB/Wi-Fi/BLE.
    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
2026-09-08 test: host-side control tests for board profiles and runtime commands
    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
2026-09-08 hardware: KISS 6V direction - one motor voltage, reuse the base board
    Simplify after R3 grew to 147 parts: keep the base board's three RZ7889
    drivers and 19 contacts, use ready-made modules.
    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
2026-09-09 feat: Pico I2C transport, rail service and battery monitors
    BQ76905 cell monitor and INA3221 rail monitor drivers, Pico watchdog,
    and a project-local patch of the ESP-IDF I2C master (third_party/).
    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
2026-09-09 test: BQ76905 device model and Pico I2C/rail mocks
    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
2026-09-09 hardware: KISS 6V power, charge-input and cell-monitor integration
    Includes the 2S battery selection notes. Layout paused for cost.
    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
2026-09-09 hardware: base-board copper audit
    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
2026-09-09 hardware: budget 6V controller core for JLC assembly
    Target: five assembled top boards for about 30 CNY each.
    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
2026-09-09 feat: KISS C6 profile - radio power and battery voltage sensing
    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
2026-09-09 hardware: ESP32-C6-MINI logic-board placement study
    70 parts, ERC clean, not routed; budget not met yet.
    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
    [bottom_interfaces.kicad_sch, controller.kicad_sch, power_stage.kicad_sch, top_board_v2_logic.kicad_pcb, top_board_v2_logic.kicad_sch, usb_recovery.kicad_sch, voltage_sense.kicad_sch]
2026-09-18 feat: self-test firmware for adapter v2 bring-up
    Runs each motor slot both ways and counts encoder edges; used to
    verify the re-spun adapter after the reversed M1 header.
    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
    [main.cpp]
2026-09-22 feat(c6_drive): Wi-Fi driving firmware, system ID and MuJoCo simulation
    Web WASD control, 100 Hz per-wheel feed-forward + PI, LCD status,
    system identification scripts and a robust-controller study in sim.
    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
    [robot.xml]
2026-09-22 feat(c6_drive): encoder hold, encoder servo and load-servo experiments
    Also Wi-Fi provisioning over USB. Wall test: the robot slid down the
    board because wheel encoders cannot see chassis slip.
    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
    [partitions.csv]
2026-10-04 feat(c6_drive): replacement board bring-up and floor-response campaigns
    Controller revisions tried on the floor with camera-free metrics;
    gain scheduling and the edge-period estimator were rejected.
    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
    [c6_drive_sysid.py, c6_floor_campaign.py, c6_floor_excitation.py, c6_floor_jitter_probe.py, c6_floor_polarity.py, c6_floor_pulse_campaign.py, c6_floor_response_report.py, c6_floor_reversal.py]
2026-10-04 feat(c6_drive): coordinated stop and encoder heading correction
    Final yaw after a stop 3.4 -> 1.0 deg (left) and 2.9 -> 0.6 deg (right),
    but motion still felt jerky and the robot could not hold on the wall.
    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
    [c6_floor_comparison.py, c6_floor_model_report.py, control.h, main.cpp, network_config.h, network_request.h, test_floor_model_report.py, test_floor_trial.cpp]
2026-10-25 feat(c6_wall): new wall firmware project with Wi-Fi OTA
    OTA partitions with rollback; the web page is gzipped into the image at
    build time.
    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
    [partitions.csv]
2026-10-27 feat(c6_wall): camera ground truth, slip model and full-board coverage run
    An iPhone camera tracks the LCD beacon against four corner tapes and
    sends live position fixes. Coverage run: back to the origin within 1 mm.
    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
2026-10-27 hardware: top_board_v2_logic imported into EasyEDA
    From EasyEDA backup versions/20261027-085556-before-schematic-cleanup.epro2.
2026-10-27 hardware: redraw the schematic as one compact A3 sheet (v2.1)
    From EasyEDA backup versions/20261027-111123-schematic-a3-compact-v2.1.epro2.
2026-10-27 hardware: move IMU, ADC and IR to a separate sensor-head board
    From EasyEDA backup versions/20261027-114124-sensor-parts-moved-to-head.epro2.
2026-10-27 hardware: remap GPIOs so each header uses the nearest module pads
    From EasyEDA backup versions/20261027-131225-gpio-remap-schematic.epro2.
2026-10-27 feat: KISS C6 board profile follows the top_board_v2_logic GPIO remap
    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
2026-10-27 hardware: reroute the ESP32 escape and curve the whole board
    From EasyEDA backup versions/20261027-135357-curved-reroute-final.epro2.
2026-10-28 feat(c6_wall): pose-servo wheels, gravity memory and breakaway boost
    Every wheel is a position servo on one body reference, so stopping is
    holding. Round-trip calibration tools (campaign, fit_trips) and wheel
    diagnostics.
    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
2026-10-29 hardware: swap all parts to LCSC library parts with 3D models
    From EasyEDA backup versions/20261028-180157-before-charger-ina3221.epro2.
2026-10-29 hardware: add on-board 2S charger (IP2326) and INA3221 to the schematic
    From EasyEDA backup versions/20261028-183806-before-pcb-charger.epro2.
2026-10-29 chore: prepare the repository for open source
    - English README with the design-iteration story, status and repo map;
    READMEs for c6_wall/ and hardware/, archive notes on c6_drive/ and
    the September top-board notes.
    - MIT license for software, CERN-OHL-P-2.0 for hardware/.
    - .gitignore excludes raw experiment logs, vendor datasheets, saved
    vendor pages, 3D models and secrets (.ota_token, .robot_host, *.pem).
    - Moved the v1 report to docs/ and the v1 base-board netlist to
    hardware/v1_base_board/; dropped a third-party pinout image.
    - Demo media in docs/media/ (cropped to the whiteboard).
    Commits from 2026-08-28 to 2026-10-28 were reconstructed today from
    file modification times and Ea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
2026-10-29 docs: design history with EasyEDA previews from every saved version
    docs/design-history/make_figures.py pulls the schematic and PCB previews
    that EasyEDA stores inside motor_controller.epro2 at each commit and
    lays them out with commit hashes and dates:
    - board-generations.jpg: v1 board (Mar) -> base board and C6 adapter
    (Jul) -> top_board_v2 / R2 (Sep) -> top_board_v2_logic (Oct)
    - logic-board-evolution.jpg: eight steps of the current board,
    including a live capture from the EasyEDA editor
    - logic-schematic-before-after.jpg and v1-schematic.jpg
2026-10-29 docs: Onshape CAD history of the robot assembly
    Renders of "Assembly 1" from the Onshape document WhiteBoardBot at its
    named versions (server timestamps): V1 2026-02-13, V2 02-16, V3 03-12,
    V4 04-13, V6 09-22 and the 2026-10-27 workspace, fetched through the
    Onshape API. Adds the version table to docs/design-history and a
    February row to the README timeline.
2026-10-29 docs: clearer design-history figures
    - CAD: re-rendered every Onshape version with showAllParts, so parts
    hidden when a version was saved are visible. The base board was
    already in V6, so the "workspace" panel is dropped; five distinct
    versions remain.
    - PCBs: the v1 board preview (saved with inactive layers greyed out)
    gets an auto-contrast; the base board now shows its top view, cropped
    from the fabrication panel, instead of its bottom-view preview.
2026-11-01 Add Jerry's uncommitted Oct 28-31 work and the review README
    This commit makes the tree match the curated review snapshot.
    Jerry's own uncommitted work from Oct 28-31, 2026 (it was in his
    working copy, never committed before):
    - c6_wall firmware update (src/main.cpp) and new tools: clean_dirty.py,
    sysid_erase.py, make_demo.py (Oct 28) and draw_digits.py (Oct 31).
    - KISS C6 board profile, voltage sensing and USB host tests
    (control_tests/, include/, src/, scripts/, platformio.ini).
    - top_board_v2_logic notes, firmware-verification records and the
    EasyEDA netlist export (hardware/top_board_v2/...).
    - EasyEDA project motor_controller.epro2 as saved on Oct 30.
    Key run records copied from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
    [logic_netlist.json]
2026-11-02 Translate the Chinese comments, notes, logs and web pages into English
    [top_board_v2_logic.kicad_pcb]
